Nightshadow1258/HW_Motor_Controller/Documentation/Plots/ADC_SOx_Noise/output/ADC_SOx_1000_Measurements_ADC_SAMPLETIME_32CYCLES_5_all.jpeg

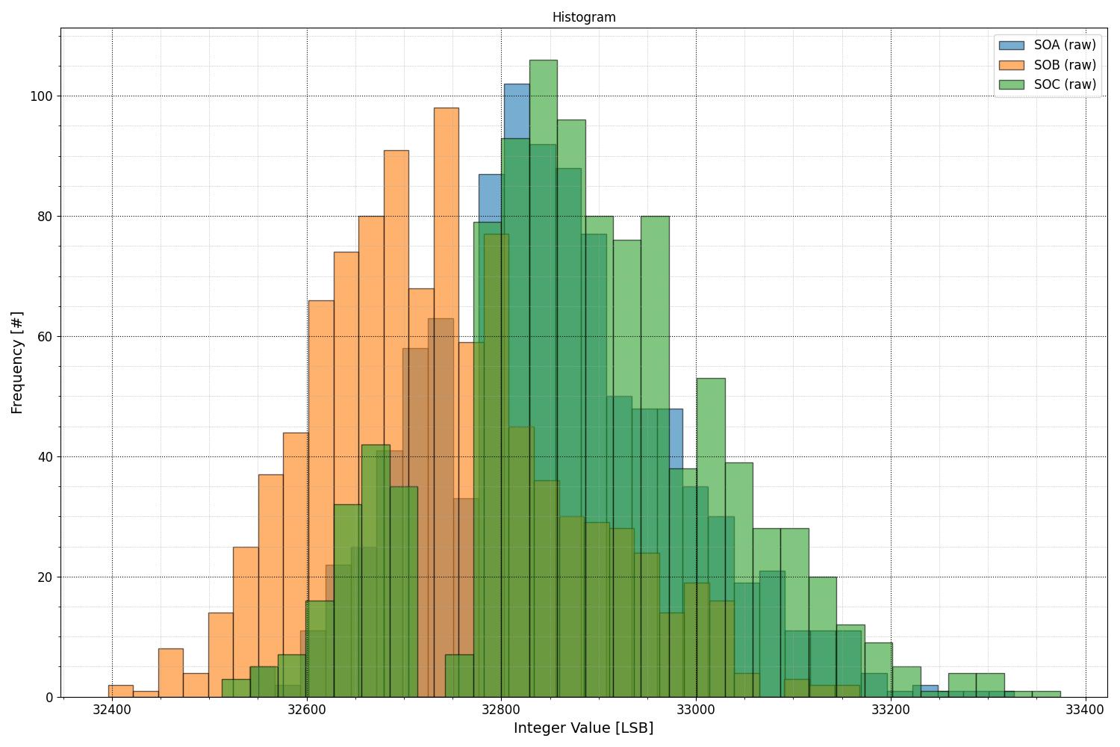
Documentation/Plots/ADC_SOx_Noise/output/ADC_SOx_1000_Measurements_ADC_SAMPLETIME_32CYCLES_5_all.jpeg
