Nightshadow1258/HW_Motor_Controller/Documentation/STMG474RE_Pinout.ods

Sheet: Front
taken from the pdf
file:///home/paul/Downloads/stm32g474re.pdf

Sheet: Pin Definitions
Name | Abbreviation | Definition
Pin name | Unless otherwise specified in brackets below the pin name, the pin function during and after reset is the same as the actual pin name
Pin type | S | Supply pin
 | I | Input only pin
 | I/O | Input / output pin
I/O structure | FT | 5 V tolerant I/O
 | TT | 3.6 V tolerant I/O
 | B | Dedicated BOOT0 pin
 | NRST | Bidirectional reset pin with embedded weak pull-up resistor
 | Option for TT or FT I/Os
 | _a(1) | I/O, with Analog switch function supplied by V DDA
 | _c | I/O, USB Type-C PD capable
 | _d | I/O, USB Type-C PD Dead Battery function
 | _f(2) | I/O, Fm+ capable
 | _u(3) | I/O, with USB function
Notes | Unless otherwise specified by a note, all I/Os are set as floating inputs during and after reset
Pin functions | Alternate functions | Functions selected through GPIOx_AFR registers
 | Additional functions | Functions directly selected/enabled through peripheral registers

Sheet: Pinout
WLCSP81 | UFQDPN48 | LQFP48 | LQDP64 | LQFP80 | TFBGA100 | LPQF100 | UFBGA121 | LPQF128 | Pin Name (function after reset) | Pin type | I/O structure | Notes | Alternate functions | Additional functions
- | - | - | - | - | C3 | 1 | A2 | 1 | PE2 | I/O | FT | - | TRACECK, TIM3_CH1, SAI1_CK1, SPI4_SCK, TIM20_CH1, FMC_A23, SAI1_MCLK_A, EVENTOUT | -
- | - | - | - | - | B2 | 2 | B2 | 2 | PE3 | I/O | FT | - | TRACED0, TIM3_CH2, SPI4_NSS, TIM20_CH2, FMC_A19, SAI1_SD_B, EVENTOUT | -
- | - | - | - | - | A1 | 3 | A1 | 3 | PE4 | I/O | FT | - | TRACED1, TIM3_CH3, SAI1_D2, SPI4_NSS, TIM20_CH1N, FMC_A20, SAI1_FS_A, EVENTOUT | -
- | - | - | - | - | B1 | 4 | B1 | 4 | PE5 | I/O | FT | - | TRACED2, TIM3_CH4, SAI1_CK2, SPI4_MISO, TIM20_CH2N, FMC_A21, SAI1_SCK_A, EVENTOUT | -
- | - | - | - | - | C2 | 5 | C3 | 5 | PE6 | I/O | FT | - | TRACED3, SAI1_D1, SPI4_MOSI, TIM20_CH3N, FMC_A22, SAI1_SD_A, EVENTOUT | WKUP3, RTC_TAMP3
B9 | 1 | 1 | 1 | 1 | D3 | 6 | C2 | 6 | VBAT | S | - | - | - | -
B8 | 2 | 2 | 2 | 2 | D4 | 7 | C1 | 7 | PC13 | I/O | FT | (2) (3) | TIM1_BKIN, TIM1_CH1N, TIM8_CH4N, EVENTOUT | WKUP2, RTC_TAMP1, RTC_TS, RTC_OUT1
C9 | 3 | 3 | 3 | 3 | C1 | 8 | D1 | 8 | PC14- OSC32_IN | I/O | FT | (2) (3) | EVENTOUT | OSC32_IN
D9 | 4 | 4 | 4 | 4 | D1 | 9 | D2 | 9 | PC15- OSC32_OUT | I/O | FT | (2) (3) | EVENTOUT | OSC32_OUT
- | - | - | - | - | - | - | D3 | 10 | PF3 | I/O | FT_f | - | TIM20_CH4, I2C3_SCL, FMC_A3, EVENTOUT | -
- | - | - | - | - | - | - | D4 | 11 | PF4 | I/O | FT_f | - | COMP1_OUT, TIM20_CH1N, I2C3_SDA, FMC_A4, EVENTOUT | -
F1 | - | - | - | - | D2 | - | E2 | 12 | VSS | S | - | - | - | -
A9 | - | - | - | - | D5 | - | E1 | 13 | VDD | S | - | - | - | -
- | - | - | - | - | - | - | E3 | 14 | PF5 | I/O | FT | - | TIM20_CH2N, FMC_A5, EVENTOUT | -
- | - | - | - | - | - | - | E4 | 15 | PF7 | I/O | FT | - | TIM20_BKIN, TIM5_CH2, QUADSPI1_BK1_IO2, FMC_A1, SAI1_MCLK_B, EVENTOUT | -
- | - | - | - | - | - | - | E5 | 16 | PF8 | I/O | FT | - | TIM20_BKIN2, TIM5_CH3, QUADSPI1_BK1_IO0, FMC_A24, SAI1_SCK_B, EVENTOUT | -
- | - | - | - | - | E3 | 10 | F3 | 17 | PF9 | I/O | FT | - | TIM20_BKIN, TIM15_CH1, SPI2_SCK, TIM5_CH4, QUADSPI1_BK1_IO1, FMC_A25, SAI1_FS_B, EVENTOUT | -
- | - | - | - | - | E4 | 11 | F4 | 18 | PF10 | I/O | FT | - | TIM20_BKIN2, TIM15_CH2, SPI2_SCK, QUADSPI1_CLK, FMC_A0, SAI1_D3, EVENTOUT | -
E9 | 5 | 5 | 5 | 5 | E1 | 12 | F1 | 19 | PF0-OSC_IN | I/O | FT_fa | - | I2C2_SDA, SPI2_NSS/I2S2_WS, TIM1_CH3N, EVENTOUT | ADC1_IN10, OSC_IN
F9 | 6 | 6 | 6 | 6 | E2 | 13 | F2 | 20 | PF1- OSC_OUT | I/O | FT_a | - | SPI2_SCK/I2S2_CK, EVENTOUT | ADC2_IN10, COMP3_INM, OSC_OUT
D8 | 7 | 7 | 7 | 7 | F3 | 14 | F5 | 21 | PG10-NRST | I/O | NRST (4) | - | MCO, EVENTOUT | NRST
E8 | - | - | 8 | 8 | F2 | 15 | G2 | 22 | PC0 | I/O | FT_a | - | LPTIM1_IN1, TIM1_CH1, LPUART1_RX, EVENTOUT | ADC12_IN6, COMP3_INM
C8 | - | - | 9 | 9 | F4 | 16 | G1 | 23 | PC1 | I/O | TT_a | - | LPTIM1_OUT, TIM1_CH2, LPUART1_TX, QUADSPI1_BK2_IO0, SAI1_SD_A, EVENTOUT | ADC12_IN7, COMP3_INP
F8 | - | - | 10 | 10 | F1 | 17 | G3 | 24 | PC2 | I/O | FT_a | - | LPTIM1_IN2, TIM1_CH3, COMP3_OUT, TIM20_CH2, QUADSPI1_BK2_IO1, EVENTOUT | ADC12_IN8
G9 | - | - | 11 | 11 | G1 | 18 | H1 | 25 | PC3 | I/O | TT_a | - | LPTIM1_ETR, TIM1_CH4, SAI1_D1, TIM1_BKIN2, QUADSPI1_BK2_IO2, SAI1_SD_A, EVENTOUT | ADC12_IN9, OPAMP5_VINP
- | - | - | - | - | G3 | 19 | H2 | 26 | PF2 | I/O | FT | - | TIM20_CH3, I2C2_SMBA, FMC_A2, EVENTOUT | -
D7 | 8 | 8 | 12 | 12 | G4 | 20 | G4 | 27 | PA0 | I/O | TT_a | - | TIM2_CH1, TIM5_CH1, USART2_CTS, COMP1_OUT, TIM8_BKIN, TIM8_ETR, TIM2_ETR, EVENTOUT | ADC12_IN1, COMP1_INM, COMP3_INP, RTC_TAMP2,WK UP1
E7 | 9 | 9 | 13 | 13 | G2 | 21 | H3 | 28 | PA1 | I/O | TT_a | - | RTC_REFIN, TIM2_CH2, TIM5_CH2, USART2_RTS_DE, TIM15_CH1N, EVENTOUT | ADC12_IN2, COMP1_INP, OPAMP1_VINP, OPAMP3_VINP, OPAMP6_VINM
G8 | 10 | 10 | 14 | 14 | H1 | 22 | J3 | 29 | PA2 | I/O | FT_a | - | TIM2_CH3, TIM5_CH3, USART2_TX, COMP2_OUT, TIM15_CH1, QUADSPI1_BK1_NCS , LPUART1_TX, UCPD1_FRSTX, EVENTOUT | ADC1_IN3, COMP2_INM, OPAMP1_VOUT, WKUP4/LSCO
H9 | - | - | 15 | 15 | D6 | 23 | J2 | 30 | VSS | S | - | - | - | -
J9 | - | - | 16 | 16 | D7 | 24 | J1 | 31 | VDD | S | - | - | - | -
H8 | 11 | 11 | 17 | 17 | H3 | 25 | K1 | 32 | PA3 | I/O | TT_a | - | TIM2_CH4, TIM5_CH4, SAI1_CK1, USART2_RX, TIM15_CH2, QUADSPI1_CLK, LPUART1_RX, SAI1_MCLK_A, EVENTOUT | ADC1_IN4, COMP2_INP, OPAMP1_VINM/ OPAMP 1_VINP, OPAMP5_VINM
D6 | 12 | 12 | 18 | 18 | H2 | 26 | L1 | 33 | PA4 | I/O | TT_a | - | TIM3_CH2, SPI1_NSS, SPI3_NSS/I2S3_WS, USART2_CK, SAI1_FS_B, EVENTOUT | ADC2_IN17, DAC1_OUT1, COMP1_INM
F7 | 13 | 13 | 19 | 19 | J1 | 27 | K2 | 34 | PA5 | I/O | TT_a | - | TIM2_CH1, TIM2_ETR, SPI1_SCK, UCPD1_FRSTX, EVENTOUT | ADC2_IN13, DAC1_OUT2, COMP2_INM, OPAMP2_VINM
G7 | 14 | 14 | 20 | 20 | J2 | 28 | L2 | 35 | PA6 | I/O | TT_a | - | TIM16_CH1, TIM3_CH1, TIM8_BKIN, SPI1_MISO, TIM1_BKIN, COMP1_OUT, QUADSPI1_BK1_IO3, LPUART1_CTS, EVENTOUT | ADC2_IN3, DAC2_OUT1, OPAMP2_VOUT
J8 | 15 | 15 | 21 | 21 | K1 | 29 | K3 | 36 | PA7 | I/O | TT_a | - | TIM17_CH1, TIM3_CH2, TIM8_CH1N, SPI1_MOSI, TIM1_CH1N, COMP2_OUT, QUADSPI1_BK1_IO2, UCPD1_FRSTX, EVENTOUT | ADC2_IN4, COMP2_INP, OPAMP1_VINP, OPAMP2_VINP
E6 | 16 | - | 22 | 22 | K2 | 30 | L3 | 37 | PC4 | I/O | FT_fa | - | TIM1_ETR, I2C2_SCL, USART1_TX, QUADSPI1_BK2_IO3, EVENTOUT | ADC2_IN5
H7 | - | - | 23 | 23 | J3 | 31 | H4 | 38 | PC5 | I/O | TT_a | - | TIM15_BKIN, SAI1_D3, TIM1_CH4N, USART1_RX, HRTIM1_EEV10, EVENTOUT | ADC2_IN11, OPAMP1_VINM, OPAMP2_VINM, WKUP5
F6 | 17 | 16 | 24 | 24 | H4 | 32 | J4 | 39 | PB0 | I/O | TT_a | - | TIM3_CH3, TIM8_CH2N, TIM1_CH2N, QUADSPI1_BK1_IO1, HRTIM1_FLT5, UCPD1_FRSTX, EVENTOUT | ADC3_IN12/ ADC1_IN15, COMP4_INP, OPAMP2_VINP, OPAMP3_VINP
G6 | 18 | 17 | 25 | 25 | K3 | 33 | G5 | 40 | PB1 | I/O | TT_a | - | TIM3_CH4, TIM8_CH3N, TIM1_CH3N, COMP4_OUT, QUADSPI1_BK1_IO0, LPUART1_RTS_DE,H RTIM1_SCOUT, EVENTOUT | ADC3_IN1/ ADC1_IN12, COMP1_INP, OPAMP3_VOUT, OPAMP6_VINM
J7 | 19 | 18 | 26 | 26 | J4 | 34 | K4 | 41 | PB2 | I/O | TT_a | - | RTC_OUT2, LPTIM1_OUT, TIM5_CH1, TIM20_CH1, I2C3_SMBA, QUADSPI1_BK2_IO1, HRTIM1_SCIN, EVENTOUT | ADC2_IN12, COMP4_INM, OPAMP3_VINM
H6 | - | 19 | 27 | 27 | K4 | 35 | K5 | 42 | VSSA | S | - | - | - | -
J6 | 20 | 20 | 28 | 28 | K5 | 36 | L4 | 43 | VREF+ | S | - | - | - | VREFBUF_OUT
- | - | - | - | - | - | - | - | 44 | VREF+ | S | - | - | - | VREFBUF_OUT
J5 | 21 | 21 | 29 | 29 | J5 | 37 | L5 | 45 | VDDA | S | - | - | - | -
H9 | - | - | - | - | E5 | - | K6 | 46 | VSS | S | - | - | - | -
J1 | - | - | - | - | F5 | - | L6 | 47 | VDD | S | - | - | - | -
- | - | - | - | - | - | - | J5 | 48 | PF11 | I/O | FT | - | TIM20_ETR, FMC_NE4, EVENTOUT | -
- | - | - | - | - | - | - | H5 | 49 | PF12 | I/O | FT | - | TIM20_CH1, FMC_A6, EVENTOUT | -
- | - | - | - | - | - | - | J6 | 50 | PF13 | I/O | FT | - | TIM20_CH2, I2C4_SMBA, FMC_A7, EVENTOUT | -
- | - | - | - | - | - | - | H6 | 51 | PF14 | I/O | FT_f | - | TIM20_CH3, I2C4_SCL, FMC_A8, EVENTOUT | -
- | - | - | - | - | - | - | G6 | 52 | PF15 | I/O | FT_f | - | TIM20_CH4, I2C4_SDA, FMC_A9, EVENTOUT | -
H5 | - | - | - | 30 | G5 | 38 | L7 | 53 | PE7 | I/O | TT_a | - | TIM1_ETR, FMC_D4, SAI1_SD_B, EVENTOUT | ADC3_IN4, COMP4_INP
G5 | - | - | - | 31 | H5 | 39 | K7 | 54 | PE8 | I/O | FT_a | - | TIM5_CH3, TIM1_CH1N, FMC_D5, SAI1_SCK_B, EVENTOUT | ADC345_IN6, COMP4_INM
F5 | - | - | - | 32 | H6 | 40 | J7 | 55 | PE9 | I/O | FT_a | - | TIM5_CH4, TIM1_CH1, FMC_D6, SAI1_FS_B, EVENTOUT | ADC3_IN2
J4 | - | - | - | 33 | K6 | 41 | H7 | 56 | PE10 | I/O | FT_a | - | TIM1_CH2N, QUADSPI1_CLK, FMC_D7, SAI1_MCLK_B, EVENTOUT | ADC345_IN14
H4 | - | - | - | 34 | J6 | 42 | L8 | 57 | PE11 | I/O | FT_a | - | TIM1_CH2, SPI4_NSS, QUADSPI1_BK1_NCS , FMC_D8, EVENTOUT | ADC345_IN15
E5 | - | - | - | 35 | G6 | 43 | K8 | 58 | PE12 | I/O | FT_a | - | TIM1_CH3N, SPI4_SCK, QUADSPI1_BK1_IO0, FMC_D9, EVENTOUT | ADC345_IN16
G4 | - | - | - | 36 | K7 | 44 | J8 | 59 | PE13 | I/O | FT_a | - | TIM1_CH3, SPI4_MISO, QUADSPI1_BK1_IO1, FMC_D10, EVENTOUT | ADC3_IN3
J3 | - | - | - | 37 | J7 | 45 | K9 | 60 | PE14 | I/O | FT_a | - | TIM1_CH4, SPI4_MOSI, TIM1_BKIN2, QUADSPI1_BK1_IO2, FMC_D11, EVENTOUT | ADC4_IN1
F4 | - | - | - | 38 | H7 | 46 | L9 | 61 | PE15 | I/O | FT_a | - | TIM1_BKIN, TIM1_CH4N, USART3_RX, QUADSPI1_BK1_IO3, FMC_D12, EVENTOUT | ADC4_IN2
H3 | 22 | 22 | 30 | 39 | J8 | 47 | L10 | 62 | PB10 | I/O | TT_a | - | TIM2_CH3, USART3_TX, LPUART1_RX, QUADSPI1_CLK, TIM1_BKIN, HRTIM1_FLT3, SAI1_SCK_A, EVENTOUT | COMP5_INM, OPAMP3_VINM, OPAMP4_VINM
J2 | - | 23 | 31 | 40 | E6 | 48 | K10 | 63 | VSS | S | - | - | - | -
J1 | 23 | 24 | 32 | 41 | F7 | 49 | K11 | 64 | VDD | S | - | - | - | -
H2 | 24 | 25 | 33 | 42 | H8 | 50 | L11 | 65 | PB11 | I/O | TT_a | - | TIM2_CH4, USART3_RX, LPUART1_TX, QUADSPI1_BK1_NCS , HRTIM1_FLT4, EVENTOUT | ADC12_IN14, COMP6_INP, OPAMP4_VINP, OPAMP6_VOUT
G3 | 25 | 26 | 34 | 43 | K8 | 51 | J9 | 66 | PB12 | I/O | TT_a | - | TIM5_ETR, I2C2_SMBA, SPI2_NSS/I2S2_WS, TIM1_BKIN, USART3_CK, LPUART1_RTS_DE, FDCAN2_RX, HRTIM1_CHC1, EVENTOUT | ADC4_IN3/ ADC1_IN11, COMP7_INM, OPAMP4_VOUT, OPAMP6_VINP
H1 | 26 | 27 | 35 | 44 | J9 | 52 | J11 | 67 | PB13 | I/O | TT_a | - | SPI2_SCK/I2S2_CK, TIM1_CH1N, USART3_CTS, LPUART1_CTS, FDCAN2_TX, HRTIM1_CHC2, EVENTOUT | ADC3_IN5, COMP5_INP, OPAMP3_VINP, OPAMP4_VINP, OPAMP6_VINP
G2 | 27 | 28 | 36 | 45 | H9 | 53 | J10 | 68 | PB14 | I/O | TT_a | - | TIM15_CH1, SPI2_MISO, TIM1_CH2N, USART3_RTS_DE, COMP4_OUT, HRTIM1_CHD1, EVENTOUT | ADC4_IN4/ ADC1_IN5, COMP7_INP, OPAMP2_VINP, OPAMP5_VINP
E4 | 28 | 29 | 37 | 46 | K9 | 54 | H8 | 69 | PB15 | I/O | TT_a | - | RTC_REFIN, TIM15_CH2, TIM15_CH1N, COMP3_OUT, TIM1_CH3N, SPI2_MOSI/I2S2_SD, HRTIM1_CHD2, EVENTOUT | ADC4_IN5/ ADC2_IN15, COMP6_INM, OPAMP5_VINM
G1 | - | - | - | 47 | K10 | 55 | H9 | 70 | PD8 | I/O | TT_a | - | USART3_TX, FMC_D13, EVENTOUT | ADC4_IN12/ ADC5_IN12, OPAMP4_VINM
F3 | - | - | - | 48 | G8 | 56 | H10 | 71 | PD9 | I/O | TT_a | - | USART3_RX, FMC_D14, EVENTOUT | ADC4_IN13/ ADC5_IN13, OPAMP6_VINP
F2 | - | - | - | 49 | G7 | 57 | H11 | 72 | PD10 | I/O | FT_a | - | USART3_CK, FMC_D15, EVENTOUT | ADC345_IN7, COMP6_INM
E2 | - | - | - | - | H10 | 58 | G7 | 73 | PD11 | I/O | TT_a | - | TIM5_ETR, I2C4_SMBA, USART3_CTS, FMC_A16, EVENTOUT | ADC345_IN8, COMP6_INP, OPAMP4_VINP
- | - | - | - | - | J10 | 59 | G8 | 74 | PD12 | I/O | TT_a | - | TIM4_CH1, USART3_RTS_DE, FMC_A17, EVENTOUT | ADC345_IN9, COMP5_INP, OPAMP5_VINP
- | - | - | - | - | G9 | 60 | G9 | 75 | PD13 | I/O | FT_a | - | TIM4_CH2, FMC_A18, EVENTOUT | ADC345_IN10, COMP5_INM
- | - | - | - | - | F8 | 61 | G10 | 76 | PD14 | I/O | TT_a | - | TIM4_CH3, FMC_D0, EVENTOUT | ADC345_IN11, COMP7_INP, OPAMP2_VINP
- | - | - | - | - | G10 | 62 | F6 | 77 | PD15 | I/O | FT_a | - | TIM4_CH4, SPI2_NSS, FMC_D1, EVENTOUT | COMP7_INM
B1 | - | - | - | 50 | E7 | 63 | - | 78 | VSS | S | - | - | - | -
E1 | - | - | - | 51 | - | 64 | G11 | 79 | VDD | S | - | - | - | -
E3 | 29 | - | 38 | 52 | F9 | 65 | F10 | 80 | PC6 | I/O | FT_f | - | TIM3_CH1, HRTIM1_EEV10, TIM8_CH1, I2S2_MCK, COMP6_OUT, I2C4_SCL, HRTIM1_CHF1, EVENTOUT | -
D5 | - | - | 39 | 53 | F10 | 66 | F11 | 81 | PC7 | I/O | FT_f | - | TIM3_CH2, HRTIM1_FLT5, TIM8_CH2, I2S3_MCK, COMP5_OUT, I2C4_SDA, HRTIM1_CHF2, EVENTOUT | -
- | - | - | - | - | - | - | F9 | 82 | PG0 | I/O | FT | - | TIM20_CH1N, FMC_A10, EVENTOUT | -
- | - | - | - | - | - | - | F8 | 83 | PG1 | I/O | FT | - | TIM20_CH2N, FMC_A11, EVENTOUT | -
- | - | - | - | - | - | - | F7 | 84 | PG2 | I/O | FT | - | TIM20_CH3N, SPI1_SCK, FMC_A12, EVENTOUT | -
- | - | - | - | - | - | - | E11 | 85 | PG3 | I/O | FT_f | - | TIM20_BKIN, I2C4_SCL, SPI1_MISO, TIM20_CH4N, FMC_A13, EVENTOUT | -
- | - | - | - | - | - | - | E10 | 86 | PG4 | I/O | FT_f | - | TIM20_BKIN2, I2C4_SDA, SPI1_MOSI, FMC_A14, EVENTOUT | -
C5 | - | - | 40 | 54 | E8 | 67 | E9 | 87 | PC8 | I/O | FT_f | - | TIM3_CH3, HRTIM1_CHE1, TIM8_CH3, TIM20_CH3, COMP7_OUT, I2C3_SCL, EVENTOUT | -
D2 | - | - | 41 | 55 | E9 | 68 | E8 | 88 | PC9 | I/O | FT_f | - | TIM3_CH4, HRTIM1_CHE2, TIM8_CH4, I2SCKIN, TIM8_BKIN2, I2C3_SDA, EVENTOUT | -
D1 | 30 | 30 | 42 | 56 | E10 | 69 | E7 | 89 | PA8 | I/O | FT_a | - | MCO, I2C3_SCL, I2C2_SDA, I2S2_MCK, TIM1_CH1, USART1_CK, COMP7_OUT, TIM4_ETR, FDCAN3_RX, SAI1_CK2, HRTIM1_CHA1, SAI1_SCK_A, EVENTOUT | ADC5_IN1, OPAMP5_VOUT
D4 | 31 | 31 | 43 | 57 | D10 | 70 | D8 | 90 | PA9 | I/O | FT_fda | - | I2C3_SMBA, I2C2_SCL, I2S3_MCK, TIM1_CH2, USART1_TX, OMP5_OUT, TIM15_BKIN, TIM2_CH3, HRTIM1_CHA2, SAI1_FS_A, EVENTOUT | ADC5_IN2, UCPD1_DBCC1
D3 | 32 | 32 | 44 | 58 | D9 | 71 | D9 | 91 | PA10 | I/O | FT_fda | - | TIM17_BKIN, USB_CRS_SYNC, I2C2_SMBA, SPI2_MISO, TIM1_CH3, USART1_RX, COMP6_OUT, TIM2_CH4, TIM8_BKIN, SAI1_D1, HRTIM1_CHB1, SAI1_SD_A, EVENTOUT | UCPD1_DBCC2, PVD_IN
C2 | 33 | 33 | 45 | 59 | C10 | 72 | D11 | 92 | PA11 | I/O | FT_u | - | SPI2_MOSI/I2S2_SD, TIM1_CH1N, USART1_CTS, COMP1_OUT, FDCAN1_RX, TIM4_CH1, TIM1_CH4, TIM1_BKIN2, HRTIM1_CHB2, EVENTOUT | USB_DM
C1 | 34 | 34 | 46 | 60 | C9 | 73 | D10 | 93 | PA12 | I/O | FT_u | - | TIM16_CH1, I2SCKIN, TIM1_CH2N, USART1_RTS_DE, COMP2_OUT, FDCAN1_TX, TIM4_CH2, TIM1_ETR, HRTIM1_FLT1, EVENTOUT | USB_DP
A8 | - | 35 | 47 | 61 | F6 | 74 | C10 | 94 | VSS | S | - | - | - | -
A1 | 35 | 36 | 48 | 62 | - | 75 | C11 | 95 | VDD | S | - | - | - | -
B2 | 36 | 37 | 49 | 63 | D8 | 76 | B11 | 96 | PA13 | I/O | FT_f | (5) | SWDIO-JTMS, TIM16_CH1N, I2C4_SCL, I2C1_SCL, IR_OUT, USART3_CTS, TIM4_CH3, SAI1_SD_B, EVENTOUT | -
- | - | - | - | - | - | - | A11 | 97 | PF6 | I/O | FT_f | - | TIM5_ETR, TIM4_CH4, SAI1_SD_B, I2C2_SCL, TIM5_CH1, USART3_RTS, QUADSPI1_BK1_IO3, EVENTOUT | -
C3 | 37 | 38 | 50 | 64 | B10 | 77 | B10 | 98 | PA14 | I/O | FT_f | (5) | SWCLK-JTCK, LPTIM1_OUT, I2C4_SMBA, I2C1_SDA, TIM8_CH2, TIM1_BKIN, USART2_TX, SAI1_FS_B, EVENTOUT | -
A2 | 38 | 39 | 51 | 65 | B9 | 78 | A10 | 99 | PA15 | I/O | FT_f | (5) | JTDI, TIM2_CH1, TIM8_CH1, I2C1_SCL, SPI1_NSS, SPI3_NSS/I2S3_WS, USART2_RX, UART4_RTS_DE, TIM1_BKIN, FDCAN3_TX, HRTIM1_FLT2, TIM2_ETR, EVENTOUT | -
B3 | 39 | - | 52 | 66 | C8 | 79 | C9 | 100 | PC10 | I/O | FT | - | TIM8_CH1N, UART4_TX, SPI3_SCK/I2S3_CK, USART3_TX, HRTIM1_FLT6, EVENTOUT | -
C4 | 40 | - | 53 | 67 | C7 | 80 | C8 | 101 | PC11 | I/O | FT_f | - | HRTIM1_EEV2, TIM8_CH2N, UART4_RX, SPI3_MISO, USART3_RX, I2C3_SDA, EVENTOUT | -
A3 | - | - | 54 | 68 | A10 | 81 | D7 | 102 | PC12 | I/O | FT | - | TIM5_CH2, HRTIM1_EEV1, TIM8_CH3N, UART5_TX, SPI3_MOSI/I2S3_SD, USART3_CK, UCPD1_FRSTX, EVENTOUT | -
- | - | - | - | - | - | - | - | 103 | PG5 | I/O | FT | - | TIM20_ETR, SPI1_NSS, LPUART1_CTS, FMC_A15, EVENTOUT | -
- | - | - | - | - | - | - | - | 104 | PG6 | I/O | FT | - | TIM20_BKIN, I2C3_SMBA, LPUART1_RTS_DE, FMC_INT, EVENTOUT | -
- | - | - | - | - | - | - | - | 105 | PG7 | I/O | FT_f | - | SAI1_CK1, I2C3_SCL, LPUART1_TX, FMC_INT, SAI1_MCLK_A, EVENTOUT | -
- | - | - | - | - | - | - | - | 106 | PG8 | I/O | FT_f | - | I2C3_SDA, LPUART1_RX, FMC_NE3, EVENTOUT | -
- | - | - | - | - | - | - | - | 107 | PG9 | I/O | FT | - | SPI3_SCK, USART1_TX, FMC_NCE/FMC_NE2, TIM15_CH1N, EVENTOUT | -
B4 | - | - | - | 69 | B8 | 82 | B9 | 108 | PD0 | I/O | FT | - | TIM8_CH4N, FDCAN1_RX, FMC_D2, EVENTOUT | -
A4 | - | - | - | 70 | A9 | 83 | A9 | 109 | PD1 | I/O | FT | - | TIM8_CH4, TIM8_BKIN2, FDCAN1_TX, FMC_D3, EVENTOUT | -
- | - | - | - | - | - | - | B8 | 110 | VSS | S | - | - | - | -
A1 | - | - | - | - | - | - | A8 | 111 | VDD | S | - | - | - | -
B5 | - | - | 55 | 71 | B7 | 84 | C7 | 112 | PD2 | I/O | FT | - | TIM3_ETR, TIM8_BKIN, UART5_RX, EVENTOUT | -
- | - | - | - | - | C6 | 85 | B7 | 113 | PD3 | I/O | FT | - | TIM2_CH1/ TIM2_ETR, USART2_CTS, QUADSPI1_BK2_NCS , FMC_CLK, EVENTOUT | -
- | - | - | - | - | A8 | 86 | A7 | 114 | PD4 | I/O | FT | - | TIM2_CH2, USART2_RTS_DE, QUADSPI1_BK2_IO0, FMC_NOE, EVENTOUT | -
- | - | - | - | - | A7 | 87 | E6 | 115 | PD5 | I/O | FT | - | USART2_TX, QUADSPI1_BK2_IO1, FMC_NWE, EVENTOUT | -
- | - | - | - | - | A6 | 88 | D6 | 116 | PD6 | I/O | FT | - | TIM2_CH4, SAI1_D1, USART2_RX, QUADSPI1_BK2_IO2, FMC_NWAIT, SAI1_SD_A, EVENTOUT | -
- | - | - | - | - | B6 | 89 | B6 | 117 | PD7 | I/O | FT | - | TIM2_CH3, USART2_CK, QUADSPI1_BK2_IO3, FMC_NCE/FMC_NE1, EVENTOUT | -
A5 | 41 | 40 | 56 | 72 | A5 | 90 | A6 | 118 | PB3 | I/O | FT | (5) | JTDO-TRACESWO, TIM2_CH2, TIM4_ETR, UCPD1_CRS_SYNC, TIM8_CH1N, SPI1_SCK, SPI3_SCK/I2S3_CK, USART2_TX, TIM3_ETR, FDCAN3_RX, HRTIM1_SCOUT, HRTIM1_EEV9, SAI1_SCK_B, EVENTOUT | -
C6 | 42 | 41 | 57 | 73 | C5 | 91 | C6 | 119 | PB4 | I/O | FT_c | (5) (6) | JTRST, TIM16_CH1, TIM3_CH1, TIM8_CH2N, SPI1_MISO, SPI3_MISO, USART2_RX, UART5_RTS_DE, TIM17_BKIN, FDCAN3_TX, HRTIM1_EEV7, SAI1_MCLK_B, EVENTOUT | UCPD1_CC2
A6 | 43 | 42 | 58 | 74 | B5 | 92 | B5 | 120 | PB5 | I/O | FT_f | - | TIM16_BKIN, TIM3_CH2, TIM8_CH3N, I2C1_SMBA, SPI1_MOSI, SPI3_MOSI/I2S3_SD, USART2_CK, I2C3_SDA, FDCAN2_RX, TIM17_CH1, LPTIM1_IN1, SAI1_SD_B, HRTIM1_EEV6, UART5_CTS, EVENTOUT | -
B6 | 44 | 43 | 59 | 75 | A4 | 93 | A5 | 121 | PB6 | I/O | FT_c | (6) | TIM16_CH1N, TIM4_CH1, TIM8_CH1, TIM8_ETR, USART1_TX, COMP4_OUT, FDCAN2_TX, TIM8_BKIN2, LPTIM1_ETR, HRTIM1_SCIN, HRTIM1_EEV4, SAI1_FS_B, EVENTOUT | UCPD1_CC1
C7 | 45 | 44 | 60 | 76 | B4 | 94 | C5 | 122 | PB7 | I/O | FT_f | - | TIM17_CH1N, TIM4_CH2, I2C4_SDA, I2C1_SDA, TIM8_BKIN, USART1_RX, COMP3_OUT, TIM3_CH4, LPTIM1_IN2, FMC_NL, HRTIM1_EEV3, UART4_CTS, EVENTOUT | -
B7 | 46 | 45 | 61 | 77 | A3 | 95 | D5 | 123 | PB8-BOOT0 | I/O | FT_f | (7) | TIM16_CH1, TIM4_CH3, SAI1_CK1, I2C1_SCL, USART3_RX, COMP1_OUT, FDCAN1_RX, TIM8_CH2, TIM1_BKIN, HRTIM1_EEV8, SAI1_MCLK_A, EVENTOUT | -
A7 | 47 | 46 | 62 | 78 | A2 | 96 | A4 | 124 | PB9 | I/O | FT_f | - | TIM17_CH1, TIM4_CH4, SAI1_D2, I2C1_SDA, IR_OUT, USART3_TX, COMP2_OUT, FDCAN1_TX, TIM8_CH3, TIM1_CH3N, HRTIM1_EEV5, SAI1_FS_A, EVENTOUT | -
- | - | - | - | - | C4 | 97 | B4 | 125 | PE0 | I/O | FT | - | TIM4_ETR, TIM20_CH4N, TIM16_CH1, TIM20_ETR, USART1_TX, FMC_NBL0, EVENTOUT | -
- | - | - | - | - | B3 | 98 | C4 | 126 | PE1 | I/O | FT | - | TIM17_CH1, TIM20_CH4, USART1_RX, FMC_NBL1, EVENTOUT | -
- | - | 47 | 63 | 79 | - | 99 | B3 | 127 | VSS | S | - | - | - | -
A9 | 48 | 48 | 64 | 80 | - | 100 | A3 | 128 | VDD | S | - | - | - | -
