Nightshadow1258/HW_Motor_Controller/Documentation/Diagrams/Design_Overview.jpg

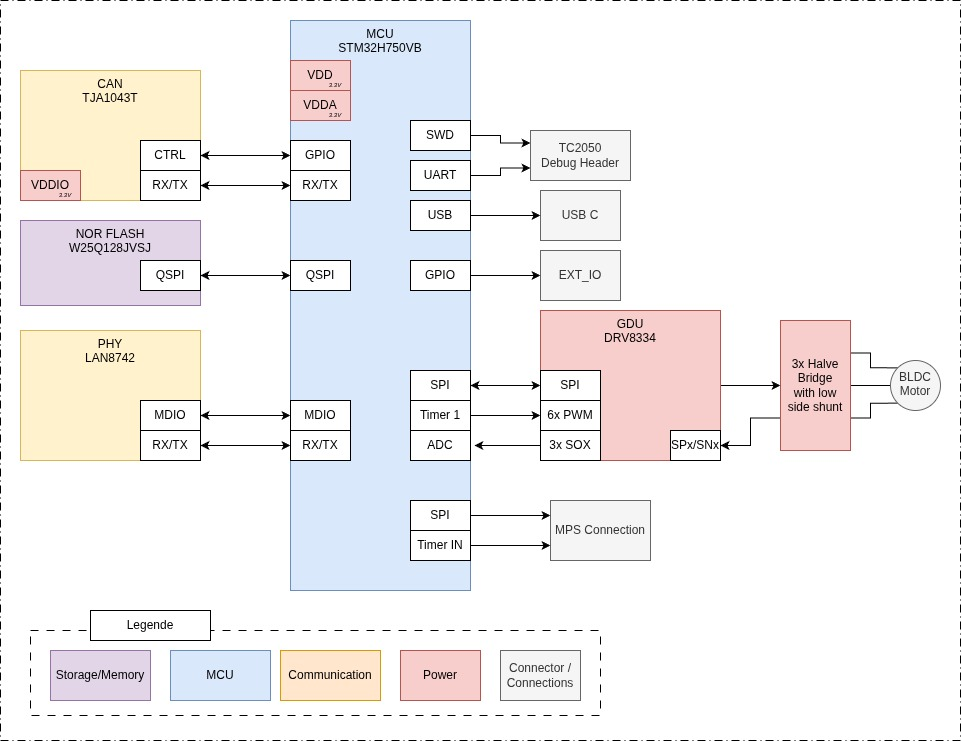
Documentation/Diagrams/Design_Overview.jpg
