Nightshadow1258/HW_Motor_Controller/Documentation/Diagrams/PWM.png

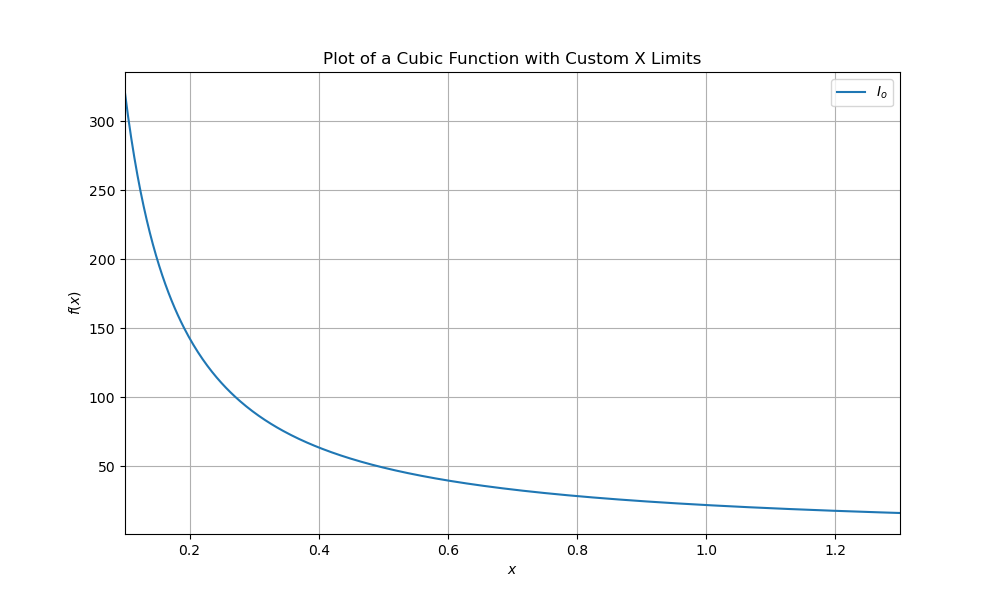
Documentation/Diagrams/PWM.png
