Nightshadow1258/HW_Motor_Controller/Documentation/Plots/AS5047P/plot_xy/output/AS5047P_4096_BLDC_Mot_filtered.png

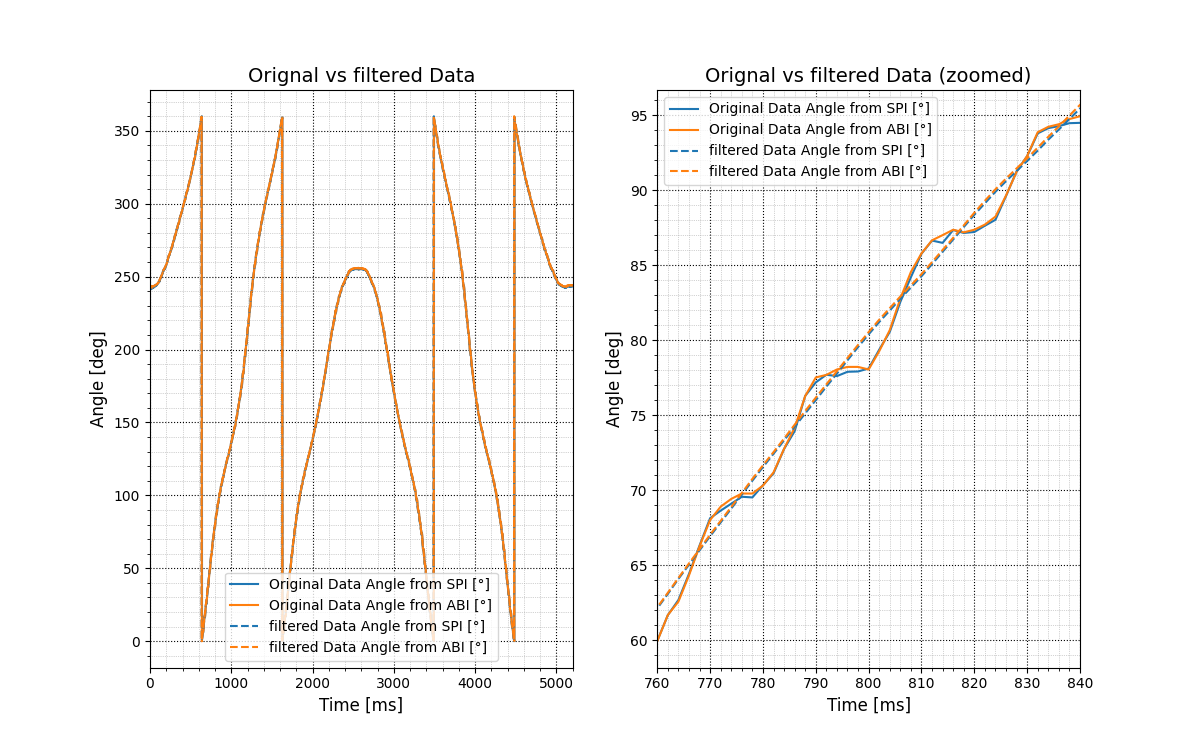
Documentation/Plots/AS5047P/plot_xy/output/AS5047P_4096_BLDC_Mot_filtered.png
