Nightshadow1258/HW_Motor_Controller/Documentation/Plots/DRV8334/output/DRV8334_12V_Deadtime_falling_(GLA)_(GHA).jpeg

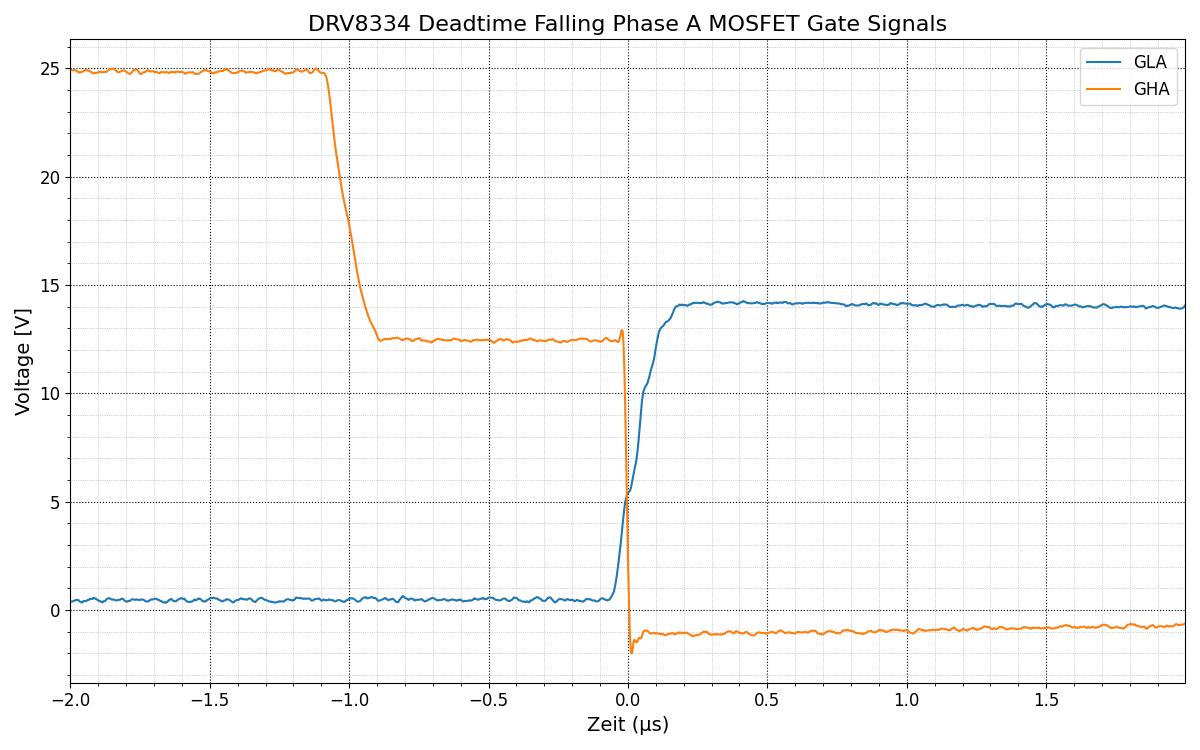
Documentation/Plots/DRV8334/output/DRV8334_12V_Deadtime_falling_(GLA)_(GHA).jpeg
