Nightshadow1258/HW_Motor_Controller/Documentation/Plots/DRV8334_Current/output/DRV8334_12V_OpenLoop_1Hz_(PHA)_(SOC).jpeg

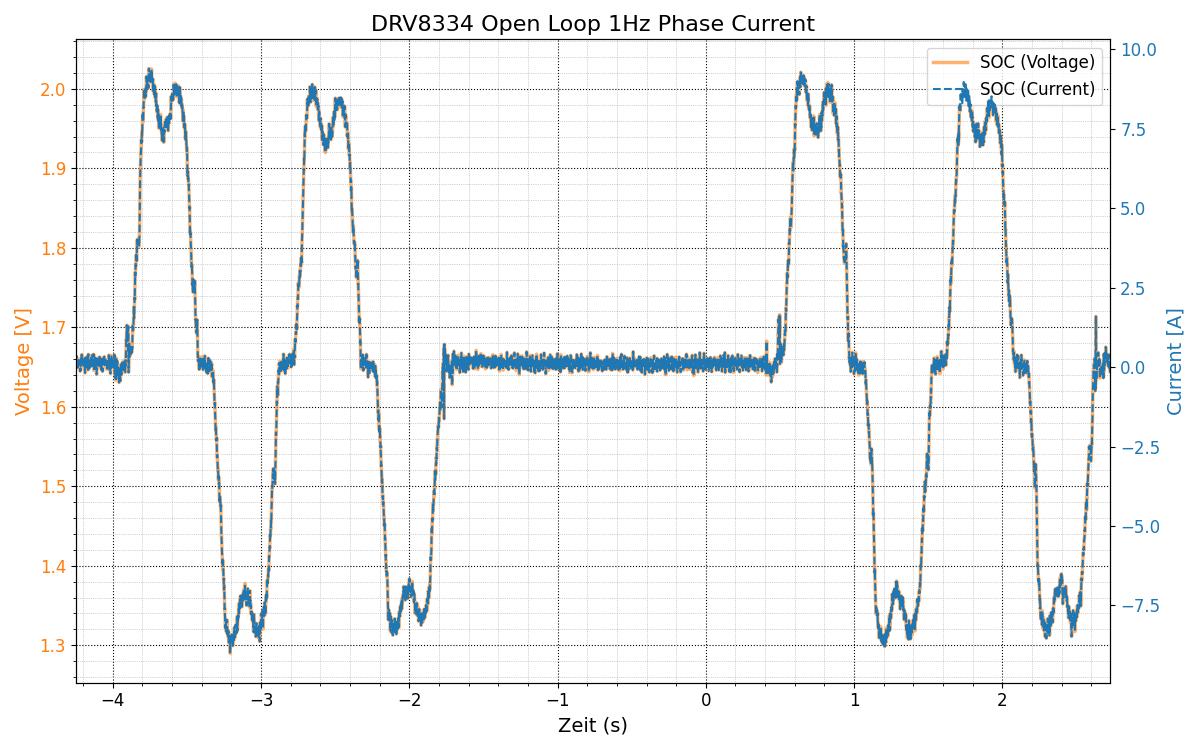
Documentation/Plots/DRV8334_Current/output/DRV8334_12V_OpenLoop_1Hz_(PHA)_(SOC).jpeg
