Nightshadow1258/HW_Motor_Controller/KiCAD/AS5047P_DevKit/production/bom.csv

Designator | Footprint | Quantity | Value | LCSC Part #
C102 | 0402 | 1 | 100nF | C1525
C103 | 0402 | 1 | 1uF | C15525
FID101, FID102, FID103, FID104 | PCB-FID-JLCPCB | 4 | Fiducal-JLCPPCB
IC101 | TSSOP-14_4.4x5mm_P0.65mm | 1 | IC-SENS-AS5047P | C962063
J102 | PinHeader_2x07_P2.54mm_Vertical | 1 | Conn_02x07_Odd_Even
MH101, MH102, MH103, MH104 | MountingHole_2.5mm_Pad_Via | 4 | ~
PCB101, PCB102, PCB103, PCB104 | PCB-NPTH-JLCPCB | 4 | Tooling Hole JLCPCB
