Nightshadow1258/HW_Motor_Controller/KiCAD/AS5047P_DevKit/3D_Export/AS5047P_DevKit.step

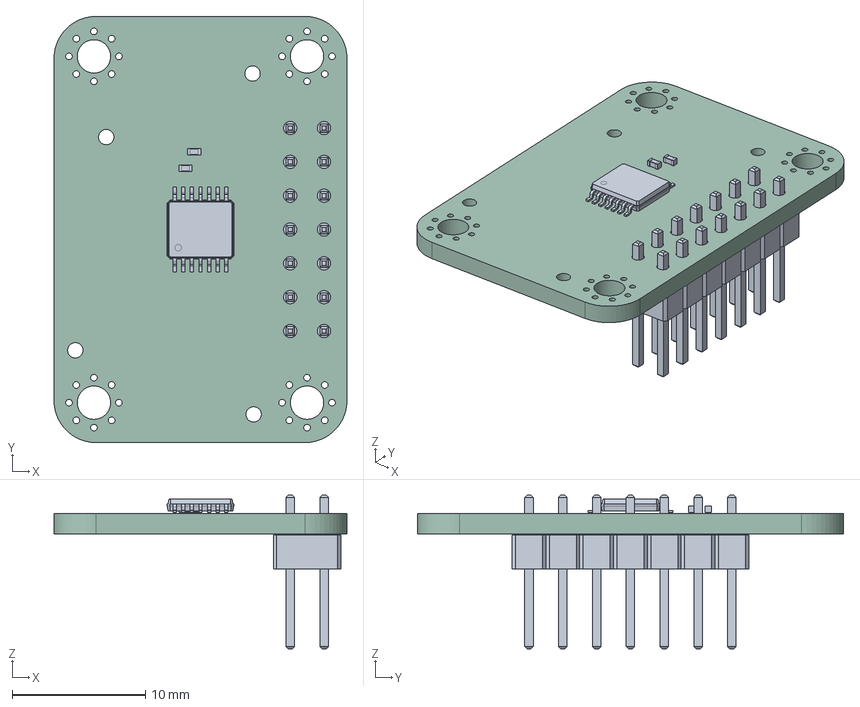
[picture p19: CAD file, 2026-01-12]
KiCAD/AS5047P_DevKit/3D_Export/AS5047P_DevKit.step
22.0 x 32.0 x 11.5 mm
TSSOP-14_4.4x5mm_P0.65mm
C_0402_1005Metric x 2
PinHeader_2x07_P2.54mm_Vertical
AS5047P_DevKit_PCB
