Nightshadow1258/HW_Motor_Controller/Documentation/Plots/ADC_SOx_Noise/output/ADC_SOx_1000_Measurements_ADC_SAMPLETIME_32CYCLES_5.pdf

32600 | 32800 | 33000 | 33200

### Interger [LSB]

0

20

40

60

80

100

### Frequency [#]

ADC Histogram of SOA (raw) Mean=32853.25, Std=126.86
Min=32541.00, Max=33327.00, delta=786
32400 | 32600 | 32800 | 33000 | 33200

### Interger [LSB]

0

20

40

60

80

100

### Frequency [#]

ADC Histogram of SOB (raw) Mean=32736.07, Std=128.45
Min=32396.00, Max=33168.00, delta=772
32600 | 32800 | 33000 | 33200 | 33400

### Interger [LSB]

0

20

40

60

80

100

### Frequency [#]

ADC Histogram of SOC (raw) Mean=32886.82, Std=140.93
Min=32513.00, Max=33374.00, delta=861
