Nightshadow1258/HW_Motor_Controller/Documentation/Plots/ADC_SOx_Noise/input/ADC_SOx_1000_Measurements_ADC_SAMPLETIME_32CYCLES_5.csv

SOA (raw) | SOB (raw) | SOC (raw)
32934 | 32900 | 33021
32876 | 32753 | 32948
32987 | 32734 | 33040
32641 | 32658 | 32556
32840 | 32558 | 32632
32922 | 32859 | 33036
32779 | 32677 | 32831
32983 | 32705 | 32860
32901 | 32818 | 32911
32928 | 32757 | 32897
32844 | 32778 | 32993
32824 | 32812 | 32943
32713 | 32650 | 32692
32880 | 32912 | 32923
32644 | 32534 | 32684
33041 | 33016 | 33113
32835 | 32751 | 32968
32885 | 32862 | 32867
32996 | 32750 | 32922
32902 | 32709 | 32927
32835 | 32758 | 32848
33036 | 32972 | 33107
32668 | 32523 | 32637
32693 | 32694 | 32814
32934 | 32706 | 33012
33016 | 32819 | 32919
32864 | 32984 | 33014
32720 | 32739 | 32840
33059 | 33009 | 33045
32688 | 32732 | 32814
33052 | 32891 | 33107
32573 | 32471 | 32612
32689 | 32611 | 32807
32692 | 32539 | 32889
32860 | 32754 | 33036
32781 | 32737 | 32780
32934 | 32786 | 32960
32891 | 32753 | 32861
32842 | 32787 | 32961
32892 | 32655 | 32780
32954 | 32904 | 33003
32866 | 32804 | 32802
32794 | 32754 | 32856
32786 | 32727 | 32817
32740 | 32634 | 32803
32978 | 32854 | 33009
32912 | 32814 | 32859
32834 | 32754 | 32963
32925 | 32741 | 32971
32852 | 32828 | 32931
32780 | 32677 | 32854
32996 | 33009 | 32966
32927 | 32762 | 32860
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
