Nightshadow1258/HW_Motor_Controller/Documentation/AS5047P/plot_xy/input/AS5047P_4096_BLDC_Mot_test.csv

idx | ts [ms] | Angle from ABI [°] | Angle from SPI [°]
0 | 0 | 156.4375 | 156.3135
1 | 2 | 157.3125 | 157.0386
2 | 4 | 157.3125 | 157.4121
3 | 6 | 157.5000 | 156.8848
4 | 8 | 157.8438 | 157.5659
5 | 10 | 156.9688 | 156.9067
6 | 12 | 156.6094 | 155.9839
7 | 14 | 156.7969 | 156.4893
8 | 16 | 156.4375 | 156.1597
9 | 18 | 156.7969 | 156.3135
10 | 20 | 156.7969 | 156.6211
11 | 22 | 156.7969 | 156.2915
12 | 24 | 157.3125 | 157.0166
13 | 26 | 157.3125 | 156.9946
14 | 28 | 157.3125 | 156.8188
15 | 30 | 156.9688 | 156.5332
16 | 32 | 156.7969 | 156.6211
17 | 34 | 156.6094 | 156.0938
18 | 36 | 156.4375 | 156.3574
19 | 38 | 156.6094 | 156.5991
20 | 40 | 156.4375 | 156.3574
21 | 42 | 156.7969 | 156.3135
22 | 44 | 156.9688 | 156.5332
23 | 46 | 156.6094 | 156.3354
24 | 48 | 156.6094 | 156.3354
25 | 50 | 156.4375 | 155.8960
26 | 52 | 156.2656 | 156.3794
27 | 54 | 156.2656 | 156.1157
28 | 56 | 156.2656 | 155.8960
29 | 58 | 156.0938 | 155.9839
30 | 60 | 156.4375 | 155.8740
31 | 62 | 156.2656 | 156.0938
32 | 64 | 156.2656 | 156.1597
33 | 66 | 156.2656 | 156.0718
34 | 68 | 156.0938 | 155.7422
35 | 70 | 155.9062 | 155.4126
36 | 72 | 155.5625 | 155.5005
37 | 74 | 155.7344 | 155.6104
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
