Nightshadow1258/HW_Motor_Controller/Documentation/AS5047P/plot_xy/input/Testing.csv

idx | ts [ms] | Angle from ABI [°] | Angle from SPI [°]
0 | 0 | 123.7500 | 123.4644
1 | 10 | 123.5625 | 123.4863
2 | 20 | 123.5625 | 123.5962
3 | 30 | 123.5625 | 123.5522
4 | 40 | 123.5625 | 123.6621
5 | 50 | 123.5625 | 123.5303
6 | 60 | 123.5625 | 123.3545
7 | 70 | 123.5625 | 123.5962
8 | 80 | 123.5625 | 123.6182
9 | 90 | 123.5625 | 123.6841
10 | 100 | 123.3906 | 123.2446
11 | 110 | 123.3906 | 123.3325
12 | 120 | 123.3906 | 123.4204
13 | 130 | 123.3906 | 123.5303
14 | 140 | 123.3906 | 123.4204
15 | 150 | 123.3906 | 123.1348
16 | 160 | 123.3906 | 123.3325
17 | 170 | 123.3906 | 123.2446
18 | 180 | 123.2188 | 123.2227
19 | 190 | 123.5625 | 123.3984
20 | 200 | 123.5625 | 123.4424
21 | 210 | 123.3906 | 123.1128
22 | 220 | 123.3906 | 123.3105
23 | 230 | 123.3906 | 123.2886
24 | 240 | 123.3906 | 123.2666
25 | 250 | 123.3906 | 123.3105
26 | 260 | 123.3906 | 123.3325
27 | 270 | 123.3906 | 123.5522
28 | 280 | 123.2188 | 123.3325
29 | 290 | 123.3906 | 123.2446
30 | 300 | 123.3906 | 123.4424
31 | 310 | 123.3906 | 123.4424
32 | 320 | 123.3906 | 123.2007
33 | 330 | 123.3906 | 123.1567
34 | 340 | 123.3906 | 123.2446
35 | 350 | 123.5625 | 123.2227
36 | 360 | 123.5625 | 123.4204
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
