Nightshadow1258/HW_Motor_Controller/Documentation/Plots/AS5047P/plot_xy/input/Measurement_5.1s_2_rot_with_acceleration.csv

idx | ts [ms] | Angle from ABI [°] | Angle from SPI [°]
0 | 0 | 359 | 165.080566
1 | 10 | 0 | 165.322266
2 | 20 | 0 | 165.124512
3 | 30 | 0 | 165.585938
4 | 40 | 0 | 165.322266
5 | 50 | 0 | 165.234375
6 | 60 | 0 | 165.454102
7 | 70 | 0 | 165.322266
8 | 80 | 0 | 165.454102
9 | 90 | 0 | 165.541992
10 | 100 | 358 | 163.542480
11 | 110 | 358 | 164.223633
12 | 120 | 358 | 163.520508
13 | 130 | 358 | 164.003906
14 | 140 | 358 | 163.828125
15 | 150 | 358 | 163.740234
16 | 160 | 358 | 163.674316
17 | 170 | 358 | 163.981934
18 | 180 | 358 | 163.806152
19 | 190 | 358 | 163.586426
20 | 200 | 358 | 163.586426
21 | 210 | 358 | 163.520508
22 | 220 | 358 | 164.003906
23 | 230 | 358 | 163.608398
24 | 240 | 358 | 163.981934
25 | 250 | 358 | 163.872070
26 | 260 | 358 | 164.135742
27 | 270 | 358 | 164.025879
28 | 280 | 358 | 163.959961
29 | 290 | 358 | 163.740234
30 | 300 | 358 | 164.113770
31 | 310 | 358 | 164.267578
32 | 320 | 358 | 163.850098
33 | 330 | 358 | 163.894043
34 | 340 | 358 | 164.113770
35 | 350 | 358 | 163.652344
36 | 360 | 358 | 163.740234
37 | 370 | 358 | 163.498535
38 | 380 | 358 | 163.740234
39 | 390 | 358 | 163.586426
40 | 400 | 358 | 163.520508
41 | 410 | 358 | 163.696289
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
