Nightshadow1258/HW_Motor_Controller/Documentation/Plots/AS5047P/plot_xy/output/AS5047P_4096_BLDC_Mot_test_allegro_32_eeprom_registers.csv

Register_Index | Sensor_Angle_Deg | EEPROM_Correction_Deg
0 | 0.0 | 0.031757
1 | 11.25 | -2.43153
2 | 22.5 | -4.963403
3 | 33.75 | -8.537737
4 | 45.0 | -11.830592
5 | 56.25 | -14.876125
6 | 67.5 | -17.906176
7 | 78.75 | -20.434344
8 | 90.0 | -21.437258
9 | 101.25 | -20.068396
10 | 112.5 | -16.233751
11 | 123.75 | -10.704522
12 | 135.0 | -4.80067
13 | 146.25 | 0.120228
14 | 157.5 | 3.108901
15 | 168.75 | 3.838231
16 | 180.0 | 2.553533
17 | 191.25 | -0.158864
18 | 202.5 | -3.648476
19 | 213.75 | -7.398443
20 | 225.0 | -11.080148
21 | 236.25 | -14.47842
22 | 247.5 | -17.362598
23 | 258.75 | -19.39958
24 | 270.0 | -20.177424
25 | 281.25 | -19.344707
26 | 292.5 | -16.801416
27 | 303.75 | -12.838894
28 | 315.0 | -8.147303
29 | 326.25 | -3.683779
30 | 337.5 | -0.454093
31 | 348.75 | 0.862889
