Nightshadow1258/HW_Motor_Controller/Documentation/Plots/AS5047P/plot_xy/output/AS5047P_4096_BLDC_Mot_test_harmonic_optimization_parameters.csv

Parameter | Harmonic | Value
DC_Offset | 0 | 9.334393
Sin_Amplitude | 1 | -0.172961
Cos_Amplitude | 1 | 1.318346
Sin_Amplitude | 2 | 2.457253
Cos_Amplitude | 2 | -11.013241
Sin_Amplitude | 3 | -0.617678
Cos_Amplitude | 3 | 0.076578
Sin_Amplitude | 4 | 1.163651
Cos_Amplitude | 4 | 0.419823
