Nightshadow1258/HW_Motor_Controller/Documentation/Plots/STM32H750VB/Timer1_Frequency_Verification/input/STM32H750VB_5V_Tim1_20kHz_(PWMCH1)_(PWMCH1N).csv

Source | TIM1_CH1 | TIM1_CH1N
-0.00008000000 | 2.78000 | 0.00
-0.00007999000 | 2.78000 | 0.00
-0.00007998000 | 2.76000 | 0.04000
-0.00007997000 | 2.76000 | 0.02000
-0.00007996000 | 2.78000 | 0.02000
-0.00007995000 | 2.78000 | 0.02000
-0.00007994000 | 2.78000 | 0.02000
-0.00007993000 | 2.78000 | 0.04000
-0.00007992000 | 2.78000 | 0.02000
-0.00007991000 | 2.78000 | 0.02000
-0.00007990000 | 2.78000 | 0.00
-0.00007989000 | 2.78000 | 0.04000
-0.00007988000 | 2.78000 | 0.02000
-0.00007987000 | 2.78000 | 0.04000
-0.00007986000 | 2.78000 | 0.00
-0.00007985000 | 2.78000 | 0.04000
-0.00007984000 | 2.78000 | 0.04000
-0.00007983000 | 2.78000 | 0.02000
-0.00007982000 | 2.78000 | 0.00
-0.00007981000 | 2.78000 | 0.02000
-0.00007980000 | 2.78000 | 0.00
-0.00007979000 | 2.76000 | 0.02000
-0.00007978000 | 2.78000 | 0.02000
-0.00007977000 | 2.78000 | 0.00
-0.00007976000 | 2.78000 | 0.00
-0.00007975000 | 2.78000 | 0.00
-0.00007974000 | 2.78000 | 0.00
-0.00007973000 | 2.78000 | 0.00
-0.00007972000 | 2.78000 | 0.00
-0.00007971000 | 2.78000 | 0.00
-0.00007970000 | 2.76000 | 0.00
-0.00007969000 | 2.78000 | 0.00
-0.00007968000 | 2.78000 | 0.02000
-0.00007967000 | 2.78000 | 0.00
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
