Nightshadow1258/HW_Motor_Controller/Documentation/Plots/STM32H750VB/Timer1_Frequency_Verification/input/STM32H750VB_5V_Tim1_20kHz_Deadtime_(PWMCH1)_(PWMCH1N).csv

Source | TIM1_CH1 | TIM1_CH1N
-0.00000060400 | 0.04000 | 2.64000
-0.00000060200 | 0.04000 | 2.62000
-0.00000060000 | 0.04000 | 2.64000
-0.00000059800 | 0.04000 | 2.62000
-0.00000059600 | 0.04000 | 2.64000
-0.00000059400 | 0.04000 | 2.64000
-0.00000059200 | 0.04000 | 2.66000
-0.00000059000 | 0.04000 | 2.68000
-0.00000058800 | 0.04000 | 2.66000
-0.00000058600 | 0.04000 | 2.64000
-0.00000058400 | 0.04000 | 2.66000
-0.00000058200 | 0.04000 | 2.64000
-0.00000058000 | 0.04000 | 2.66000
-0.00000057800 | 0.04000 | 2.64000
-0.00000057600 | 0.04000 | 2.64000
-0.00000057400 | 0.04000 | 2.66000
-0.00000057200 | 0.04000 | 2.66000
-0.00000057000 | 0.04000 | 2.64000
-0.00000056800 | 0.04000 | 2.62000
-0.00000056600 | 0.04000 | 2.64000
-0.00000056400 | 0.02000 | 2.66000
-0.00000056200 | 0.02000 | 2.64000
-0.00000056000 | 0.02000 | 2.62000
-0.00000055800 | 0.02000 | 2.64000
-0.00000055600 | 0.04000 | 2.62000
-0.00000055400 | 0.04000 | 2.64000
-0.00000055200 | 0.04000 | 2.64000
-0.00000055000 | 0.04000 | 2.62000
-0.00000054800 | 0.04000 | 2.62000
-0.00000054600 | 0.04000 | 2.64000
-0.00000054400 | 0.02000 | 2.66000
-0.00000054200 | 0.02000 | 2.66000
-0.00000054000 | 0.02000 | 2.64000
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
