Nightshadow1258/HW_Motor_Controller/Documentation/Plots/STM32H750VB/Timer1_Frequency_Verification/input/STM32H750VB_5V_Tim1_20kHz_centeraligned_(PWMCH1)_(PWMCH2).csv

Source | TIM1_CH1 | TIM1_CH2
-0.00008020000 | 2.98000 | 3.00000
-0.00008019000 | 3.00000 | 3.00000
-0.00008018000 | 3.00000 | 3.00000
-0.00008017000 | 3.00000 | 3.00000
-0.00008016000 | 3.00000 | 3.00000
-0.00008015000 | 3.00000 | 3.00000
-0.00008014000 | 3.00000 | 3.00000
-0.00008013000 | 3.00000 | 3.00000
-0.00008012000 | 3.00000 | 3.00000
-0.00008011000 | 3.00000 | 3.00000
-0.00008010000 | 3.00000 | 3.00000
-0.00008009000 | 3.00000 | 3.00000
-0.00008008000 | 3.00000 | 3.00000
-0.00008007000 | 3.00000 | 3.00000
-0.00008006000 | 2.98000 | 3.00000
-0.00008005000 | 3.00000 | 3.00000
-0.00008004000 | 3.00000 | 3.00000
-0.00008003000 | 3.00000 | 3.00000
-0.00008002000 | 2.98000 | 3.00000
-0.00008001000 | 3.00000 | 3.00000
-0.00008000000 | 3.00000 | 3.00000
-0.00007999000 | 3.00000 | 3.00000
-0.00007998000 | 3.00000 | 3.00000
-0.00007997000 | 3.00000 | 3.02000
-0.00007996000 | 3.00000 | 3.00000
-0.00007995000 | 3.00000 | 3.00000
-0.00007994000 | 3.00000 | 3.00000
-0.00007993000 | 2.98000 | 3.02000
-0.00007992000 | 3.00000 | 3.02000
-0.00007991000 | 3.00000 | 3.02000
-0.00007990000 | 2.98000 | 3.02000
-0.00007989000 | 3.00000 | 3.00000
-0.00007988000 | 3.00000 | 3.00000
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
