Nightshadow1258/HW_Motor_Controller/Documentation/AS5047P/plot_xy/output/AS5047P_4096_BLDC_Mot_test_filtered.png

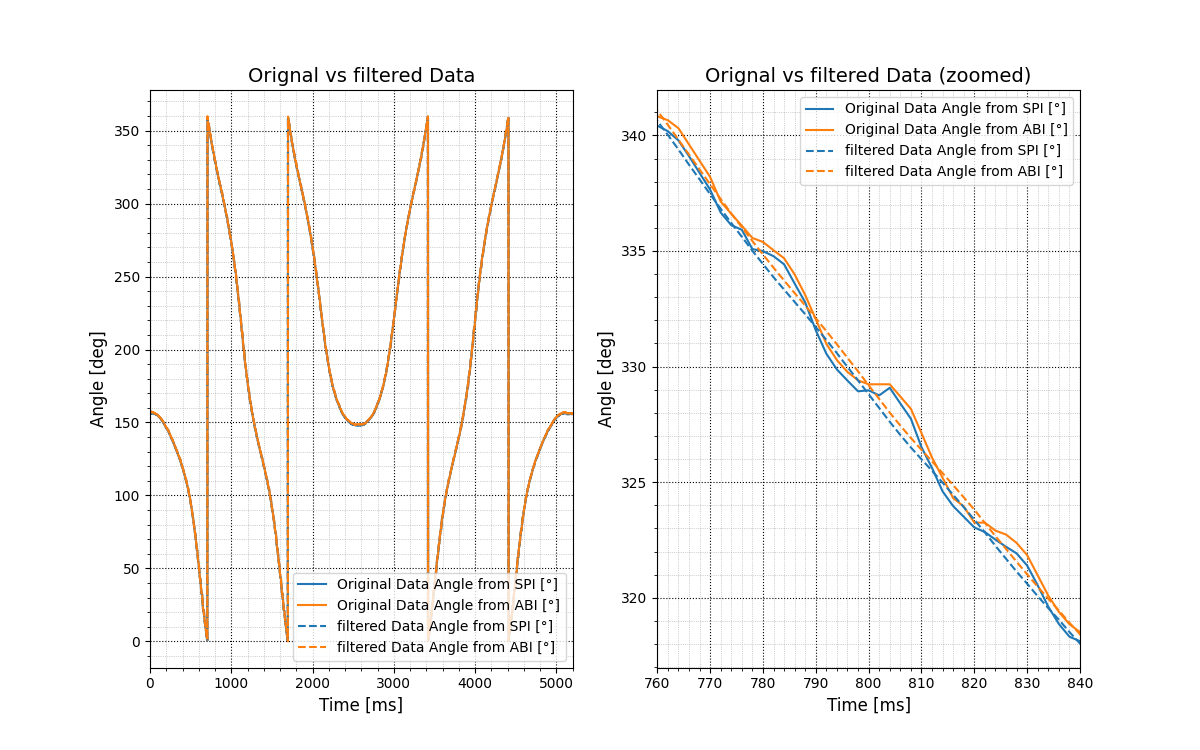
Documentation/AS5047P/plot_xy/output/AS5047P_4096_BLDC_Mot_test_filtered.png
