Nightshadow1258/HW_Motor_Controller/Documentation/Plots/STM32H750VB/Timer1_Frequency_Verification/output/STM32H750VB_5V_Tim1_40kHz_(PWMCH1)_(PWMCH1N).jpeg

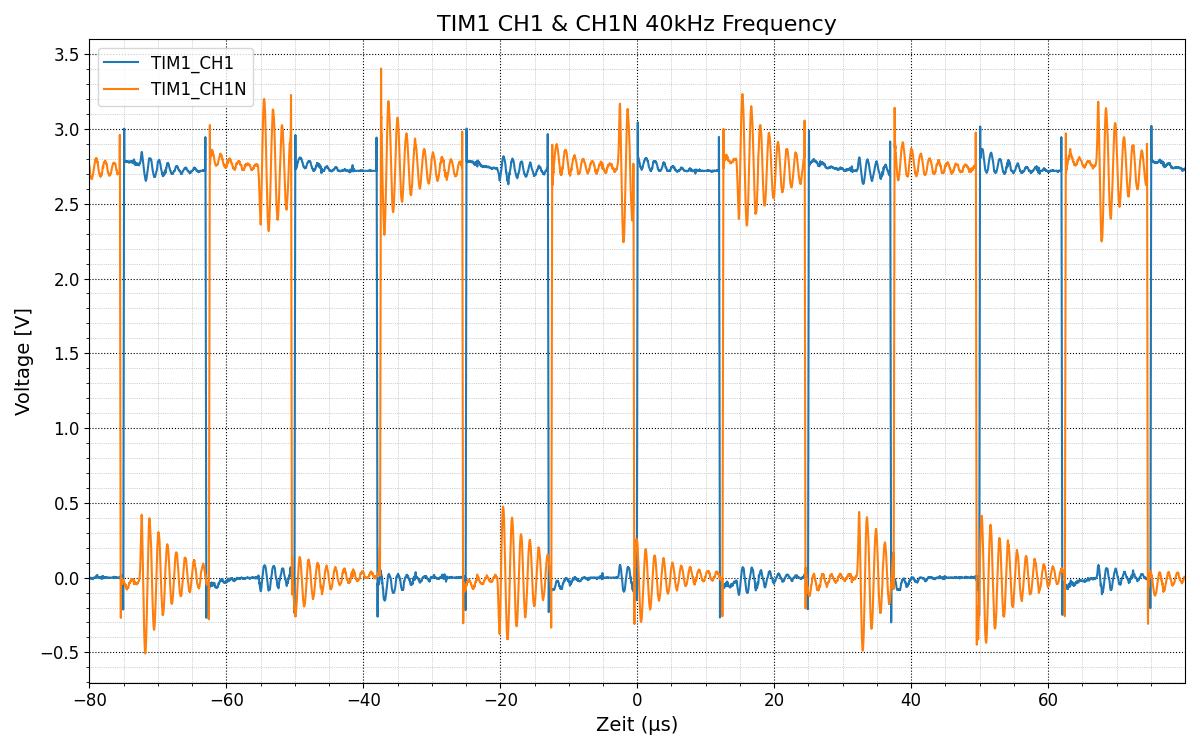
Documentation/Plots/STM32H750VB/Timer1_Frequency_Verification/output/STM32H750VB_5V_Tim1_40kHz_(PWMCH1)_(PWMCH1N).jpeg
