Nightshadow1258/HW_Motor_Controller/Documentation/Schematics/SCH_Motor_Position_Sensor_V1.0.pdf

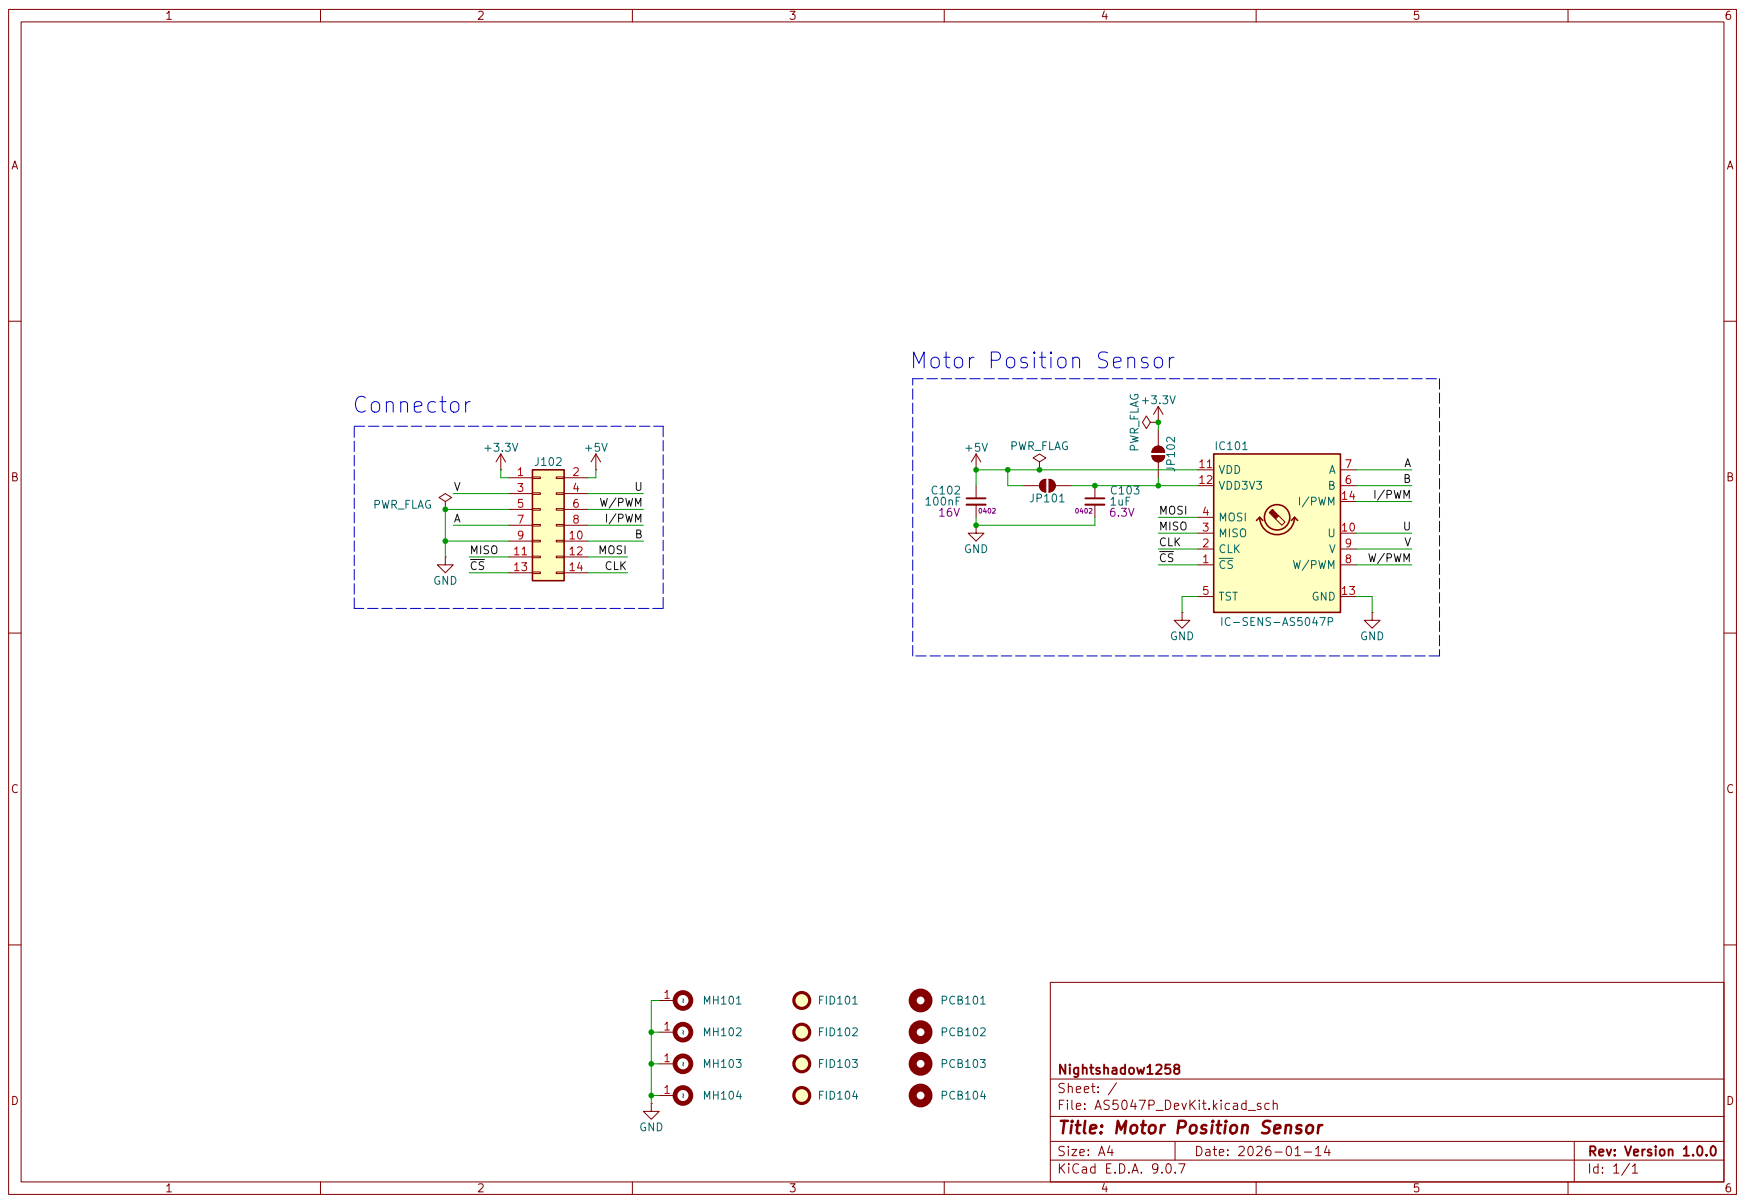
[picture p31: page 1]
