Nightshadow1258/HW_Motor_Controller/Documentation/Plots/STM32H750VB/Timer1_Frequency_Verification/output/STM32H750VB_5V_Tim1_20kHz_centeraligned_(PWMCH1)_(PWMCH2).pdf

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

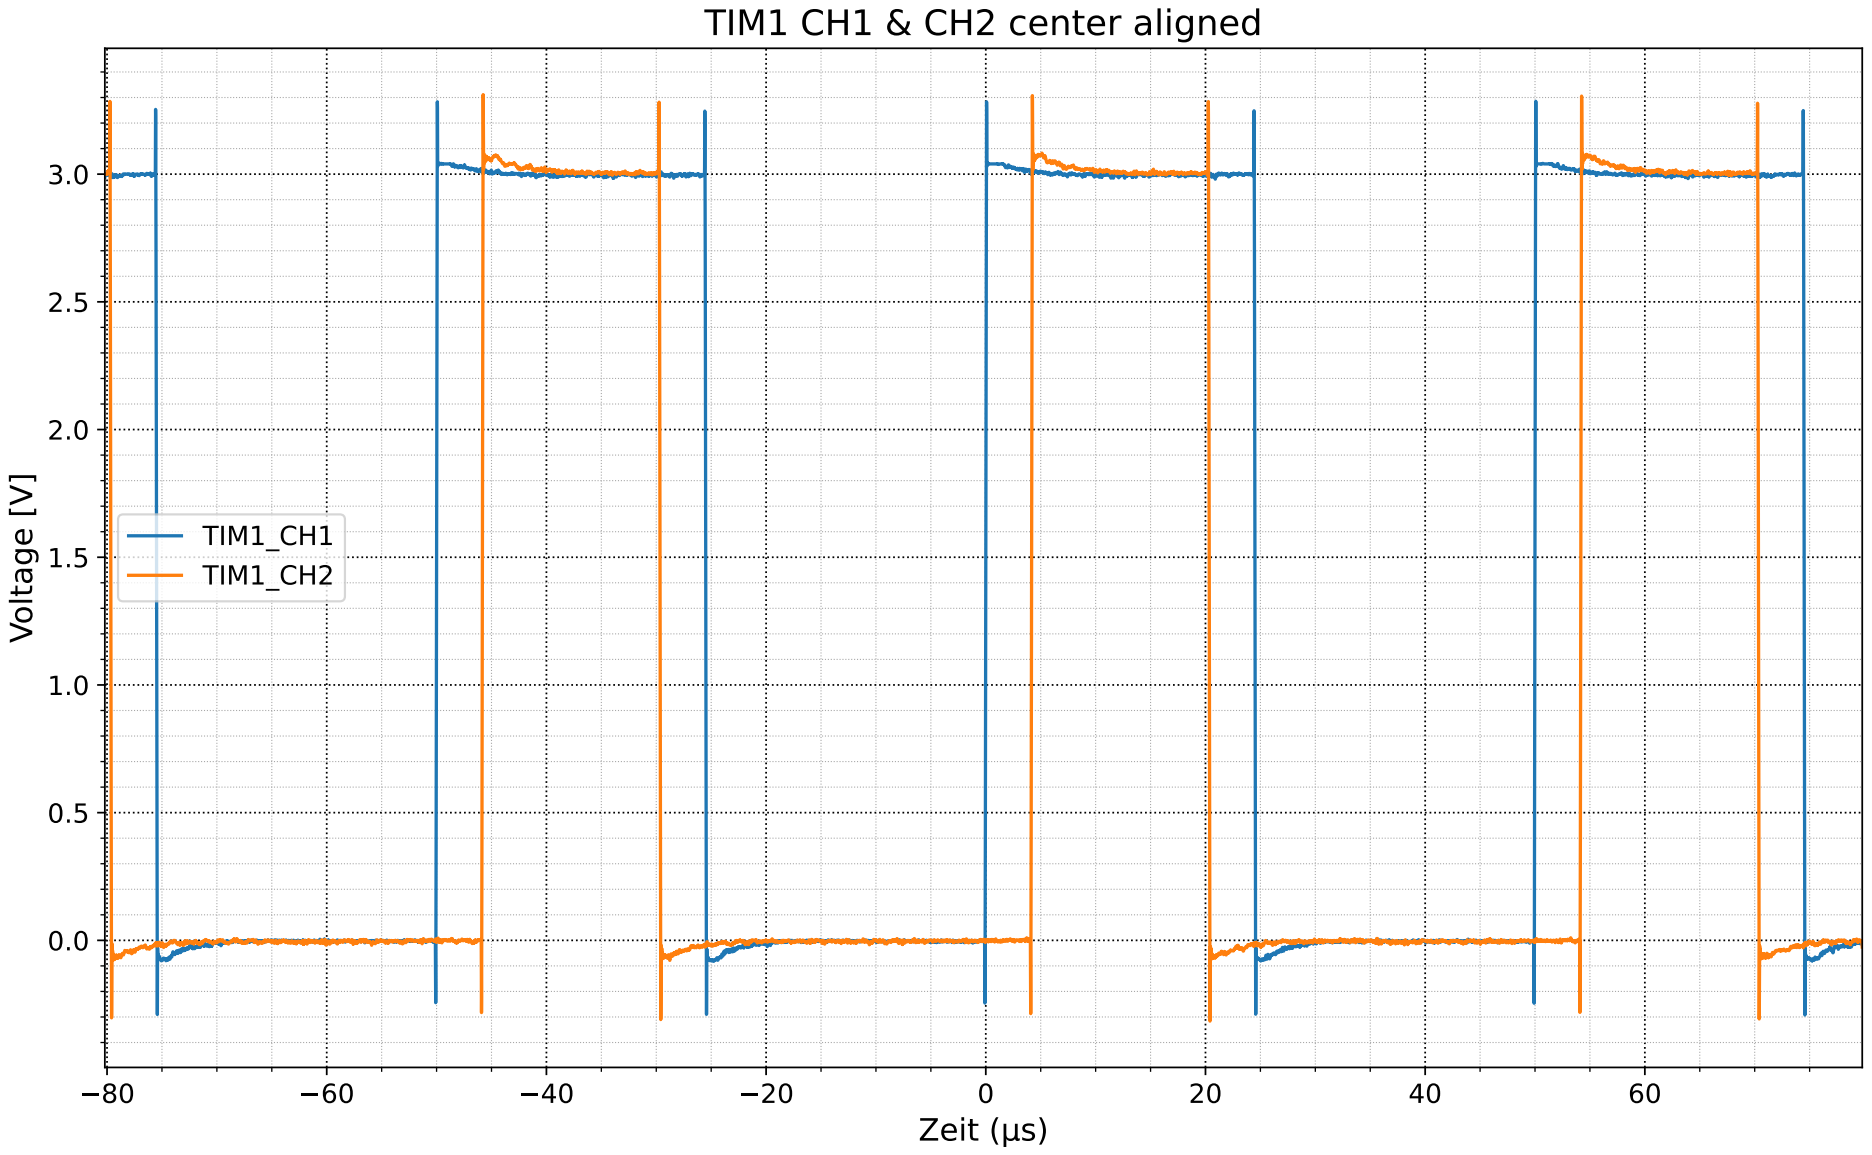
[picture p33: page 1]
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
