Nightshadow1258/HW_Motor_Controller/Documentation/Plots/STM32H750VB/Timer1_Frequency_Verification/output/STM32H750VB_5V_Tim1_40kHz_(PWMCH1)_(PWMCH1N).pdf

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

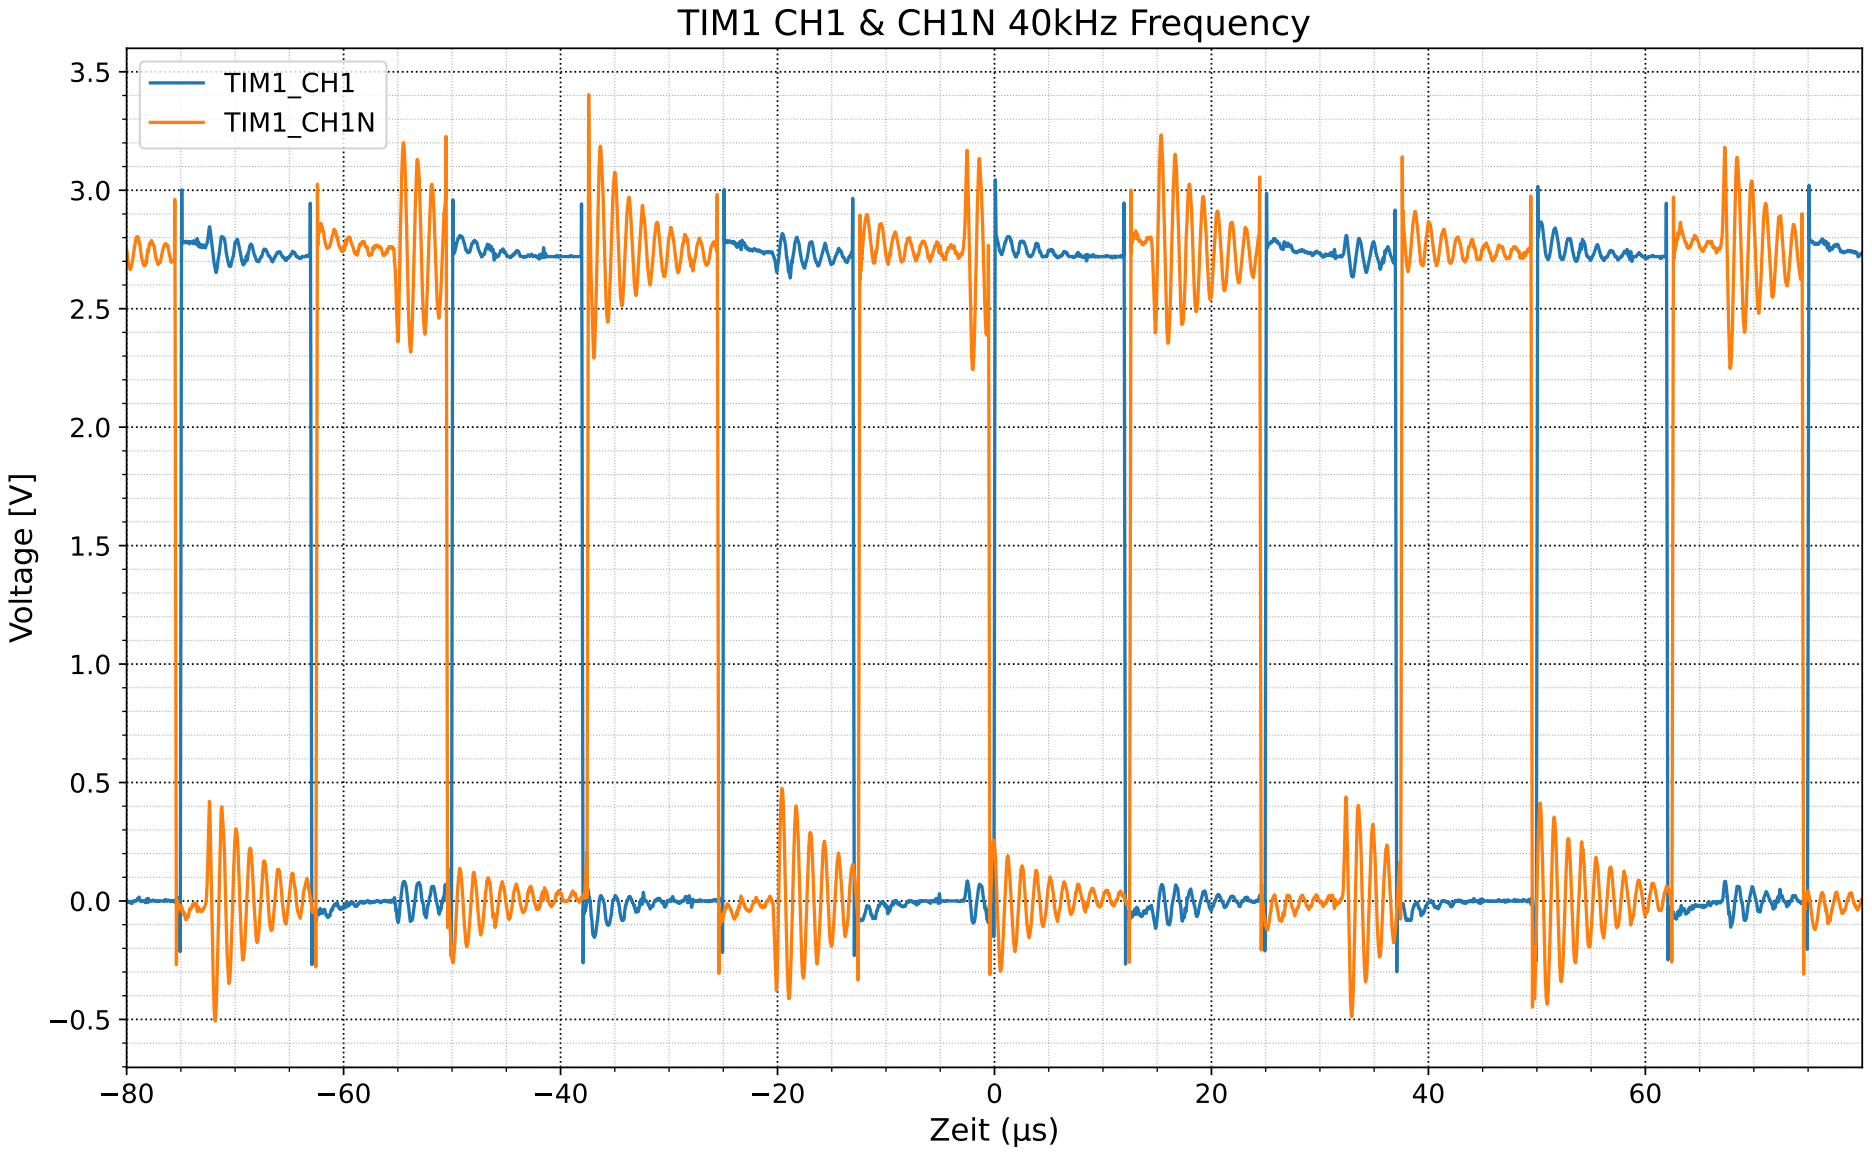
[picture p35: page 1]
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
