Nightshadow1258/HW_Motor_Controller/Documentation/Plots/DRV8334/output/DRV8334_12V_Deadtime_falling_(GLA)_(GHA).pdf

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

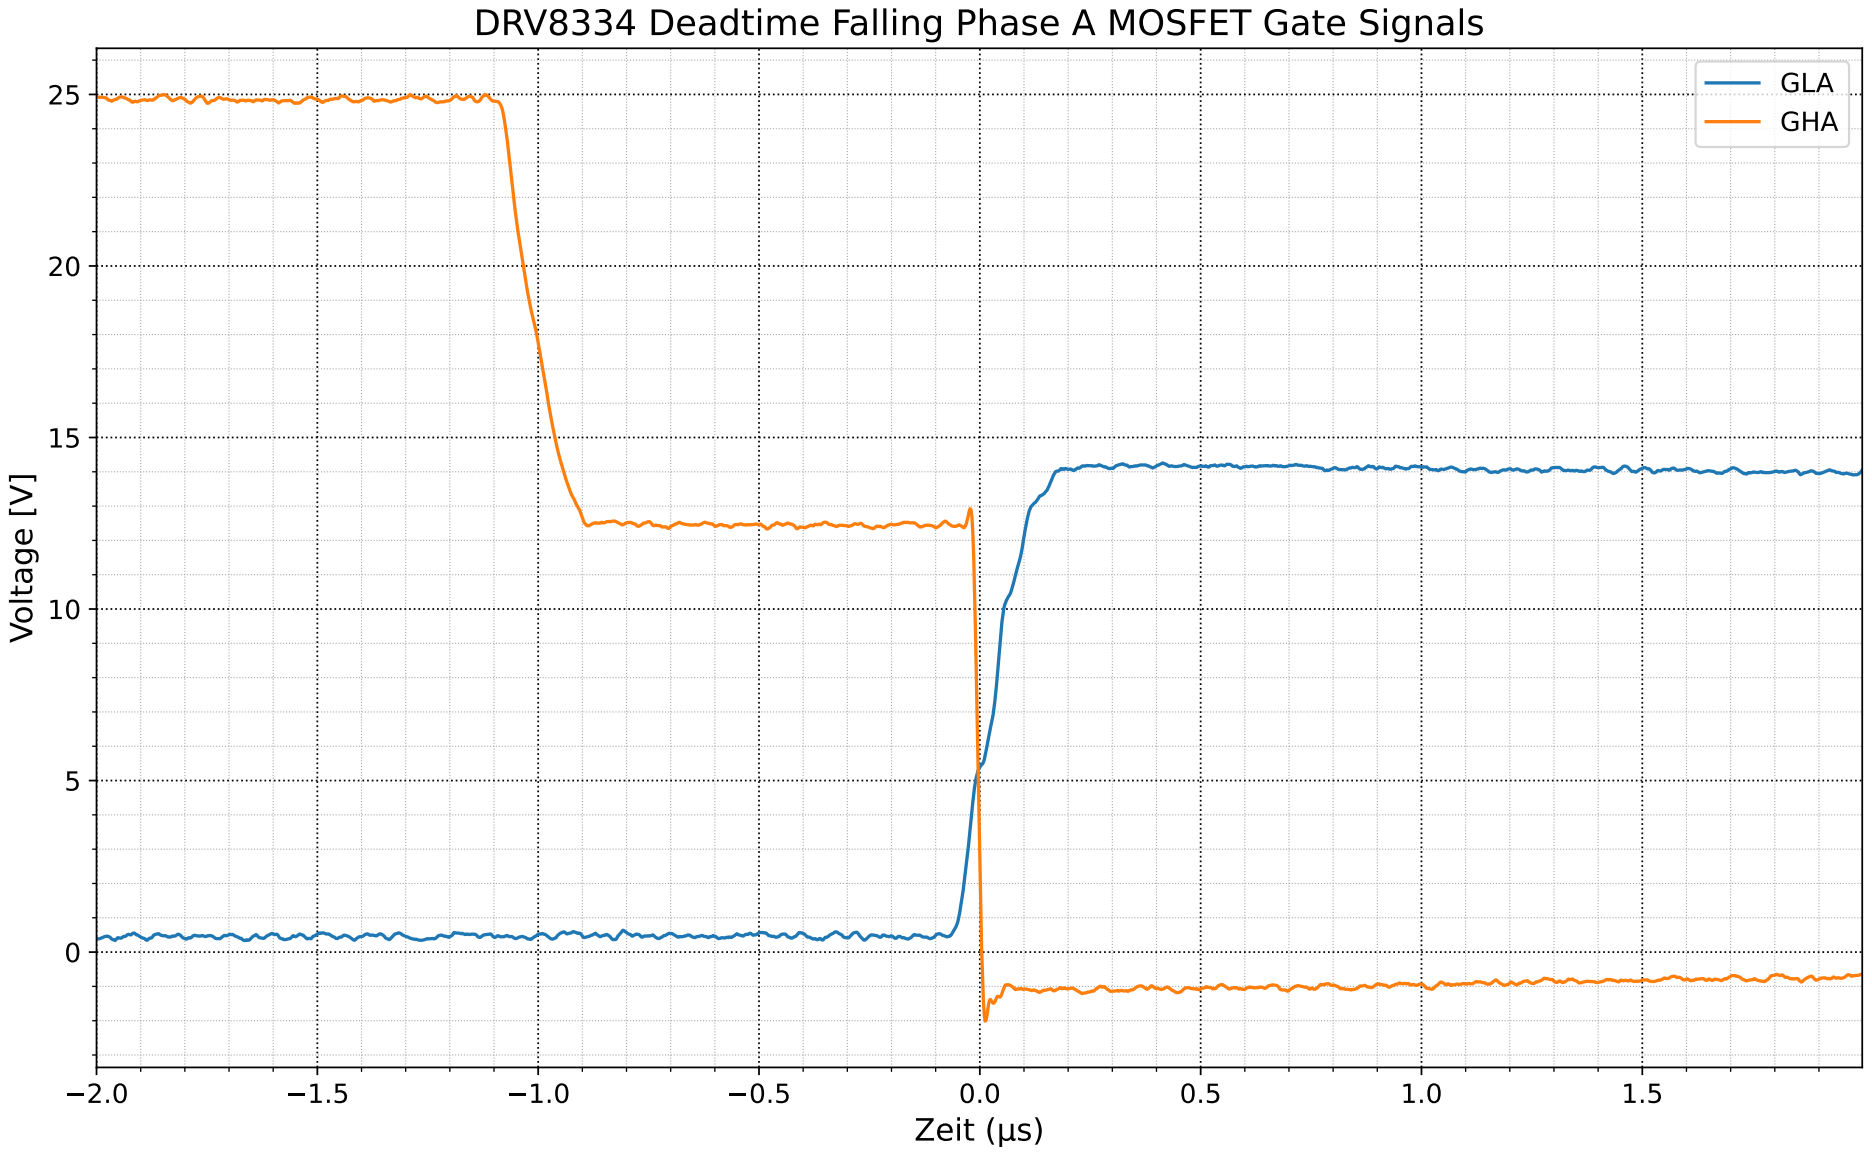
[picture p36: page 1]
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
