Nightshadow1258/HW_Motor_Controller/Documentation/Plots/DRV8334_Current/output/DRV8334_12V_OpenLoop_1Hz_(PHA)_(SOC)_2.pdf

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

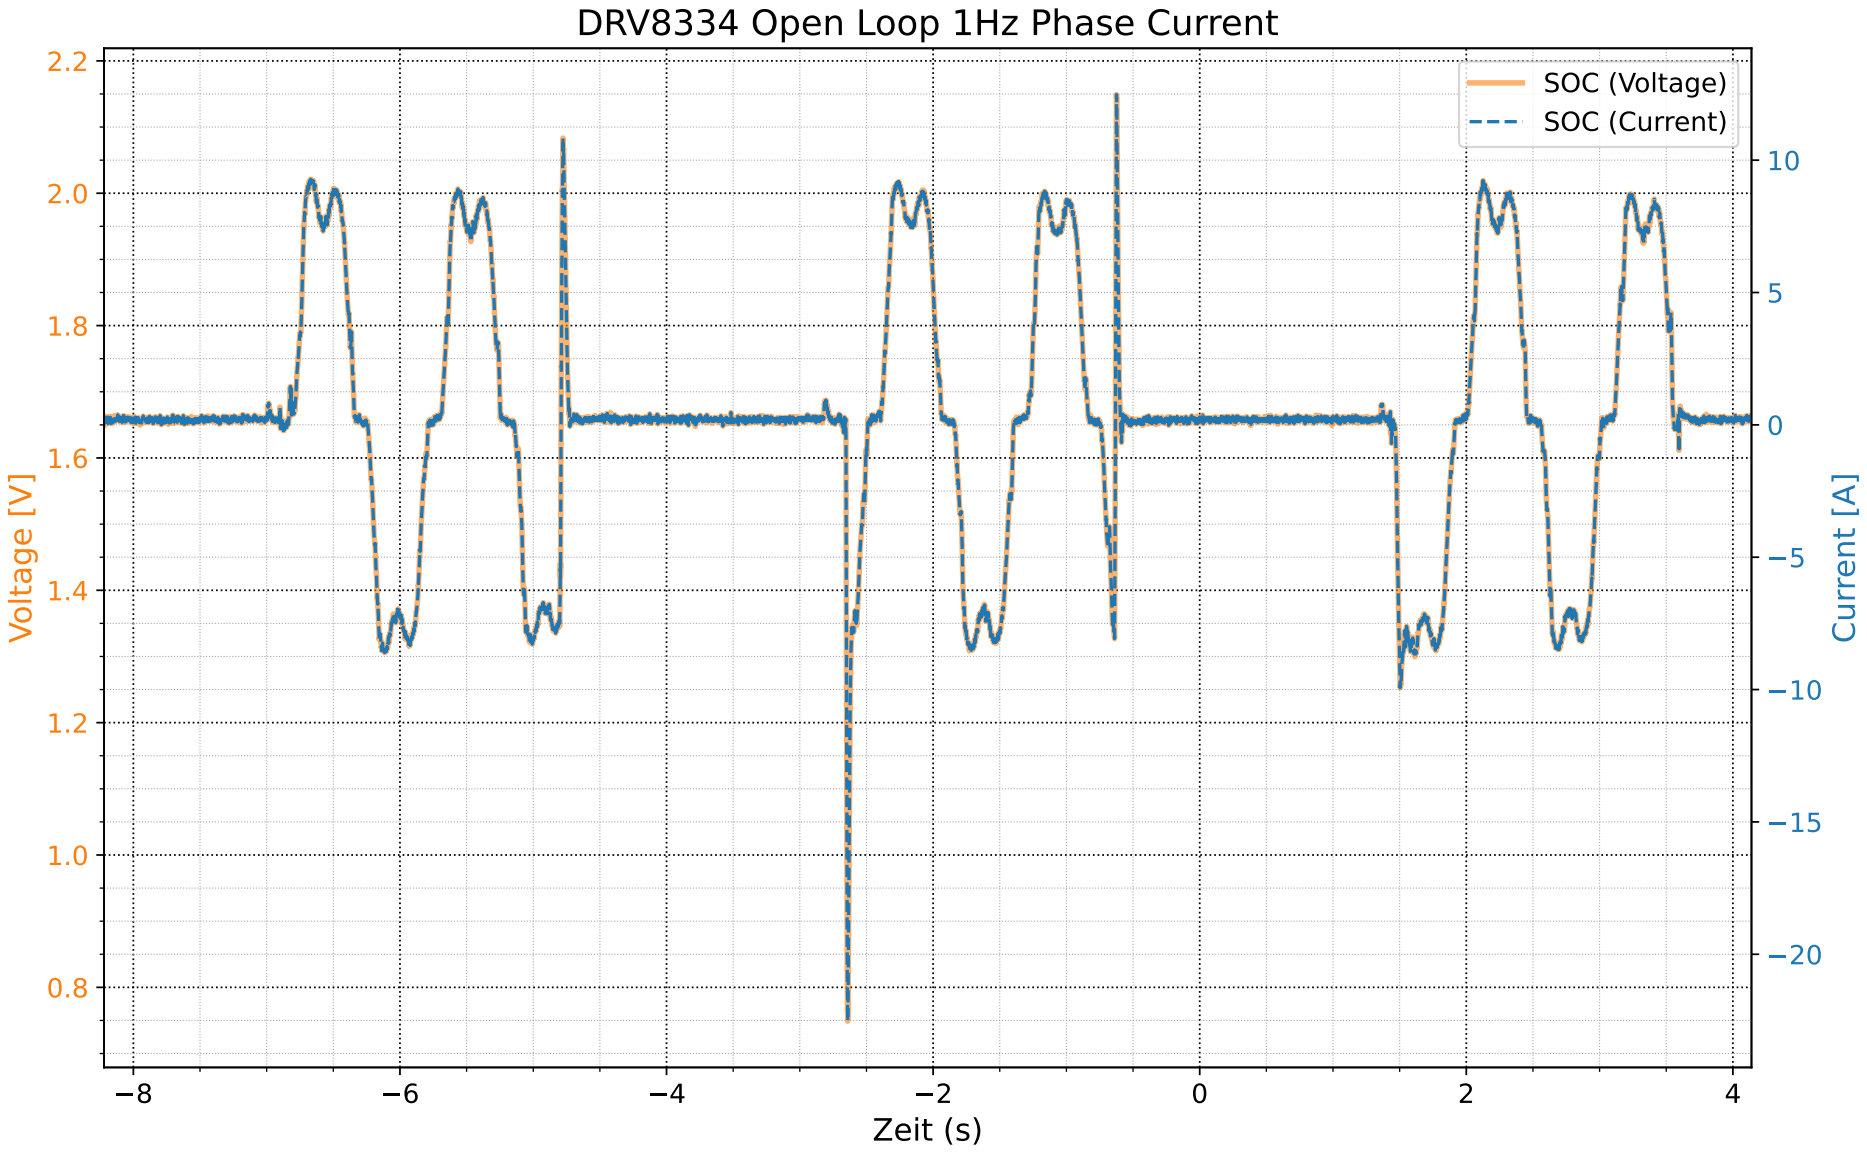
[picture p40: page 1]
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
