Nightshadow1258/HW_Motor_Controller/KiCAD/Motor_Controller/Motor_Controller.kicad_pcb

## KiCad design KiCAD/Motor_Controller/Motor_Controller.kicad_pcb (2026-10-29)

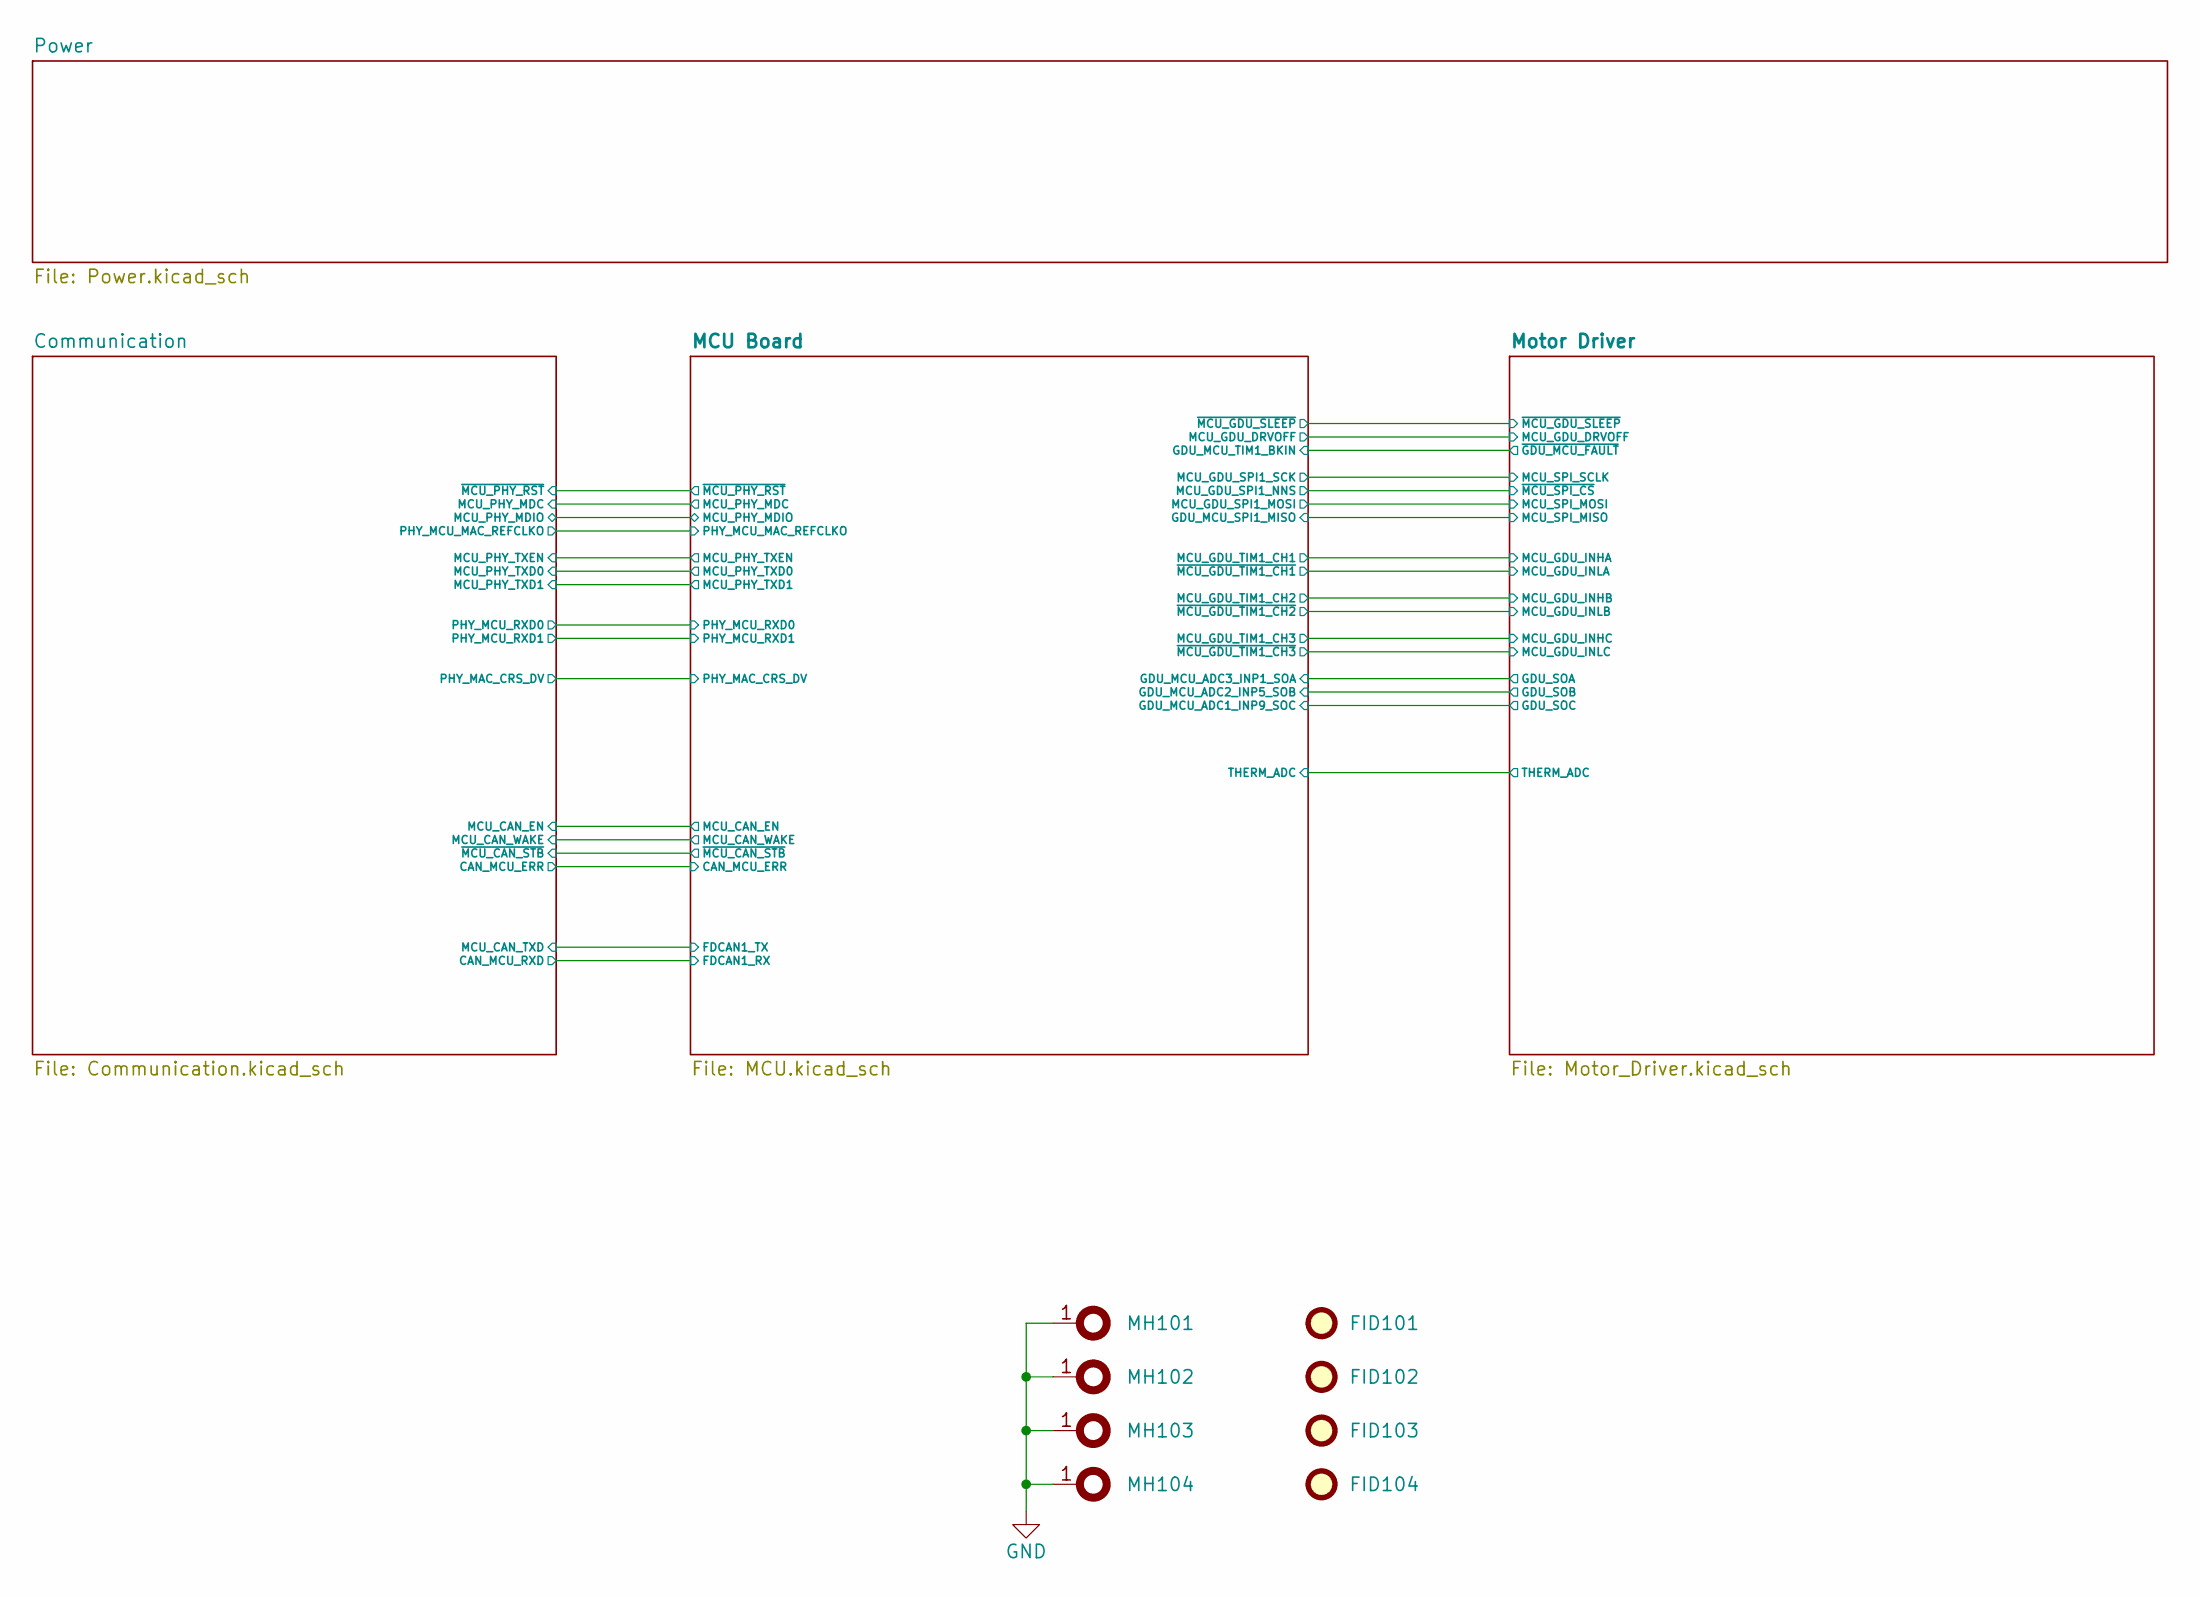
[picture p41: schematic Motor_Controller.kicad_sch, Motor Controller Prototype]

Parts:
FID101, FID102, FID103, FID104: Fiducal-JLCPPCB; PCB-FID-JLCPCB
MH101, MH102, MH103, MH104: MountingHole_3.2mm_M3_Pad_Via

Connections:
GND: MH101.1, MH102.1, MH103.1, MH104.1; also elsewhere on the board

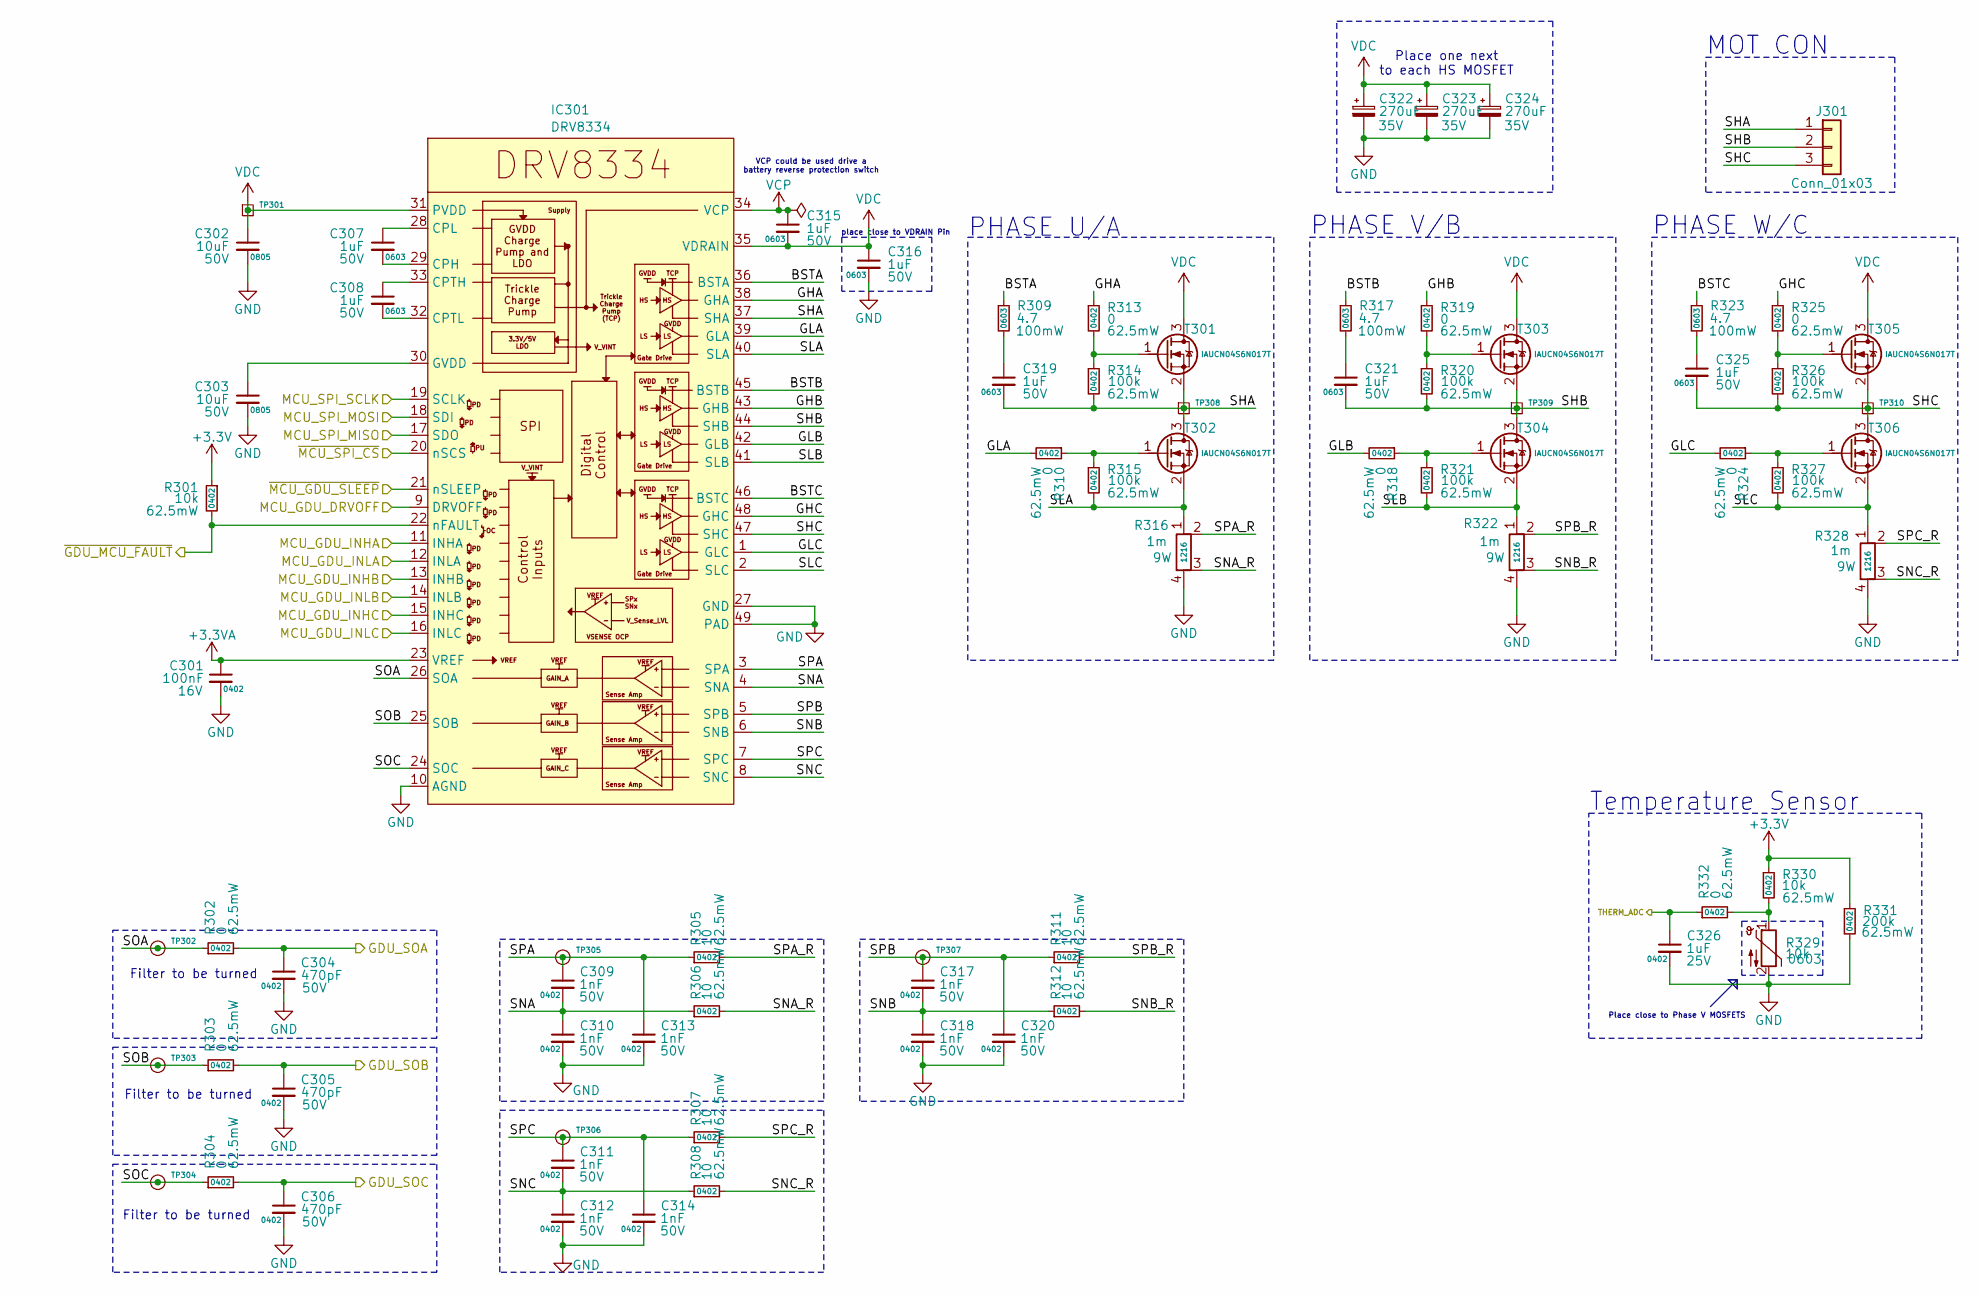
[picture p42: schematic Motor_Driver.kicad_sch, Motor Controller Prototype]

Parts:
C301: 100nF; C_0402_1005Metric; Voltage 16V; LCSC Part # C1525
C302, C303: 10uF; C_0805_2012Metric; Voltage 50V; LCSC Part # C440198
C304, C305, C306: 470pF; C_0402_1005Metric; Voltage 50V; LCSC Part # C1537
C307, C308, C315, C316, C319, C321, C325: 1uF; C_0603_1608Metric; Voltage 50V; LCSC Part # C15849
C309, C310, C311, C312, C313, C314, C317, C318, C320: 1nF; C_0402_1005Metric; Voltage 50V; LCSC Part # C1523
C322, C323, C324: 270uF; CP_Elec_10x10; LCSC Part # C79124
C326: 1uF; C_0402_1005Metric; Voltage 25V; LCSC Part # C52923
IC301: DRV8334; Texas_PHP0048E_HTQFP-48-1EP_7x7mm_P0.5mm_EP6.5x6.5mm_Mask3.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; LCSC Part # C32712900
J301: Conn_01x03; CON-01x03-10-AWG
R301, R330: 10k; R_0402_1005Metric; Power Rating 62.5mW; LCSC Part # C25744
R302, R303, R304, R310, R313, R318, R319, R324, R325, R332: 0; R_0402_1005Metric; Power Rating 62.5mW; LCSC Part # C17168
R305, R306, R307, R308, R311, R312: 10; R_0402_1005Metric; Power Rating 62.5mW; LCSC Part # C25077
R309, R317, R323: 4.7; R_0603_1608Metric; Power Rating 100mW; LCSC Part # C23164
R314, R315, R320, R321, R326, R327: 100k; R_0402_1005Metric; Power Rating 62.5mW; LCSC Part # C25741
R316, R322, R328: 1m; R-SH-1216_flip; Power Rating 9W
R329: 10k; R_0603_1608Metric; LCSC Part # C142556
R331: 200k; R_0402_1005Metric; Power Rating 62.5mW; LCSC Part # C25764
T301, T302, T303, T304, T305, T306: IAUCN04S6N017T; T-MOSN-LHDSO-10-1
TP301, TP308, TP309, TP310: Testpoint-BASE; TP_THT_D0.8mm
TP302, TP303, TP304, TP305, TP306, TP307: TP; TP_Pad_D0.9mm

Connections:
+3.3V: R301.1, R330.1, R331.1; also elsewhere on the board
+3.3VA: C301.1, IC301.23 (VREF); also elsewhere on the board
/MCU Board/GDU_MCU_ADC1_INP9_SOA: C304.1, R302.2; also elsewhere on the board
/MCU Board/GDU_MCU_ADC2_INP5_SOB: C305.1, R303.2; also elsewhere on the board
/MCU Board/GDU_MCU_ADC3_INP1_SOC: C306.1, R304.2; also elsewhere on the board
/MCU Board/GDU_MCU_SPI1_MISO: IC301.17 (SDO); also elsewhere on the board
/MCU Board/GDU_MCU_TIM1_BKIN: IC301.22 (nFAULT), R301.2; also elsewhere on the board
/MCU Board/MCU_GDU_DRVOFF: IC301.9 (DRVOFF); also elsewhere on the board
/MCU Board/MCU_GDU_SPI1_MOSI: IC301.18 (SDI); also elsewhere on the board
/MCU Board/MCU_GDU_SPI1_NNS: IC301.20 (nSCS); also elsewhere on the board
/MCU Board/MCU_GDU_SPI1_SCK: IC301.19 (SCLK); also elsewhere on the board
/MCU Board/MCU_GDU_TIM1_CH1: IC301.11 (INHA); also elsewhere on the board
/MCU Board/MCU_GDU_TIM1_CH2: IC301.13 (INHB); also elsewhere on the board
/MCU Board/MCU_GDU_TIM1_CH3: IC301.15 (INHC); also elsewhere on the board
/MCU Board/THERM_ADC: C326.1, R332.1; also elsewhere on the board
/MCU Board/~MCU_GDU_SLEEP: IC301.21 (nSLEEP); also elsewhere on the board
/MCU Board/~MCU_GDU_TIM1_CH1: IC301.12 (INLA); also elsewhere on the board
/MCU Board/~MCU_GDU_TIM1_CH2: IC301.14 (INLB); also elsewhere on the board
/MCU Board/~MCU_GDU_TIM1_CH3: IC301.16 (INLC); also elsewhere on the board
/Motor Driver/BSTA: IC301.36 (BSTA), R309.1
/Motor Driver/BSTB: IC301.45 (BSTB), R317.1
/Motor Driver/BSTC: IC301.46 (BSTC), R323.1
/Motor Driver/GHA: IC301.38 (GHA), R313.1
/Motor Driver/GHB: IC301.43 (GHB), R319.1
/Motor Driver/GHC: IC301.48 (GHC), R325.1
/Motor Driver/GLA: IC301.39 (GLA), R310.2
/Motor Driver/GLB: IC301.42 (GLB), R318.2
/Motor Driver/GLC: IC301.1 (GLC), R324.2
/Motor Driver/SHA: C319.2, IC301.37 (SHA), J301.1, R314.2, T301.2 (S), T302.3 (D), TP308.1
/Motor Driver/SHB: C321.2, IC301.44 (SHB), J301.2, R320.2, T303.2 (S), T304.3 (D), TP309.1
/Motor Driver/SHC: C325.2, IC301.47 (SHC), J301.3, R326.2, T305.2 (S), T306.3 (D), TP310.1
/Motor Driver/SLA: IC301.40 (SLA), R315.2, R316.1, T302.2 (S)
/Motor Driver/SLB: IC301.41 (SLB), R321.2, R322.1, T304.2 (S)
/Motor Driver/SLC: IC301.2 (SLC), R327.2, R328.1, T306.2 (S)
/Motor Driver/SNA: C309.2, C310.1, IC301.4 (SNA), R306.1
/Motor Driver/SNA_R: R306.2, R316.3
/Motor Driver/SNB: C317.2, C318.1, IC301.6 (SNB), R312.1
/Motor Driver/SNB_R: R312.2, R322.3
/Motor Driver/SNC: C311.2, C312.1, IC301.8 (SNC), R308.1
/Motor Driver/SNC_R: R308.2, R328.3
/Motor Driver/SOA: IC301.26 (SOA), R302.1, TP302.1
/Motor Driver/SOB: IC301.25 (SOB), R303.1, TP303.1
/Motor Driver/SOC: IC301.24 (SOC), R304.1, TP304.1
/Motor Driver/SPA: C309.1, C313.1, IC301.3 (SPA), R305.1, TP305.1
/Motor Driver/SPA_R: R305.2, R316.2
/Motor Driver/SPB: C317.1, C320.1, IC301.5 (SPB), R311.1, TP307.1
/Motor Driver/SPB_R: R311.2, R322.2
/Motor Driver/SPC: C311.1, C314.1, IC301.7 (SPC), R307.1, TP306.1
/Motor Driver/SPC_R: R307.2, R328.2
GND: C301.2, C302.2, C303.2, C304.2, C305.2, C306.2, C310.2, C312.2, C313.2, C314.2, C316.2, C318.2, C320.2, C322.2, C323.2, C324.2, C326.2, IC301.10 (AGND), IC301.27 (GND), IC301.49 (PAD), R316.4, R322.4, R328.4, R329.2, R331.2; also elsewhere on the board
unnamed: C319.1, R309.2
unnamed: C321.1, R317.2
unnamed: C325.1, R323.2
unnamed: C307.2, IC301.29 (CPH)
unnamed: C307.1, IC301.28 (CPL)
unnamed: C308.1, IC301.33 (CPTH)
unnamed: C308.2, IC301.32 (CPTL)
unnamed: C303.1, IC301.30 (GVDD)
unnamed: R329.1, R330.2, R332.2
unnamed: R313.2, R314.1, T301.1 (G)
unnamed: R310.1, R315.1, T302.1 (G)
unnamed: R319.2, R320.1, T303.1 (G)
unnamed: R318.1, R321.1, T304.1 (G)
unnamed: R325.2, R326.1, T305.1 (G)
unnamed: R324.1, R327.1, T306.1 (G)
VCP: C315.1, IC301.34 (VCP)
VDC: C302.1, C315.2, C316.1, C322.1, C323.1, C324.1, IC301.31 (PVDD), IC301.35 (VDRAIN), T301.3 (D), T303.3 (D), T305.3 (D), TP301.1; also elsewhere on the board

Notes on the sheet:
PHASE U/A
place close to VDRAIN Pin
Place close to Phase V MOSFETS
Filter to be turned
PHASE V/B
Place one next to each HS MOSFET
MOT CON
PHASE W/C
Temperature Sensor
VCP could be used drive a battery reverse protection switch

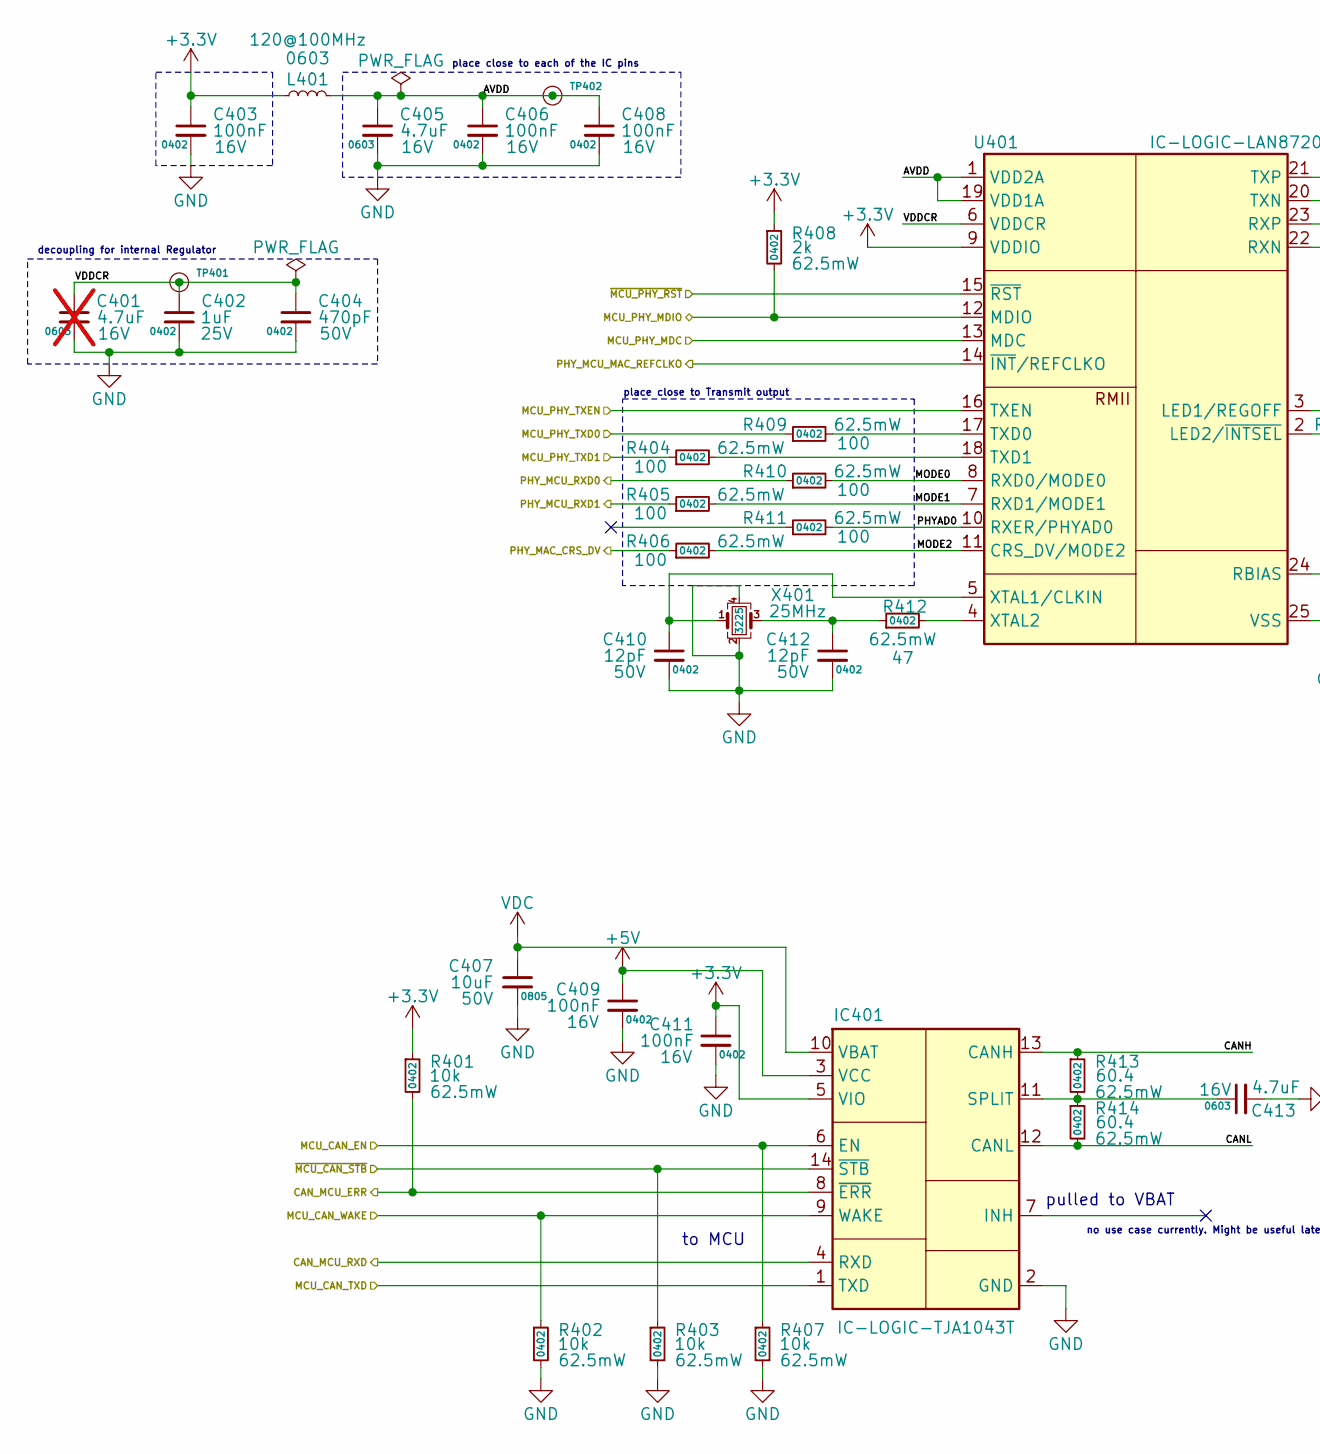
[picture p43: schematic Communication.kicad_sch, Motor Controller Prototype, part in row 1, column 1]

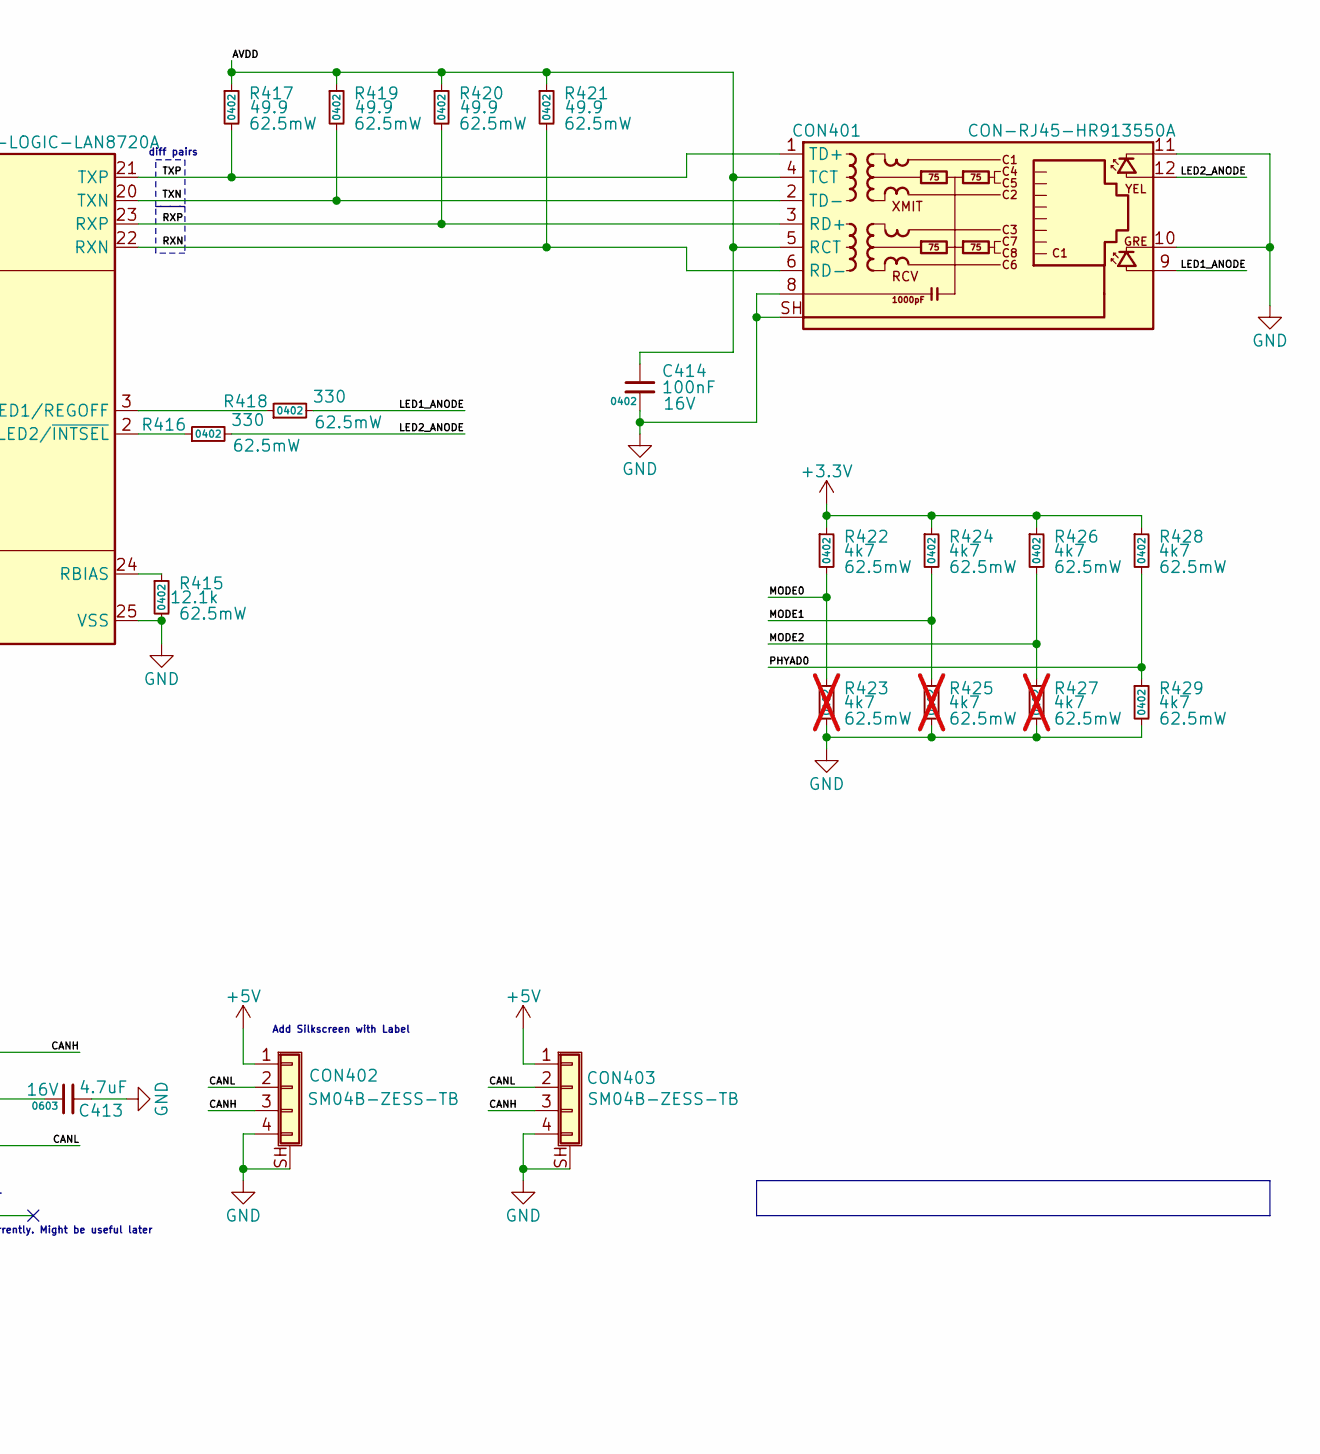
[picture p44: schematic Communication.kicad_sch, Motor Controller Prototype, part in row 1, column 2]

Parts:
C401: 4.7uF; C_0603_1608Metric; Voltage 16V; LCSC Part # C19666; not fitted
C402: 1uF; C_0402_1005Metric; Voltage 25V; LCSC Part # C52923
C403, C406, C408, C409, C411, C414: 100nF; C_0402_1005Metric; Voltage 16V; LCSC Part # C1525
C404: 470pF; C_0402_1005Metric; Voltage 50V; LCSC Part # C1537
C405, C413: 4.7uF; C_0603_1608Metric; Voltage 16V; LCSC Part # C19666
C407: 10uF; C_0805_2012Metric; Voltage 50V; LCSC Part # C440198
C410, C412: 12pF; C_0402_1005Metric; Voltage 50V; LCSC Part # C1547
CON401: CON-RJ45-HR913550A; CON-RJ45-HR911105A-H; LCSC Part # C163507
CON402, CON403: SM04B-ZESS-TB; CON-SM04B-ZESS-TB
IC401: IC-LOGIC-TJA1043T; SOIC-14_3.9x8.7mm_P1.27mm; LCSC Part # C140826
L401: FB-BLM18PG121SN1; L_0603_1608Metric; LCSC Part # C14709
R401, R402, R403, R407: 10k; R_0402_1005Metric; Power Rating 62.5mW; LCSC Part # C25744
R404, R405, R406, R409, R410, R411: 100; R_0402_1005Metric; Power Rating 62.5mW; LCSC Part # C25076
R408: 2k; R_0402_1005Metric; Power Rating 62.5mW; LCSC Part # C4109
R412: 47; R_0402_1005Metric; Power Rating 62.5mW; LCSC Part # C25118
R413, R414: 60.4; R_0402_1005Metric; Power Rating 62.5mW; LCSC Part # C60310
R415: 12.1k; R_0402_1005Metric; Power Rating 62.5mW; LCSC Part # C25852
R416, R418: 330; R_0402_1005Metric; Power Rating 62.5mW; LCSC Part # C25104
R417, R419, R420, R421: 49.9; R_0402_1005Metric; Power Rating 62.5mW; LCSC Part # C25120
R422, R424, R426, R428, R429: 4k7; R_0402_1005Metric; Power Rating 62.5mW; LCSC Part # C25900
R423, R425, R427: 4k7; R_0402_1005Metric; Power Rating 62.5mW; LCSC Part # C25900; not fitted
TP401, TP402: TP; TP_Pad_D0.9mm
U401: IC-LOGIC-LAN8720A; VQFN-24-1EP_4x4mm_P0.5mm_EP2.5x2.5mm_ThermalVias; LCSC Part # C621425
X401: 25MHz; Crystal_SMD_3225-4Pin_3.2x2.5mm; LCSC Part # C9006

Connections:
+3.3V: C403.1, C411.1, IC401.5 (VIO), L401.1, R401.1, R408.1, R422.1, R424.1, R426.1, R428.1, U401.9 (VDDIO); also elsewhere on the board
+5V: C409.1, CON402.1, CON403.1, IC401.3 (VCC); also elsewhere on the board
/Communication/AVDD: C405.1, C406.1, C408.1, C414.1, CON401.4 (TCT), CON401.5 (RCT), L401.2, R417.1, R419.1, R420.1, R421.1, TP402.1, U401.1 (VDD2A), U401.19 (VDD1A)
/Communication/CANH: CON402.3, CON403.3, IC401.13 (CANH), R413.1
/Communication/CANL: CON402.2, CON403.2, IC401.12 (CANL), R414.2
/Communication/CAN_MCU_ERR: IC401.8 (~ERR), R401.2; also elsewhere on the board
/Communication/CAN_MCU_RXD: IC401.4 (RXD); also elsewhere on the board
/Communication/LED1_ANODE: CON401.9, R418.2
/Communication/LED2_ANODE: CON401.12, R416.2
/Communication/MCU_CAN_EN: IC401.6 (EN), R407.1; also elsewhere on the board
/Communication/MCU_CAN_TXD: IC401.1 (TXD); also elsewhere on the board
/Communication/MCU_CAN_WAKE: IC401.9 (WAKE), R402.1; also elsewhere on the board
/Communication/MCU_PHY_MDC: U401.13 (MDC); also elsewhere on the board
/Communication/MCU_PHY_MDIO: R408.2, U401.12 (MDIO); also elsewhere on the board
/Communication/MCU_PHY_TXD0: R409.1; also elsewhere on the board
/Communication/MCU_PHY_TXD1: R404.1; also elsewhere on the board
/Communication/MCU_PHY_TXEN: U401.16 (TXEN); also elsewhere on the board
/Communication/MODE0: R410.2, R422.2, R423.1, U401.8 (RXD0/MODE0)
/Communication/MODE1: R405.2, R424.2, R425.1, U401.7 (RXD1/MODE1)
/Communication/MODE2: R406.2, R426.2, R427.1, U401.11 (CRS_DV/MODE2)
/Communication/PHYAD0: R411.2, R428.2, R429.1, U401.10 (RXER/PHYAD0)
/Communication/PHY_MAC_CRS_DV: R406.1; also elsewhere on the board
/Communication/PHY_MCU_MAC_REFCLKO: U401.14 (~INT/REFCLKO); also elsewhere on the board
/Communication/PHY_MCU_RXD0: R410.1; also elsewhere on the board
/Communication/PHY_MCU_RXD1: R405.1; also elsewhere on the board
/Communication/RXN: CON401.6 (RD-), R421.2, U401.22 (RXN)
/Communication/RXP: CON401.3 (RD+), R420.2, U401.23 (RXP)
/Communication/TXN: CON401.2 (TD-), R419.2, U401.20 (TXN)
/Communication/TXP: CON401.1 (TD+), R417.2, U401.21 (TXP)
/Communication/VDDCR: C401.1, C402.1, C404.1, TP401.1, U401.6 (VDDCR)
/Communication/~MCU_CAN_STB: IC401.14 (~STB), R403.1; also elsewhere on the board
/Communication/~MCU_PHY_RST: U401.15 (~RST); also elsewhere on the board
GND: C401.2, C402.2, C403.2, C404.2, C405.2, C406.2, C407.2, C408.2, C409.2, C410.2, C411.2, C412.2, C413.2, C414.2, CON401.8, CON401.10, CON401.11, CON401.SH, CON402.4, CON402.SH (Shield), CON403.4, CON403.SH (Shield), IC401.2 (GND), R402.2, R403.2, R407.2, R415.2, R423.2, R425.2, R427.2, R429.2, U401.25 (VSS), X401.2, X401.4; also elsewhere on the board
unnamed: C412.1, R412.1, X401.3
unnamed: C413.1, IC401.11 (SPLIT), R413.2, R414.1
unnamed: R418.1, U401.3 (LED1/REGOFF)
unnamed: R416.1, U401.2 (LED2/~INTSEL)
unnamed: R415.1, U401.24 (RBIAS)
unnamed: R409.2, U401.17 (TXD0)
unnamed: R404.2, U401.18 (TXD1)
unnamed: C410.1, U401.5 (XTAL1/CLKIN), X401.1
unnamed: R412.2, U401.4 (XTAL2)
VDC: C407.1, IC401.10 (VBAT); also elsewhere on the board

Notes on the sheet:
pulled to VBAT
place close to Transmit output
place close to each of the IC pins
to MCU
Add Silkscreen with Label
diff pairs
decoupling for internal Regulator
no use case currently. Might be useful later
