Nightshadow1258/HW_Motor_Controller/KiCAD/Motor_Controller/Motor_Controller.kicad_pcb

## KiCad design KiCAD/Motor_Controller/Motor_Controller.kicad_pcb (continued)

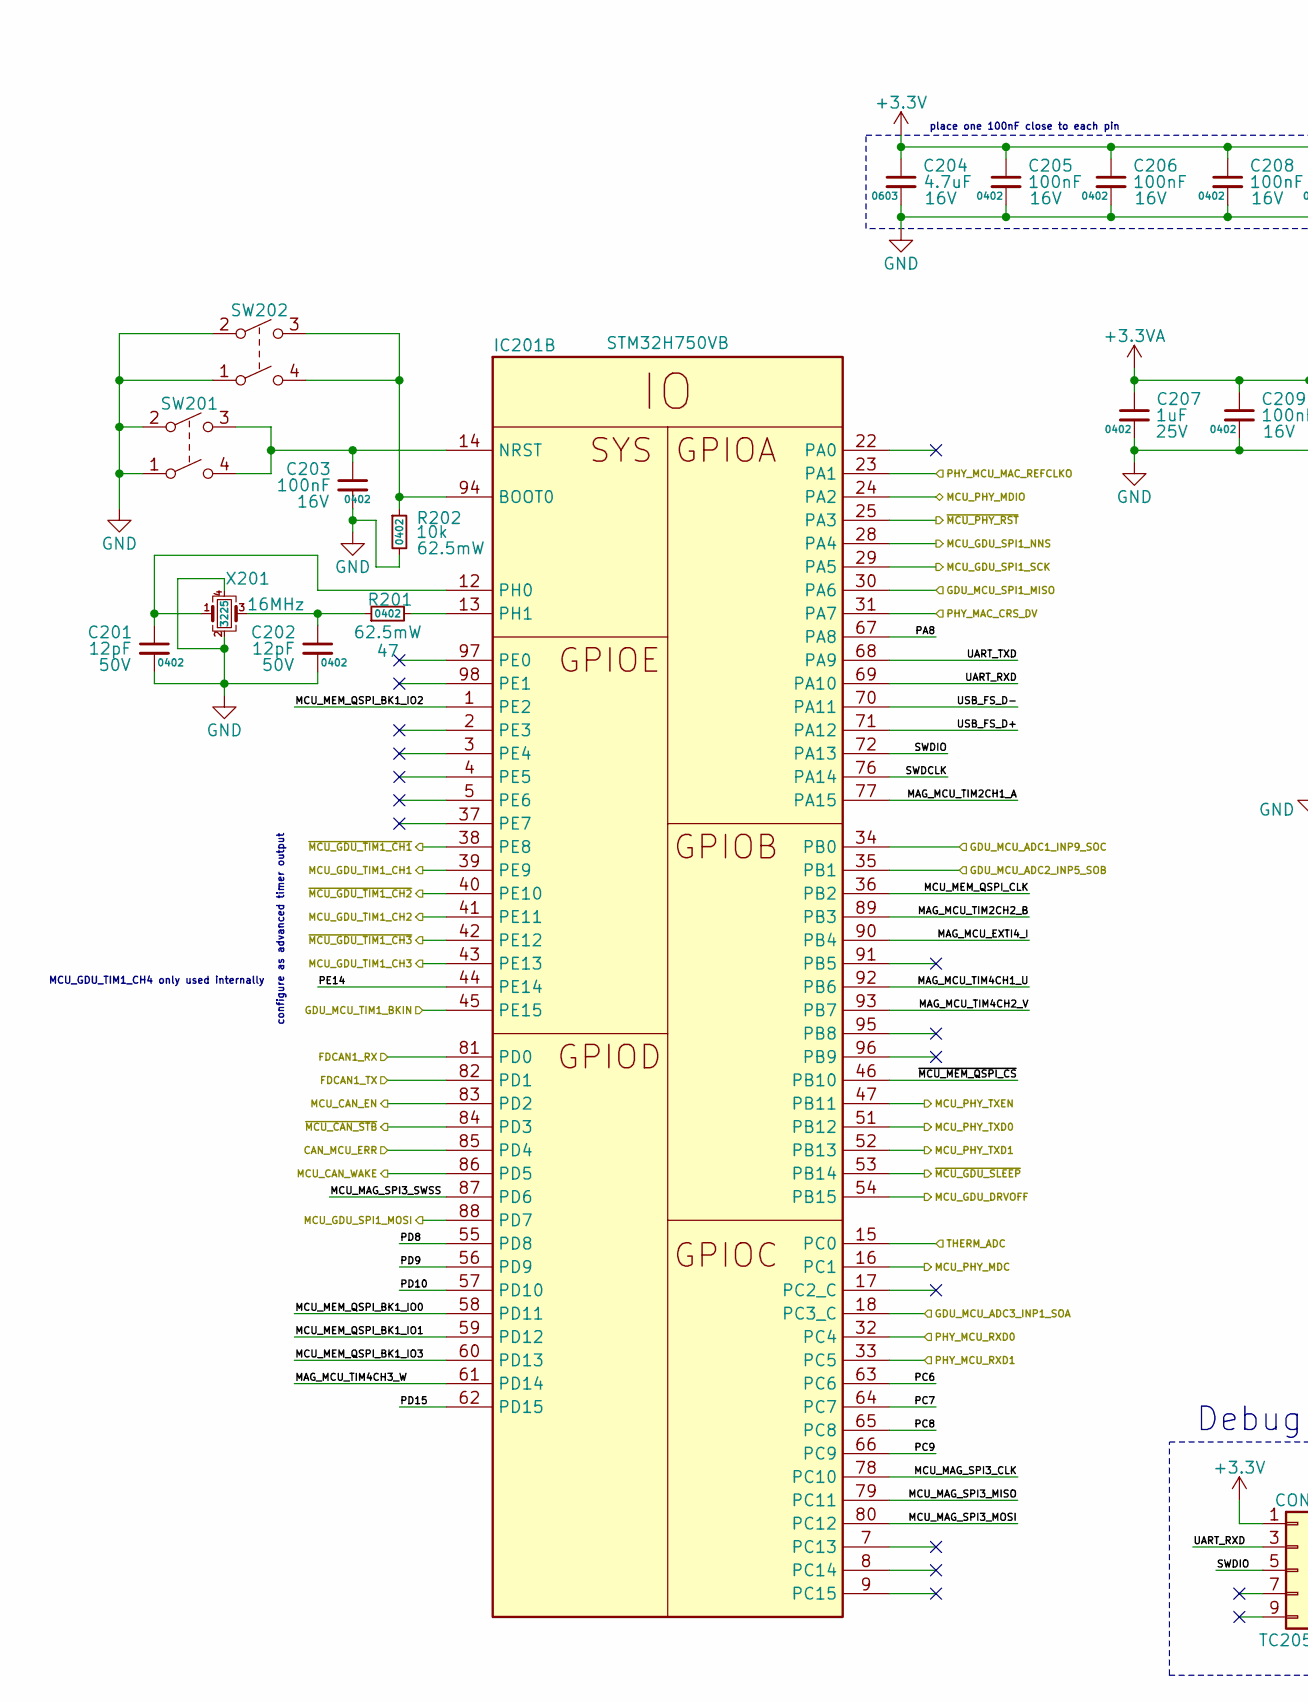
[picture p45: schematic MCU.kicad_sch, Motor Controller Prototype, part in row 1, column 1]

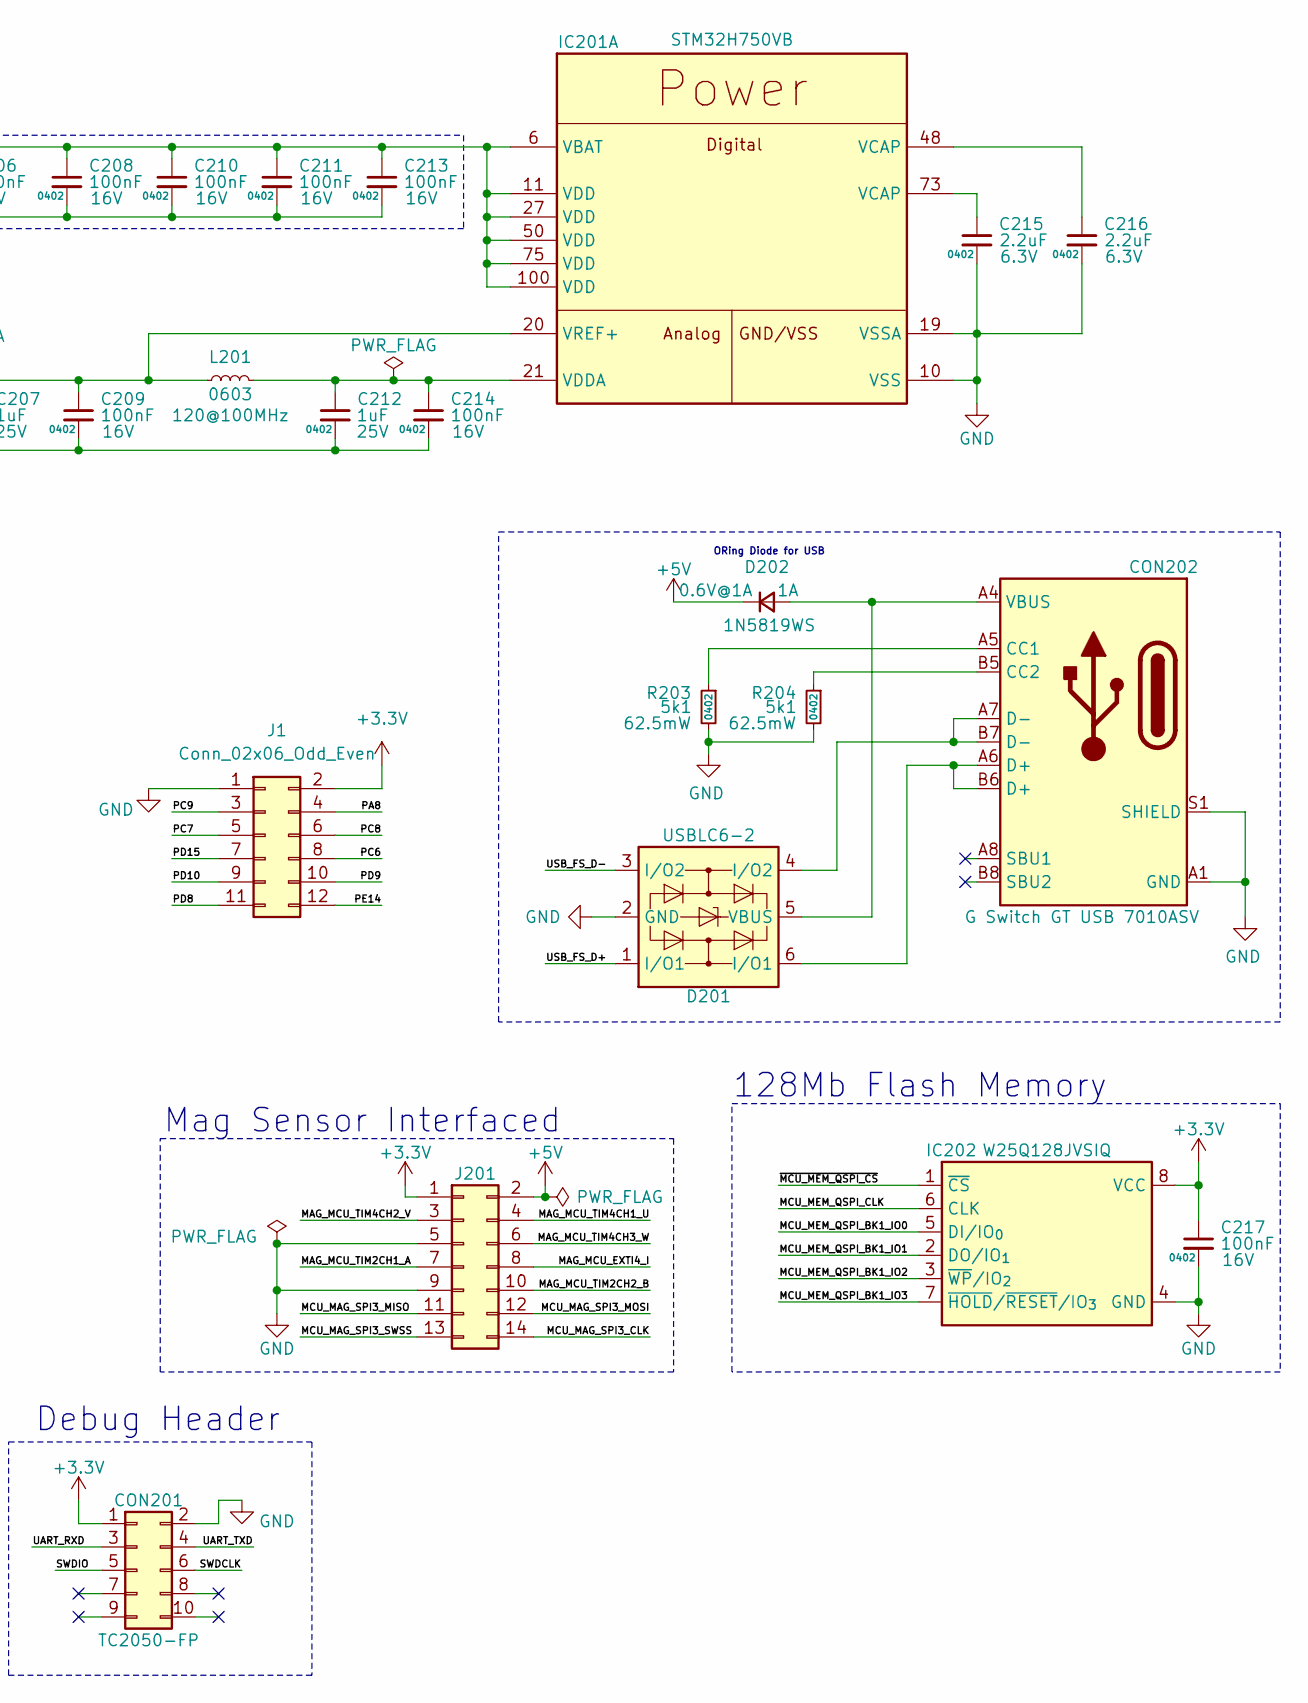
[picture p46: schematic MCU.kicad_sch, Motor Controller Prototype, part in row 1, column 2]

Parts:
C201, C202: 12pF; C_0402_1005Metric; Voltage 50V; LCSC Part # C1547
C203, C205, C206, C208, C209, C210, C211, C213, C214, C217: 100nF; C_0402_1005Metric; Voltage 16V; LCSC Part # C1525
C204: 4.7uF; C_0603_1608Metric; Voltage 16V; LCSC Part # C19666
C207, C212: 1uF; C_0402_1005Metric; Voltage 25V; LCSC Part # C52923
C215, C216: 2.2uF; C_0402_1005Metric; Voltage 6.3V; LCSC Part # C12530
CON201: TC2050-FP; CON-TAG-CONNECT_TC2050-IDC
CON202: G Switch GT USB 7010ASV; CON-GEN-USB_C-16P; LCSC Part # C2988369
D201: USBLC6-2; SOT-23-6; LCSC Part # C7519
D202: 1N5819WS; D_SOD-323; LCSC Part # C191023
IC201: STM32H750VB; LQFP-100_14x14mm_P0.5mm; LCSC Part # C404010
IC202: W25Q128JVSIQ; SOIC-8_5.3x5.3mm_P1.27mm; LCSC Part # C97521
J1: Conn_02x06_Odd_Even; PinHeader_2x06_P2.54mm_Vertical
J201: Conn_02x07_Odd_Even; PinHeader_2x07_P2.54mm_Vertical
L201: FB-BLM18PG121SN1; L_0603_1608Metric; LCSC Part # C14709
R201: 47; R_0402_1005Metric; Power Rating 62.5mW; LCSC Part # C25118
R202: 10k; R_0402_1005Metric; Power Rating 62.5mW; LCSC Part # C25744
R203, R204: 5k1; R_0402_1005Metric; Power Rating 62.5mW; LCSC Part # C25905
SW201, SW202: SW-GEN-TS-1187A; SW-PUSH-DPST-XKS-TS-1187A; LCSC Part # C318884
X201: 16MHz; Crystal_SMD_3225-4Pin_3.2x2.5mm; LCSC Part # C12668

Connections:
+3.3V: C204.1, C205.1, C206.1, C208.1, C210.1, C211.1, C213.1, C217.1, CON201.1, IC201.6 (VBAT), IC201.11 (VDD), IC201.27 (VDD), IC201.50 (VDD), IC201.75 (VDD), IC201.100 (VDD), IC202.8 (VCC), J1.2, J201.1; also elsewhere on the board
+3.3VA: C207.1, C209.1, IC201.20 (VREF+), L201.1; also elsewhere on the board
+5V: D202.1 (K), J201.2; also elsewhere on the board
/Communication/CAN_MCU_ERR: IC201.85 (PD4); also elsewhere on the board
/Communication/CAN_MCU_RXD: IC201.81 (PD0); also elsewhere on the board
/Communication/MCU_CAN_EN: IC201.83 (PD2); also elsewhere on the board
/Communication/MCU_CAN_TXD: IC201.82 (PD1); also elsewhere on the board
/Communication/MCU_CAN_WAKE: IC201.86 (PD5); also elsewhere on the board
/Communication/MCU_PHY_MDC: IC201.16 (PC1); also elsewhere on the board
/Communication/MCU_PHY_MDIO: IC201.24 (PA2); also elsewhere on the board
/Communication/MCU_PHY_TXD0: IC201.51 (PB12); also elsewhere on the board
/Communication/MCU_PHY_TXD1: IC201.52 (PB13); also elsewhere on the board
/Communication/MCU_PHY_TXEN: IC201.47 (PB11); also elsewhere on the board
/Communication/PHY_MAC_CRS_DV: IC201.31 (PA7); also elsewhere on the board
/Communication/PHY_MCU_MAC_REFCLKO: IC201.23 (PA1); also elsewhere on the board
/Communication/PHY_MCU_RXD0: IC201.32 (PC4); also elsewhere on the board
/Communication/PHY_MCU_RXD1: IC201.33 (PC5); also elsewhere on the board
/Communication/~MCU_CAN_STB: IC201.84 (PD3); also elsewhere on the board
/Communication/~MCU_PHY_RST: IC201.25 (PA3); also elsewhere on the board
/MCU Board/GDU_MCU_ADC1_INP9_SOA: IC201.18 (PC3_C); also elsewhere on the board
/MCU Board/GDU_MCU_ADC2_INP5_SOB: IC201.35 (PB1); also elsewhere on the board
/MCU Board/GDU_MCU_ADC3_INP1_SOC: IC201.34 (PB0); also elsewhere on the board
/MCU Board/GDU_MCU_SPI1_MISO: IC201.30 (PA6); also elsewhere on the board
/MCU Board/GDU_MCU_TIM1_BKIN: IC201.45 (PE15); also elsewhere on the board
/MCU Board/MAG_MCU_EXTI4_I: IC201.90 (PB4), J201.8
/MCU Board/MAG_MCU_TIM2CH1_A: IC201.77 (PA15), J201.7
/MCU Board/MAG_MCU_TIM2CH2_B: IC201.89 (PB3), J201.10
/MCU Board/MAG_MCU_TIM4CH1_U: IC201.92 (PB6), J201.4
/MCU Board/MAG_MCU_TIM4CH2_V: IC201.93 (PB7), J201.3
/MCU Board/MAG_MCU_TIM4CH3_W: IC201.61 (PD14), J201.6
/MCU Board/MCU_GDU_DRVOFF: IC201.54 (PB15); also elsewhere on the board
/MCU Board/MCU_GDU_SPI1_MOSI: IC201.88 (PD7); also elsewhere on the board
/MCU Board/MCU_GDU_SPI1_NNS: IC201.28 (PA4); also elsewhere on the board
/MCU Board/MCU_GDU_SPI1_SCK: IC201.29 (PA5); also elsewhere on the board
/MCU Board/MCU_GDU_TIM1_CH1: IC201.39 (PE9); also elsewhere on the board
/MCU Board/MCU_GDU_TIM1_CH2: IC201.41 (PE11); also elsewhere on the board
/MCU Board/MCU_GDU_TIM1_CH3: IC201.43 (PE13); also elsewhere on the board
/MCU Board/MCU_MAG_SPI3_CLK: IC201.78 (PC10), J201.14
/MCU Board/MCU_MAG_SPI3_MISO: IC201.79 (PC11), J201.11
/MCU Board/MCU_MAG_SPI3_MOSI: IC201.80 (PC12), J201.12
/MCU Board/MCU_MAG_SPI3_SWSS: IC201.87 (PD6), J201.13
/MCU Board/MCU_MEM_QSPI_BK1_IO0: IC201.58 (PD11), IC202.5 (DI/IO_{0})
/MCU Board/MCU_MEM_QSPI_BK1_IO1: IC201.59 (PD12), IC202.2 (DO/IO_{1})
/MCU Board/MCU_MEM_QSPI_BK1_IO2: IC201.1 (PE2), IC202.3 (~WP/IO_{2})
/MCU Board/MCU_MEM_QSPI_BK1_IO3: IC201.60 (PD13), IC202.7 (~HOLD/~RESET/IO_{3})
/MCU Board/MCU_MEM_QSPI_CLK: IC201.36 (PB2), IC202.6 (CLK)
/MCU Board/PA8: IC201.67 (PA8), J1.4
/MCU Board/PC6: IC201.63 (PC6), J1.8
/MCU Board/PC7: IC201.64 (PC7), J1.5
/MCU Board/PC8: IC201.65 (PC8), J1.6
/MCU Board/PC9: IC201.66 (PC9), J1.3
/MCU Board/PD8: IC201.55 (PD8), J1.11
/MCU Board/PD9: IC201.56 (PD9), J1.10
/MCU Board/PD10: IC201.57 (PD10), J1.9
/MCU Board/PD15: IC201.62 (PD15), J1.7
/MCU Board/PE14: IC201.44 (PE14), J1.12
/MCU Board/SWDCLK: CON201.6, IC201.76 (PA14)
/MCU Board/SWDIO: CON201.5, IC201.72 (PA13)
/MCU Board/THERM_ADC: IC201.15 (PC0); also elsewhere on the board
/MCU Board/UART_RXD: CON201.3, IC201.69 (PA10)
/MCU Board/UART_TXD: CON201.4, IC201.68 (PA9)
/MCU Board/USB_FS_D+: D201.1 (I/O1), IC201.71 (PA12)
/MCU Board/USB_FS_D-: D201.3 (I/O2), IC201.70 (PA11)
/MCU Board/~MCU_GDU_SLEEP: IC201.53 (PB14); also elsewhere on the board
/MCU Board/~MCU_GDU_TIM1_CH1: IC201.38 (PE8); also elsewhere on the board
/MCU Board/~MCU_GDU_TIM1_CH2: IC201.40 (PE10); also elsewhere on the board
/MCU Board/~MCU_GDU_TIM1_CH3: IC201.42 (PE12); also elsewhere on the board
/MCU Board/~MCU_MEM_QSPI_CS: IC201.46 (PB10), IC202.1 (~CS)
GND: C201.2, C202.2, C203.2, C204.2, C205.2, C206.2, C207.2, C208.2, C209.2, C210.2, C211.2, C212.2, C213.2, C214.2, C215.2, C216.2, C217.2, CON201.2, CON202.A1 (GND), CON202.A12 (GND), CON202.B1 (GND), CON202.B12 (GND), CON202.S1 (SHIELD), D201.2 (GND), IC201.10 (VSS), IC201.19 (VSSA), IC201.26 (VSS), IC201.49 (VSS), IC201.74 (VSS), IC201.99 (VSS), IC202.4 (GND), J1.1, J201.5, J201.9, R202.2, R203.2, R204.2, SW201.1, SW201.2 (3), SW202.1, SW202.2 (3), X201.2, X201.4; also elsewhere on the board
unnamed: C202.1, R201.1, X201.3
unnamed: C215.1, IC201.73 (VCAP)
unnamed: C216.1, IC201.48 (VCAP)
unnamed: CON202.A5 (CC1), R203.1
unnamed: CON202.B5 (CC2), R204.1
unnamed: CON202.A6 (D+), CON202.B6 (D+), D201.6 (I/O1)
unnamed: CON202.A7 (D-), CON202.B7 (D-), D201.4 (I/O2)
unnamed: CON202.A4 (VBUS), CON202.A9 (VBUS), CON202.B4 (VBUS), CON202.B9 (VBUS), D201.5 (VBUS), D202.2 (A)
unnamed: C212.1, C214.1, IC201.21 (VDDA), L201.2
unnamed: IC201.94 (BOOT0), R202.1, SW202.3 (4), SW202.4
unnamed: C203.1, IC201.14 (NRST), SW201.3 (4), SW201.4
unnamed: C201.1, IC201.12 (PH0), X201.1
unnamed: IC201.13 (PH1), R201.2

Notes on the sheet:
Mag Sensor Interfaced
ORing Diode for USB
128Mb Flash Memory
MCU_GDU_TIM1_CH4 only used internally
Debug Header
configure as advanced timer output
place one 100nF close to each pin

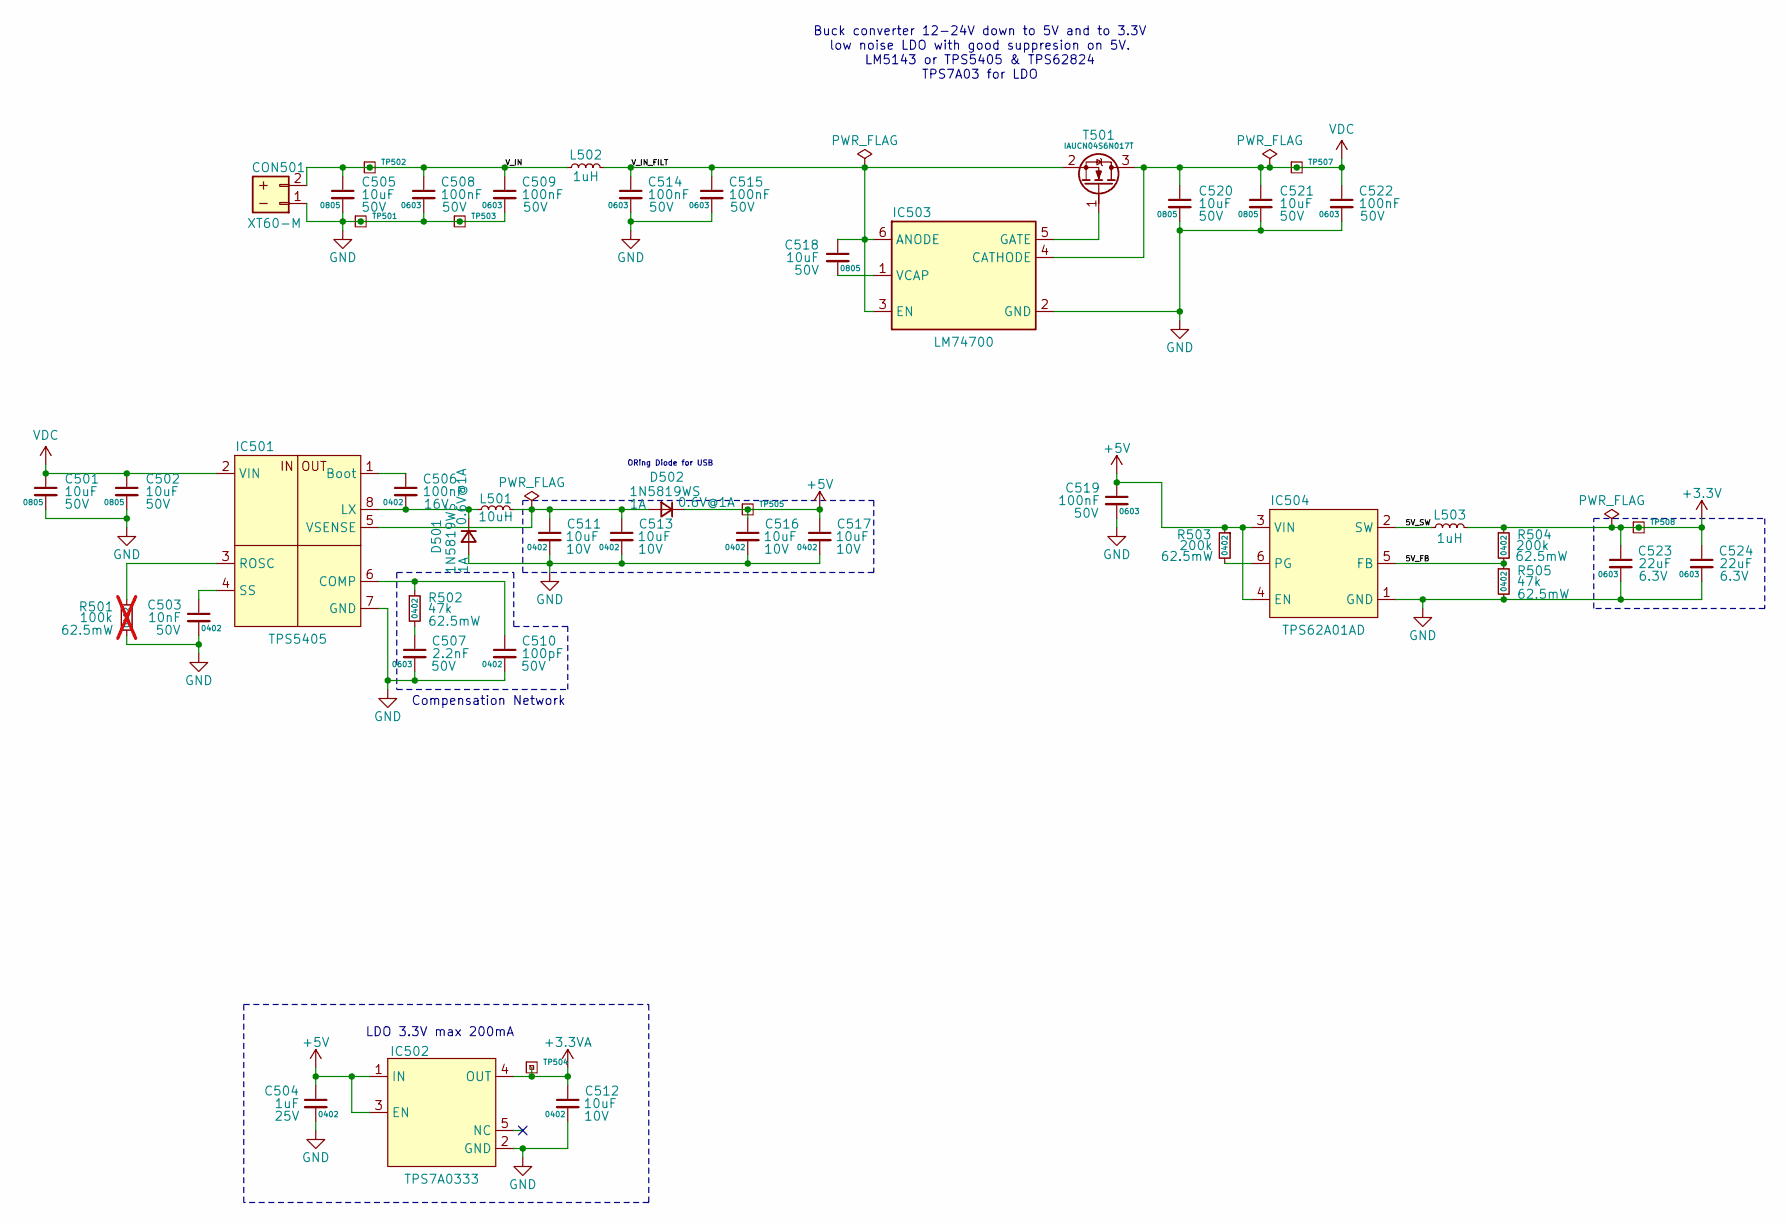
[picture p47: schematic Power.kicad_sch, Motor Controller Prototype]

Parts:
C501, C502, C505, C518, C520, C521: 10uF; C_0805_2012Metric; Voltage 50V; LCSC Part # C440198
C503: 10nF; C_0402_1005Metric; Voltage 50V; LCSC Part # C15195
C504: 1uF; C_0402_1005Metric; Voltage 25V; LCSC Part # C52923
C506: 100nF; C_0402_1005Metric; Voltage 16V; LCSC Part # C1525
C507: 2.2nF; C_0603_1608Metric; Voltage 50V; LCSC Part # C1604
C508, C509, C514, C515, C519, C522: 100nF; C_0603_1608Metric; Voltage 50V; LCSC Part # C14663
C510: 100pF; C_0402_1005Metric; Voltage 50V; LCSC Part # C1546
C511, C512, C513, C516, C517: 10uF; C_0603_1608Metric; Voltage 10V; LCSC Part # C96446
C523, C524: 22uF; C_0805_2012Metric; Voltage 6.3V; LCSC Part # C59461
CON501: XT60-M; AMASS_XT60-M_1x02_P7.20mm_Vertical
D501, D502: 1N5819WS; D_SOD-323; LCSC Part # C191023
IC501: TPS5405; SOIC-8_3.9x4.9mm_P1.27mm; LCSC Part # C488409
IC502: TPS7A0333; SOT-23-5; LCSC Part # C2873330
IC503: LM74700; SOT-23-6; LCSC Part # C2941042
IC504: TPS62A01AD; SOT-563; LCSC Part # C5181455
L501: 10uH; L_SXN_SMNR4020; LCSC Part # C135263
L502: 1uH; L_Coilcraft_XAL7030-102; LCSC Part # C19191626
L503: 1uH; L_1008_2520Metric; LCSC Part # C435392
R501: 100k; R_0402_1005Metric; Power Rating 62.5mW; LCSC Part # C25741; not fitted
R502, R505: 47k; R_0402_1005Metric; Power Rating 62.5mW; LCSC Part # C25792
R503, R504: 200k; R_0402_1005Metric; Power Rating 62.5mW; LCSC Part # C25764
T501: IAUCN04S6N017T; T-MOSN-LHDSO-10-1
TP501, TP502, TP503, TP504, TP505, TP507, TP508: Testpoint-BASE; TP_THT_D0.8mm

Connections:
+3.3V: C523.1, C524.1, L503.2, R504.1, TP508.1; also elsewhere on the board
+3.3VA: C512.1, IC502.4 (OUT), TP504.1; also elsewhere on the board
+5V: C504.1, C516.1, C517.1, C519.1, D502.1 (K), IC502.1 (IN), IC502.3 (EN), IC504.3 (VIN), IC504.4 (EN), R503.1, TP505.1; also elsewhere on the board
/Power/5V_FB: IC504.5 (FB), R504.2, R505.1
/Power/5V_SW: IC504.2 (SW), L503.1
/Power/V_IN: C505.1, C508.1, C509.1, CON501.2 (+), L502.1, TP502.1
/Power/V_IN_FILT: C514.1, C515.1, C518.1, IC503.3 (EN), IC503.6 (ANODE), L502.2, T501.2 (S)
GND: C501.2, C502.2, C503.2, C504.2, C505.2, C507.2, C508.2, C509.2, C510.2, C511.2, C512.2, C513.2, C514.2, C515.2, C516.2, C517.2, C519.2, C520.2, C521.2, C522.2, C523.2, C524.2, CON501.1 (-), D501.2 (A), IC501.7 (GND), IC502.2 (GND), IC503.2 (GND), IC504.1 (GND), R501.2, R505.2, TP501.1, TP503.1; also elsewhere on the board
unnamed: C507.1, R502.2
unnamed: C506.2, D501.1 (K), IC501.8 (LX), L501.1
unnamed: C511.1, C513.1, D502.2 (A), IC501.5 (VSENSE), L501.2
unnamed: C506.1, IC501.1 (Boot)
unnamed: C510.1, IC501.6 (COMP), R502.1
unnamed: IC501.3 (ROSC), R501.1
unnamed: C503.1, IC501.4 (SS)
unnamed: IC503.5 (GATE), T501.1 (G)
unnamed: C518.2, IC503.1 (VCAP)
unnamed: IC504.6 (PG), R503.2
VDC: C501.1, C502.1, C520.1, C521.1, C522.1, IC501.2 (VIN), IC503.4 (CATHODE), T501.3 (D), TP507.1; also elsewhere on the board

Notes on the sheet:
LDO 3.3V max 200mA
ORing Diode for USB
Buck converter 12-24V down to 5V and to 3.3V low noise LDO with good suppresion on 5V. LM5143 or TPS5405 & TPS62824 TPS7A03 for LDO
Compensation Network

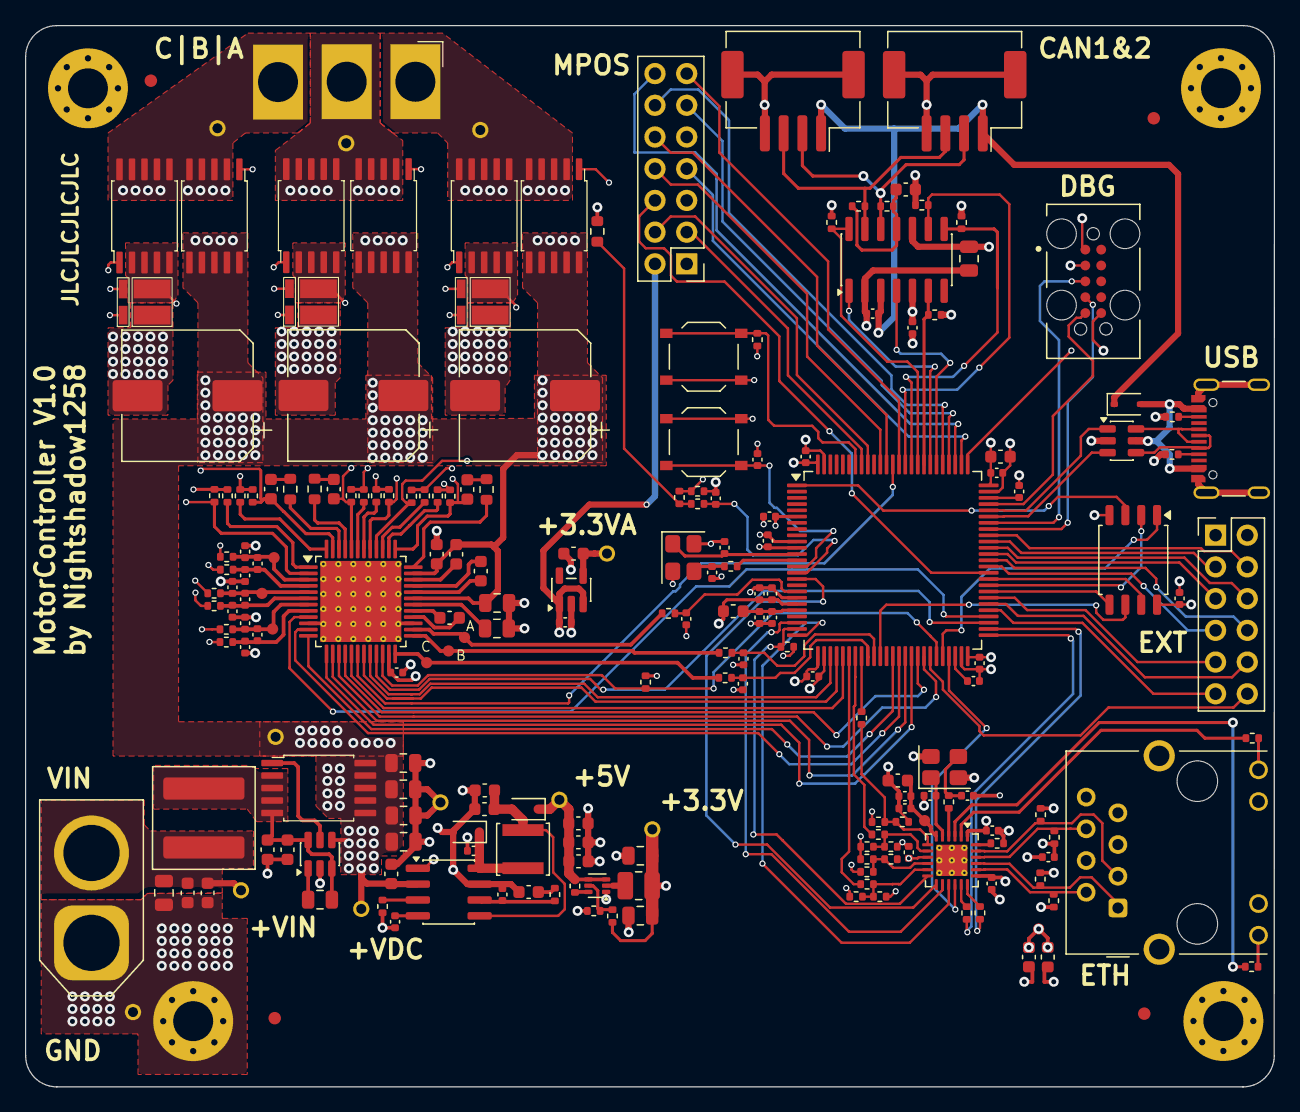
[picture p48: board Motor_Controller.kicad_pcb from above]

Board: 4 copper layers, 100.0 x 85.0 mm, 216 parts (0 on the bottom side), 166 nets.
