Nightshadow1258/HW_Motor_Controller/KiCAD/AS5047P_DevKit/AS5047P_DevKit.kicad_pcb

## KiCad design KiCAD/AS5047P_DevKit/AS5047P_DevKit.kicad_pcb (2026-01-08)

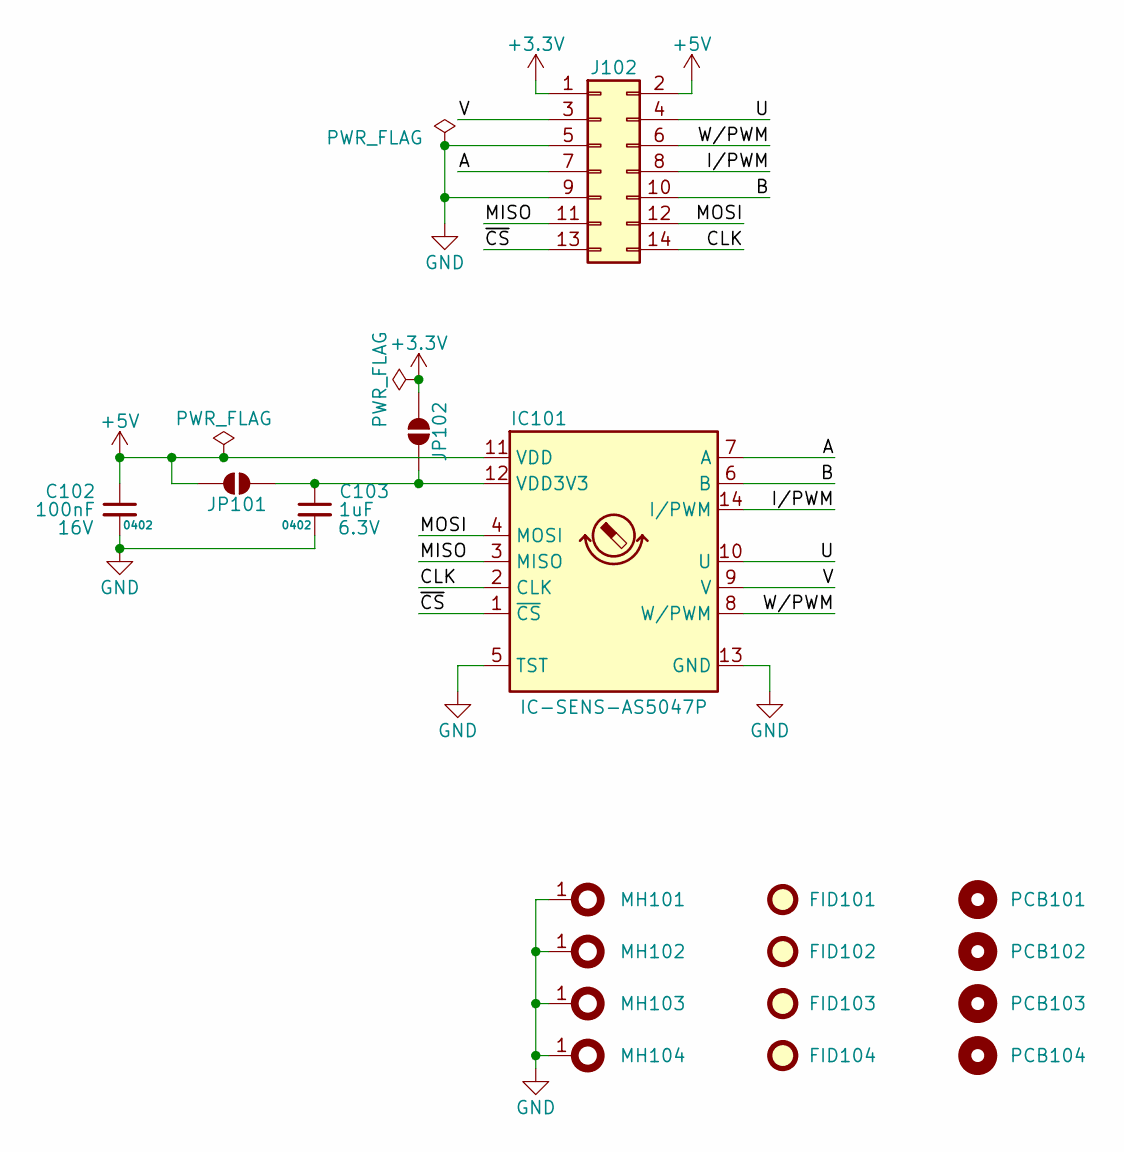
[picture p49: schematic AS5047P_DevKit.kicad_sch]

Parts:
C102: 100nF; C_0402_1005Metric; Voltage 16V; LCSC Part # C1525
C103: 1uF; C_0402_1005Metric; Voltage 6.3V; LCSC Part # C15525
FID101, FID102, FID103, FID104: Fiducal-JLCPPCB; PCB-FID-JLCPCB
IC101: IC-SENS-AS5047P; TSSOP-14_4.4x5mm_P0.65mm; LCSC Part # C962063
J102: Conn_02x07_Odd_Even; PinHeader_2x07_P2.54mm_Vertical
JP101, JP102: SolderJumper_2_Open; SolderJumper-2_P1.3mm_Open_RoundedPad1.0x1.5mm
MH101, MH102, MH103, MH104: MountingHole_2.5mm_Pad_Via
PCB101, PCB102, PCB103, PCB104: Tooling Hole JLCPCB; PCB-NPTH-JLCPCB

Connections:
+3.3V: J102.1, JP102.1 (A)
+5V: C102.1, IC101.11 (VDD), J102.2, JP101.2 (B)
/A: IC101.7 (A), J102.7
/B: IC101.6 (B), J102.10
/CLK: IC101.2 (CLK), J102.14
/I/PWM: IC101.14 (I/PWM), J102.8
/MISO: IC101.3 (MISO), J102.11
/MOSI: IC101.4 (MOSI), J102.12
/U: IC101.10 (U), J102.4
/V: IC101.9 (V), J102.3
/W/PWM: IC101.8 (W/PWM), J102.6
/~CS: IC101.1 (~CS), J102.13
GND: C102.2, C103.2, IC101.5 (TST), IC101.13 (GND), J102.5, J102.9, MH101.1, MH102.1, MH103.1, MH104.1
unnamed: C103.1, IC101.12 (VDD3V3), JP101.1 (A), JP102.2 (B)

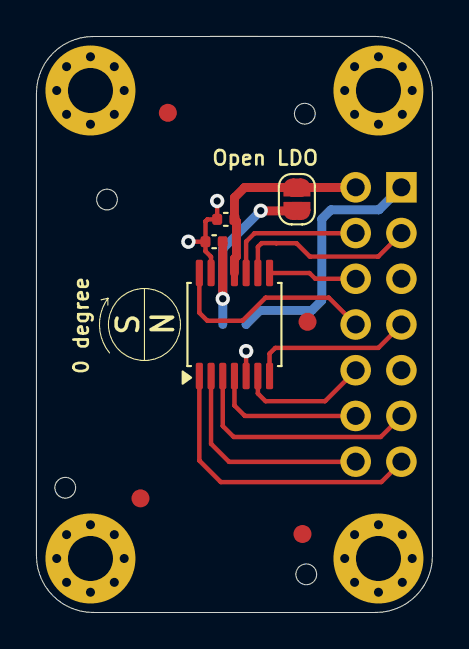
[picture p50: board AS5047P_DevKit.kicad_pcb from above]

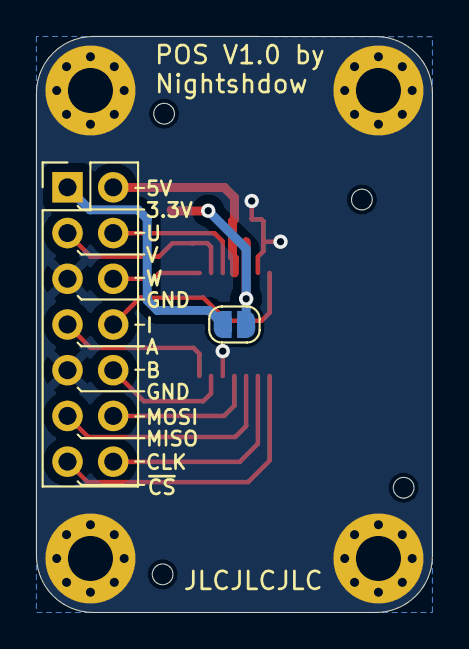
[picture p51: board AS5047P_DevKit.kicad_pcb from below]

Board: 2 copper layers, 22.0 x 32.0 mm, 18 parts (2 on the bottom side), 14 nets.
