Nightshadow1258/HW_Motor_Controller/Documentation/MotorController_STM32H750VB/MotorController_STM32H750VB.ioc

Mcu.UserName=STM32H750VBTx
PA1.Signal=ETH_REF_CLK
PA10.Signal=USART1_RX
PA11.Signal=USB_OTG_FS_DM
PA12.Signal=USB_OTG_FS_DP
PA2.Signal=ETH_MDIO
PA3.GPIO_Label=PHY_RST
PA3.Signal=GPIO_Output
PA4.Signal=SPI1_NSS
PA5.Signal=SPI1_SCK
PA6.Signal=SPI1_MISO
PA7.Signal=ETH_CRS_DV
PA9.Signal=USART1_TX
PB0.Signal=ADCx_INP9
PB1.Signal=ADCx_INP5
PB10.Signal=QUADSPI_BK1_NCS
PB11.Signal=ETH_TX_EN
PB12.Signal=ETH_TXD0
PB13.Signal=ETH_TXD1
PB2.Signal=QUADSPI_CLK
PB6.Signal=S_TIM4_CH1
PB7.Signal=S_TIM4_CH2
PC0.Signal=ADCx_INP10
PC1.Signal=ETH_MDC
PC10.Signal=SPI3_SCK
PC11.Signal=SPI3_MISO
PC12.Signal=SPI3_MOSI
PC3_C.Signal=ADC3_INP1
PC4.Signal=ETH_RXD0
PC5.Signal=ETH_RXD1
PD0.Signal=FDCAN1_RX
PD1.Signal=FDCAN1_TX
PD11.Signal=QUADSPI_BK1_IO0
PD12.Signal=QUADSPI_BK1_IO1
PD13.Signal=QUADSPI_BK1_IO3
PD14.Signal=S_TIM4_CH3
PD2.GPIO_Label=CAN_EN
PD2.Signal=GPIO_Output
PD3.GPIO_Label=CAN_NSTB
PD3.Signal=GPIO_Output
PD4.GPIO_Label=CAN_ERR
PD4.Signal=GPIO_Input
PD5.Signal=GPIO_Output
PD6.GPIO_Label=SPI3_SWSS
PD6.Signal=GPIO_Output
PD7.Signal=SPI1_MOSI
PD8.Signal=GPXTI8
PE10.Signal=TIM1_CH2N
PE11.Signal=S_TIM1_CH2
PE12.Signal=TIM1_CH3N
PE13.Signal=S_TIM1_CH3
PE14.Signal=S_TIM1_CH4
PE15.Signal=TIM1_BKIN
PE2.Signal=QUADSPI_BK1_IO2
PE6.Signal=TIM1_BKIN2
PE8.Signal=TIM1_CH1N
PE9.Signal=S_TIM1_CH1
