Nightshadow1258/HW_Motor_Controller/(commit log)

2026-01-08 initial commit. SCH first draft done & started with Layout.
    [AS5047P_DevKit.kicad_pcb, AS5047P_DevKit.kicad_sch, Communication.kicad_sch, DRV8334_Register_Map.ods, DRV8334_Register_Map.xlsx, GDU_Shunt_selection.ods, MCU.kicad_sch, Motor_Controller.kicad_pcb]
2026-01-09 Continued with the component placement. Still work to do
    [Communication.kicad_sch, MCU.kicad_sch, Motor_Controller.kicad_pcb, Motor_Controller.kicad_sch, Motor_Driver.kicad_sch, Power.kicad_sch]
2026-01-10 changed low side shunt from 0.3mOhm to 1mOhm type and smaller footrprint. Updated rough component placement. Changed 10uH Coil of 5V regulator to smaller footprint due to lower expected current draw 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
    [Communication.kicad_sch, GDU_Shunt_selection.ods, Motor_Controller.kicad_pcb, Motor_Driver.kicad_sch, Power.kicad_sch]
2026-01-12 layout CAN Interface down.
    [AS5047P_DevKit.step, Communication.kicad_sch, Motor_Controller.kicad_pcb]
2026-01-12 layout USB Interface down.
    [MCU.kicad_sch, Motor_Controller.kicad_pcb]
2026-01-15 GDU base routing done. Added SCH pdf for MPS.¨
    [AS5047P_DevKit.kicad_sch, Motor_Controller.kicad_pcb, Motor_Driver.kicad_sch]
2026-02-04 Prototype Design finished and ordered.
    [Communication.kicad_sch, MCU.kicad_sch, Motor_Controller.kicad_pcb, Motor_Controller.kicad_sch, Motor_Driver.kicad_sch, Power.kicad_sch, bom.csv, designators.csv]
2026-07-26 updated GDU_Register Map for initial values during development testing.
    [AS5047P_4096_BLDC_Mot.csv, AS5047P_4096_BLDC_Mot_allegro_32_eeprom_registers.csv, AS5047P_4096_BLDC_Mot_calc_corr.csv, AS5047P_4096_BLDC_Mot_calc_corr_2.csv, AS5047P_4096_BLDC_Mot_harmonic_optimization_parameters.csv, AS5047P_4096_BLDC_Mot_test.csv, AS5047P_4096_BLDC_Mot_test_allegro_32_eeprom_registers.csv, AS5047P_4096_BLDC_Mot_test_harmonic_optimization_parameters.csv]
